Fefe-Nayz/kbhe-monorepo/docs/README.md

# Documentation

- `firmware/` contains firmware protocol and flashing documentation.
- [firmware/overview.md](firmware/overview.md) — build, tools, and **first-time flash of a new board** (DFU, STM32CubeProgrammer, addresses for bootloader vs application, then RAW HID).
- [firmware/raw_hid_usage.md](firmware/raw_hid_usage.md) — everyday flashing over HID after the board is set up.
- `hardware/` contains PCB and mechanical notes.
- [releases.md](releases.md) explains how GitHub release tags map to app and firmware updates.
