Fefe-Nayz/kbhe-monorepo/hardware/pcb/75he/Docs/README.md

# Component Documentation

This folder contains datasheets and reference documents for the current root `75he.kicad_pro` PCB only. Legacy projects keep their own reduced copies under `Legacy/<project>/Docs/`.

## Covered Components

- STM32F723VE MCU: `stm32f723ve.pdf`
- DRV5055 hall-effect sensors: `drv5055-q1.pdf`
- SN74LV4051A analog multiplexers: `sn74lv4051a.pdf`
- SN74AHCT1G125 buffer: `sn74ahct1g125.pdf`
- TS3USB221 USB switch: `ts3usb221a.pdf`
- TPS7A4701 regulator: `tps7a47.pdf`
- LDL1117 regulator: `ldl1117.pdf`
- USBLC6 USB ESD protection: `usblc6-2-3.pdf`
- 1812L300 resettable fuse reference: `Littelfuse-PPTC-Low-Rho-Datasheet.pdf`
- 75HE / Gateron Magnetic Jade switch: `GATERONMagneticJadeProSwitchKS-20TF10B045NW-Y106.pdf`
- WS2812B RGB LED package: `2406131538_XINGLIGHT-XL-5050RGBC-WS2812B-S_C22461793.pdf`
- EC11 encoder: `alps_alps-s-a0008379064-1.pdf`
- USB-C connector: `0EF8F885FCCEA71F60E9E85152155021.pdf`
- SK-12D02VG3 slide switch: `C131374.pdf`
- Red LED C2286: `C2286.pdf`
- Green LED C2297: `C2297.pdf`
- Crystal C280836: `C280836.pdf`
- TS-1088 tactile switch: `C720477.pdf`

## Missing Component Docs

No missing component documentation is currently identified for the root PCB.

## Intentionally Not Documented

Generic passives, solder pads, mounting holes, jumpers, and logos are not tracked as component documentation unless a specific vendor part is required for manufacturing.
