Fefe-Nayz/kbhe-monorepo/hardware/pcb/75he/Legacy/proto-6-key-hall-sensors/Docs/README.md

# Component Documentation

Reduced documentation set for `proto-6-key-hall-sensors`.

## Covered Components

- DRV5055 hall-effect sensors: `drv5055-q1.pdf`
- CD74HC4067SM96 / CD74HC4067 analog multiplexer: `cd74hc4067.pdf`
- WS2812B RGB LEDs: `2406131538_XINGLIGHT-XL-5050RGBC-WS2812B-S_C22461793.pdf`

## Missing Component Docs

No missing component documentation is currently identified for this legacy PCB.

## Intentionally Not Documented

Solder pads and generic prototype interconnects are not tracked as component documentation.
