Fefe-Nayz/kbhe-monorepo/hardware/pcb/75he/Legacy/proto-mcu-v1/Docs/README.md

# Component Documentation

Reduced documentation set for `proto-mcu-v1`.

## Covered Components

- USB-C connector: `0EF8F885FCCEA71F60E9E85152155021.pdf`
- Red LED C2286: `C2286.pdf`
- Crystal C280836: `C280836.pdf`
- STM32F723ZET6 / STM32F723ZE MCU: `stm32f723ze.pdf`
- AMS1117-3.3 regulator, LCSC C6186: `C6186.pdf`
- SMD1812P110TF resettable fuse: `SMD1812-LF-040606.pdf`
- GZ1608D601TF ferrite bead, LCSC C1002: `C1002.pdf`
- SSSF111800 slide switch, LCSC C97450: `C97450.pdf`
- SN74AHCT1G125 buffer: `sn74ahct1g125.pdf`
- USBLC6 USB ESD protection: `usblc6-2-3.pdf`

## Missing Component Docs

No missing component documentation is currently identified for this legacy PCB.

## Intentionally Not Documented

Generic passives, pin headers, solder pads, jumpers, mounting holes, and logos are not tracked as component documentation unless a specific vendor part is required for manufacturing.
