Fefe-Nayz/kbhe-monorepo/(list of files, cad)

Other CAD files:
hardware/3d/current/75HE Assemblage.step
hardware/3d/current/75HE Top Case.step
hardware/3d/current/75HE Knob.step
hardware/3d/current/75HE PCB.step
hardware/3d/current/75HE Switch Plate.step
hardware/3d/current/KEYCAPS.step
hardware/3d/current/75HE Bottom Case.step
hardware/3d/legacy/Switch Plate.step
hardware/3d/legacy/Switch plate (générée automatiquement).step
hardware/3d/legacy/OLD 75HE Bottom Case.step
hardware/3d/legacy/Plate découpage.step
hardware/3d/legacy/75HE Bottom Case.step
hardware/3d/legacy/Bottom Case 75HE.step
hardware/3d/legacy/Bottom Case 75HE test nino.step
hardware/3d/legacy/Case HE keyboard.step
hardware/3d/current/75HE Assemblage.f3z
hardware/3d/current/75HE Assemblage.stl
hardware/3d/current/75HE Bottom Case.f3d
hardware/3d/current/75HE Bottom Case.stl
hardware/3d/current/75HE Knob.f3d
hardware/3d/current/75HE Knob.stl
hardware/3d/current/75HE PCB.f3d
hardware/3d/current/75HE PCB.stl
hardware/3d/current/75HE Switch Plate.f3d
hardware/3d/current/75HE Switch Plate.stl
hardware/3d/current/75HE Top Case.f3d
hardware/3d/current/75HE Top Case.stl
hardware/3d/current/KEYCAPS.f3z
hardware/3d/current/KEYCAPS.stl
hardware/3d/legacy/75HE Bottom Case.f3d
hardware/3d/legacy/75HE Bottom Case.stl
hardware/3d/legacy/Bottom Case 75HE test nino.f3d
hardware/3d/legacy/Bottom Case 75HE test nino.stl
hardware/3d/legacy/Bottom Case 75HE.f3d
hardware/3d/legacy/Bottom Case 75HE.stl
hardware/3d/legacy/Case HE keyboard.f3z
hardware/3d/legacy/Case HE keyboard.stl
hardware/3d/legacy/OLD 75HE Bottom Case.f3d
hardware/3d/legacy/Plate découpage.f3d
hardware/3d/legacy/Plate découpage.stl
hardware/3d/legacy/Switch Plate.f3d
hardware/3d/legacy/Switch Plate.stl
hardware/3d/legacy/Switch plate (générée automatiquement).f3d
hardware/3d/legacy/Switch plate (générée automatiquement).stl
