Fefe-Nayz/kbhe-monorepo/data/firmware/models/v1/20260409_001242_validation_report_errors.csv

index | tension_adc_pts | distance_real_exp_mm | distance_press_exp_mm | distance_press_pred_mm | error_press_mm | abs_error_mm | abs_error_um
0 | 2184.000000 | 16.790000 | 0.005752 | 0.079000 | 0.073248 | 0.073248 | 73.248
1 | 2184.000000 | 16.680000 | 0.115752 | 0.079000 | -0.036752 | 0.036752 | 36.752
2 | 2191.000000 | 16.650000 | 0.145752 | 0.212000 | 0.066248 | 0.066248 | 66.248
3 | 2187.000000 | 16.610000 | 0.185752 | 0.137000 | -0.048752 | 0.048752 | 48.752
4 | 2191.000000 | 16.540000 | 0.255752 | 0.212000 | -0.043752 | 0.043752 | 43.752
5 | 2197.000000 | 16.500000 | 0.295752 | 0.320000 | 0.024248 | 0.024248 | 24.248
6 | 2199.000000 | 16.440000 | 0.355752 | 0.355000 | -0.000752 | 0.000752 | 0.752
7 | 2201.000000 | 16.390000 | 0.405752 | 0.390000 | -0.015752 | 0.015752 | 15.752
8 | 2205.000000 | 16.360000 | 0.435752 | 0.457000 | 0.021248 | 0.021248 | 21.248
9 | 2207.000000 | 16.300000 | 0.495752 | 0.490000 | -0.005752 | 0.005752 | 5.752
10 | 2210.000000 | 16.240000 | 0.555752 | 0.539000 | -0.016752 | 0.016752 | 16.752
11 | 2213.000000 | 16.210000 | 0.585752 | 0.586000 | 0.000248 | 0.000248 | 0.248
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
