Fefe-Nayz/kbhe-monorepo/hardware/pcb/75he/Legacy/proto-mcu-v1/mcu.kicad_pcb

## KiCad design hardware/pcb/75he/Legacy/proto-mcu-v1/mcu.kicad_pcb (2026-04-26, an earlier design)

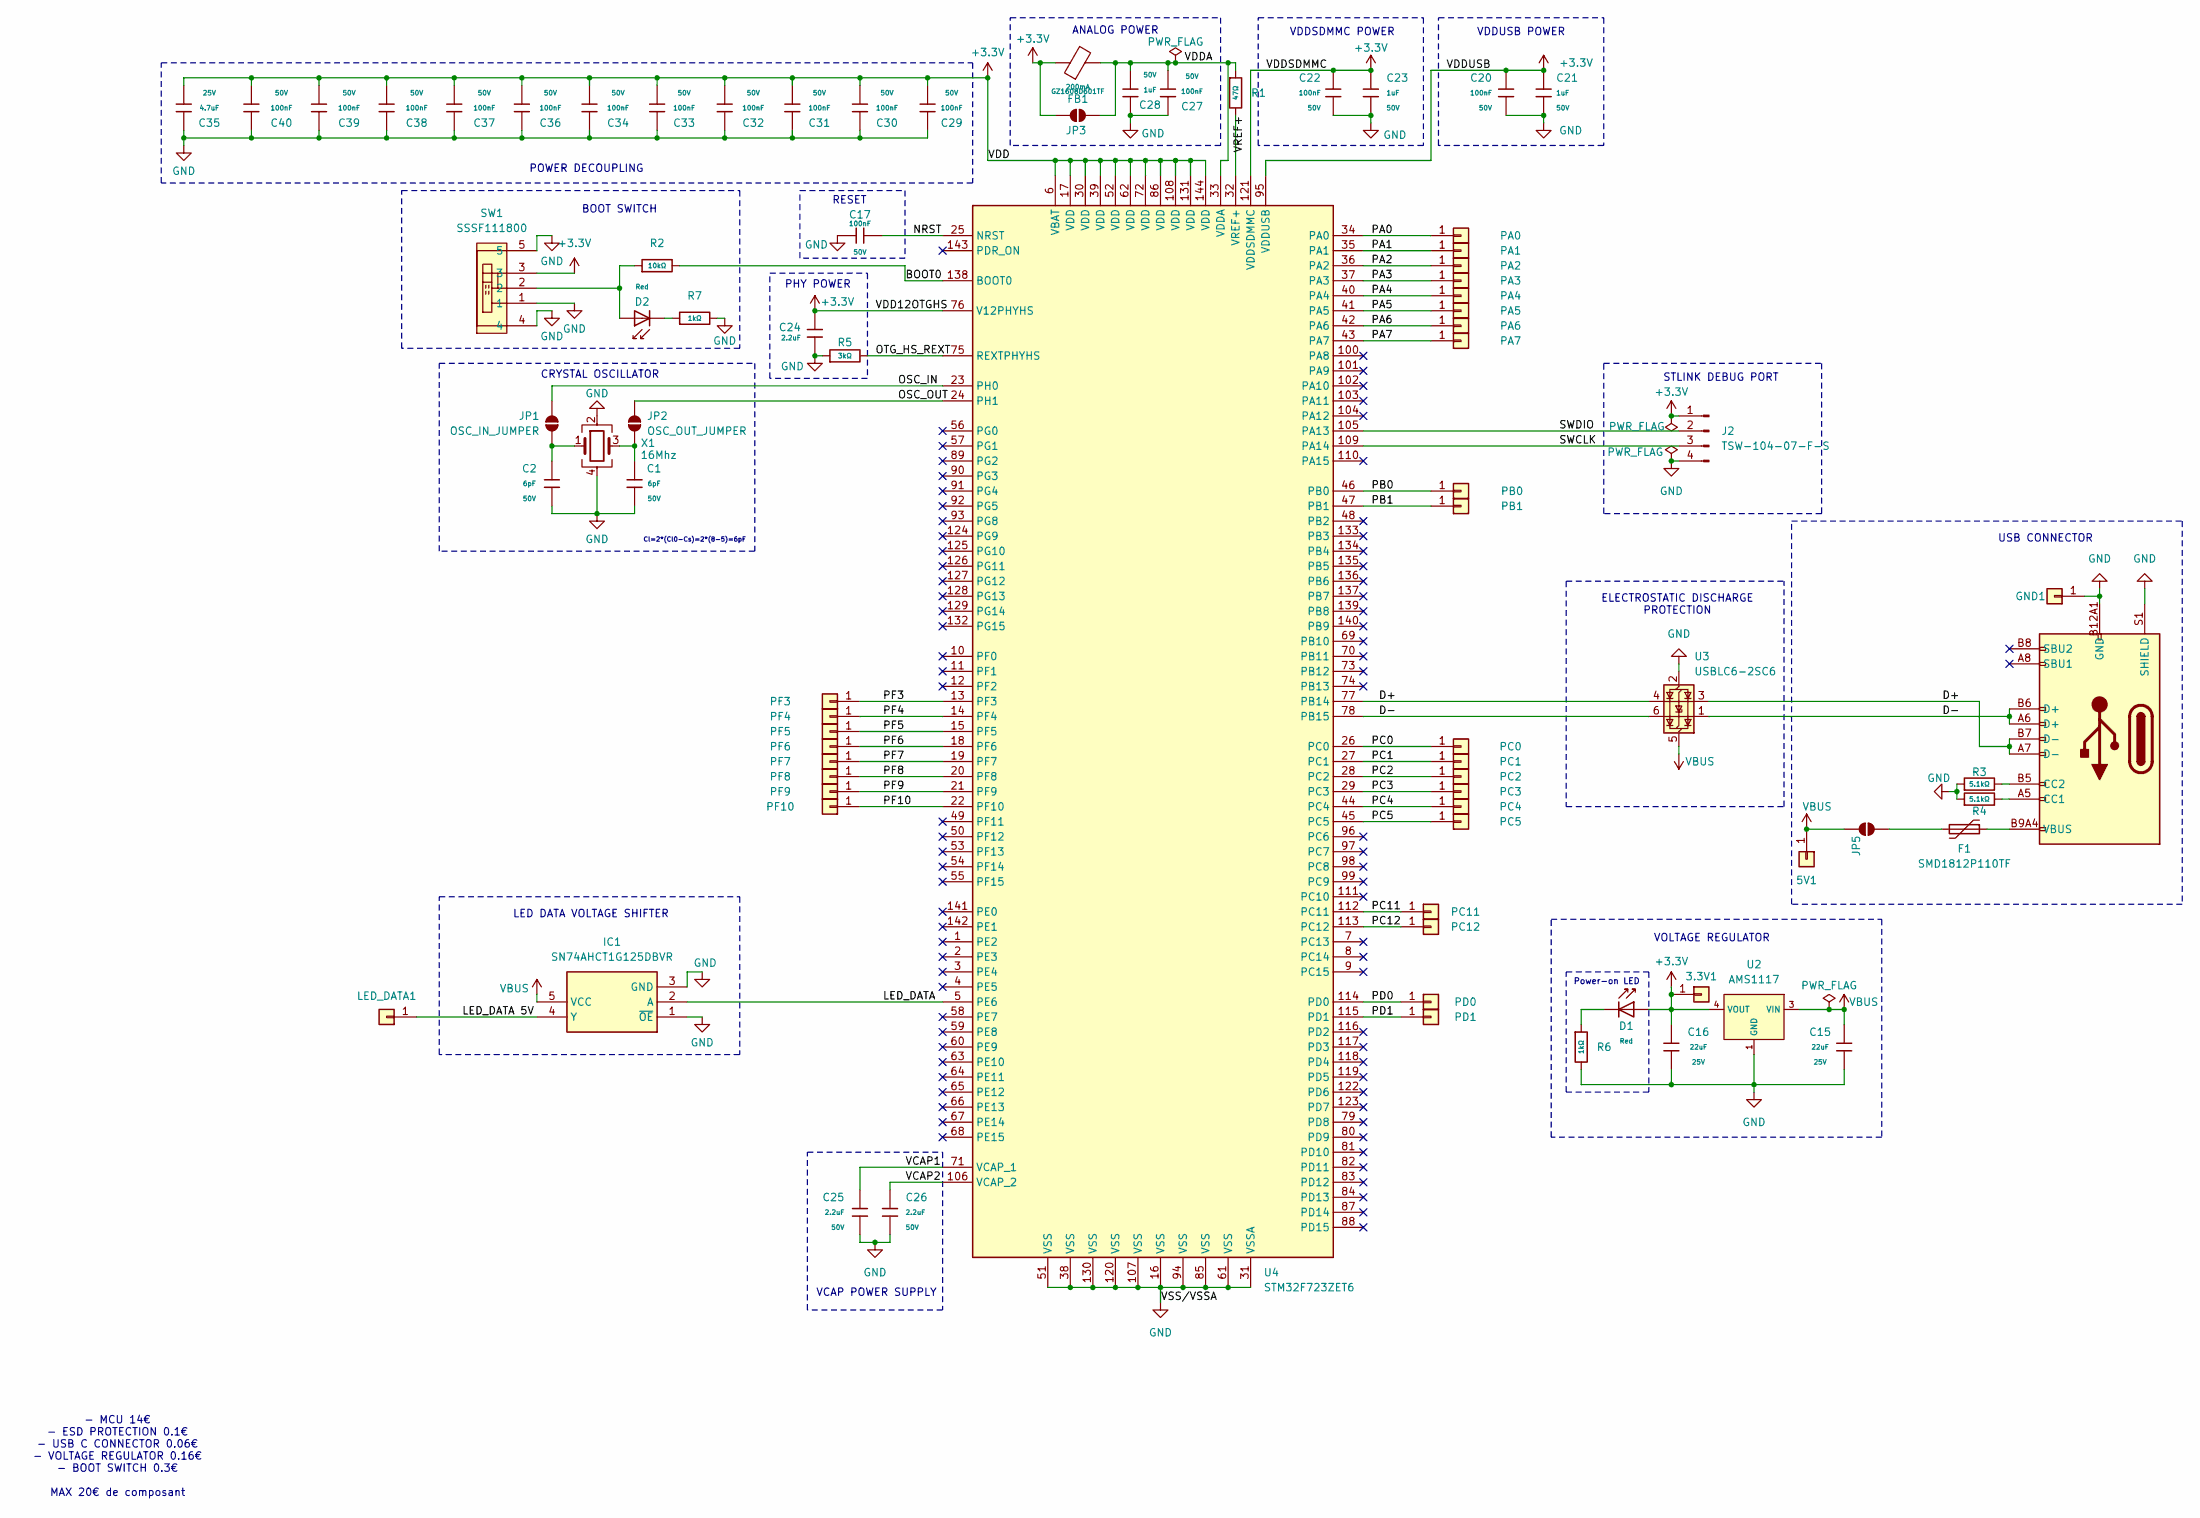
[picture p26: schematic mcu.kicad_sch, Schéma du MCU]

Parts:
3.3V1, 5V1: Conn_01x01; SolderWirePad_1x01_SMD_2x4mm
C1, C2: 6pF; C_0603; Voltage Rated 50V; Tolerance ±5%; Part CL10C100JB8NNNC; LCSC C1634
C15, C16: 22uF; C_0805; Voltage Rated 25V; Tolerance ±20%; Part CL21A226MAQNNNE; LCSC C45783
C17, C20, C22, C27, C29, C30, C31, C32, C33, C34, C36, C37, C38, C39, C40: 100nF; C_0603; Voltage Rated 50V; Tolerance ±10%; Part CC0603KRX7R9BB104; LCSC C14663
C21, C23, C28: 1uF; C_0805; Voltage Rated 50V; Tolerance ±10%; Part CL21B105KBFNNNE; LCSC C28323
C24, C25, C26: 2.2uF; C_0805; Voltage Rated 50V; Tolerance ±10%; Part CL21A225KBQNNNE; LCSC C377773
C35: 4.7uF; C_0805; Voltage Rated 25V; Tolerance ±10%; Part CL21A475KAQNNNE; LCSC C1779
D1, D2: Red; D_0603; Part KT-0603R; LCSC C2286
F1: SMD1812P110TF; Fuse_1812_4532Metric; LCSC C3102
FB1: GZ1608D601TF; FB_0603; Current Rating 200mA; Tolerance ±25%; Part GZ1608D601TF; LCSC C1002
GND1: Conn_01x01; SolderWirePad_1x01_SMD_2x4mm
IC1: SN74AHCT1G125DBVR; SOT95P280X145-5N; Manufacturer_Part_Number SN74AHCT1G125DBVR; Mouser Part Number 595-SNAHCT1G125DBVR
J1: Connector, USB-TYPE-C-16P; TYPE-C-SMD_HX-TYPE-C-16PIN; LCSC C2927039
J2: TSW-104-07-F-S; PinHeader_1x04_P2.54mm_Vertical; LCSC C3329057
JP1: OSC_IN_JUMPER; SolderJumper-2_P1.3mm_Open_RoundedPad1.0x1.5mm
JP2: OSC_OUT_JUMPER; SolderJumper-2_P1.3mm_Open_RoundedPad1.0x1.5mm
JP3: FERRITE_IN_JUMP; SolderJumper-2_P1.3mm_Open_RoundedPad1.0x1.5mm
JP5: VBUS_JP; SolderJumper-2_P1.3mm_Open_RoundedPad1.0x1.5mm
LED_DATA1: Conn_01x01; SolderWirePad_1x01_SMD_2x4mm
PA0, PA1, PA2, PA3, PA4, PA5, PA6, PA7: Conn_01x01; SolderWirePad_1x01_SMD_2x4mm
PB0, PB1: Conn_01x01; SolderWirePad_1x01_SMD_2x4mm
PC0, PC1, PC2, PC3, PC4, PC5, PC11, PC12: Conn_01x01; SolderWirePad_1x01_SMD_2x4mm
PD0, PD1: Conn_01x01; SolderWirePad_1x01_SMD_2x4mm
PF3, PF4, PF5, PF6, PF7, PF8, PF9, PF10: Conn_01x01; SolderWirePad_1x01_SMD_2x4mm
R1: 47Ω; R_0402; Overload Voltage (Max) 50V; Tolerance ±1%; Part 0402WGF470JTCE; LCSC C25118
R2: 10kΩ; R_0402; Overload Voltage (Max) 50V; Tolerance ±1%; Part 0402WGF1002TCE; LCSC C25744
R3, R4: 5.1kΩ; R_0402; Overload Voltage (Max) 50V; Tolerance ±1%; Part 0402WGF5101TCE; LCSC C25905
R5: 3kΩ; R_0805; Overload Voltage (Max) 150V; Tolerance ±1%; Part 0805W8F3001T5E; LCSC C17661
R6, R7: 1kΩ; R_0402; Overload Voltage (Max) 50V; Tolerance ±1%; Part 0402WGF1001TCE; LCSC C11702
SW1: SSSF111800; SW-TH_SSSF111800; LCSC Part C97450
U2: AMS1117; SOT-223-3_L6.5-W3.4-P2.30-LS7.0-BR; Output Voltage 3.3V; Dropout Voltage 1.3V@(800mA); Part AMS1117-3.3; LCSC C6186
U3: USBLC6-2SC6; SOT-23-6; LCSC C7519
U4: STM32F723ZET6; LQFP-144_20x20mm_P0.5mm; LCSC C1340305
X1: 16Mhz; Crystal_SMD_2520-4Pin_2.5x2.0mm; LCSC C280836

Connections:
+3.3V: 3.3V1.1, C16.1, C20.1, C21.2, C22.1, C23.2, C24.1, C29.1, C30.1, C31.1, C32.1, C33.1, C34.1, C35.1, C36.1, C37.1, C38.1, C39.1, C40.1, D1.2, FB1.1, J2.1, JP3.1 (A), SW1.3, U2.2 (VOUT), U2.4 (VOUT), U4.6 (VBAT), U4.17 (VDD), U4.30 (VDD), U4.39 (VDD), U4.52 (VDD), U4.62 (VDD), U4.72 (VDD), U4.76 (V12PHYHS), U4.86 (VDD), U4.95 (VDDUSB), U4.108 (VDD), U4.121 (VDDSDMMC), U4.131 (VDD), U4.144 (VDD)
/BOOT0: R2.2, U4.138 (BOOT0)
/D+: J1.A7 (D-), J1.B7 (D-), U3.3 (I/O2), U3.4 (I/O2), U4.77 (PB14)
/D-: J1.A6 (D+), J1.B6 (D+), U3.1 (I/O1), U3.6 (I/O1), U4.78 (PB15)
/LED_DATA: IC1.2 (A), U4.5 (PE6)
/LED_DATA 5V: IC1.4 (Y), LED_DATA1.1
/NRST: C17.1, U4.25 (NRST)
/OSC_IN: JP1.1 (A), U4.23 (PH0)
/OSC_OUT: JP2.2 (B), U4.24 (PH1)
/OTG_HS_REXT: R5.2, U4.75 (REXTPHYHS)
/PA0: PA0.1, U4.34 (PA0)
/PA1: PA1.1, U4.35 (PA1)
/PA2: PA2.1, U4.36 (PA2)
/PA3: PA3.1, U4.37 (PA3)
/PA4: PA4.1, U4.40 (PA4)
/PA5: PA5.1, U4.41 (PA5)
/PA6: PA6.1, U4.42 (PA6)
/PA7: PA7.1, U4.43 (PA7)
/PB0: PB0.1, U4.46 (PB0)
/PB1: PB1.1, U4.47 (PB1)
/PC0: PC0.1, U4.26 (PC0)
/PC1: PC1.1, U4.27 (PC1)
/PC2: PC2.1, U4.28 (PC2)
/PC3: PC3.1, U4.29 (PC3)
/PC4: PC4.1, U4.44 (PC4)
/PC5: PC5.1, U4.45 (PC5)
/PC11: PC11.1, U4.112 (PC11)
/PC12: PC12.1, U4.113 (PC12)
/PD0: PD0.1, U4.114 (PD0)
/PD1: PD1.1, U4.115 (PD1)
/PF3: PF3.1, U4.13 (PF3)
/PF4: PF4.1, U4.14 (PF4)
/PF5: PF5.1, U4.15 (PF5)
/PF6: PF6.1, U4.18 (PF6)
/PF7: PF7.1, U4.19 (PF7)
/PF8: PF8.1, U4.20 (PF8)
/PF9: PF9.1, U4.21 (PF9)
/PF10: PF10.1, U4.22 (PF10)
/SWCLK: J2.3, U4.109 (PA14)
/SWDIO: J2.2, U4.105 (PA13)
/VCAP1: C25.2, U4.71 (VCAP_1)
/VCAP2: C26.2, U4.106 (VCAP_2)
/VDDA: C27.1, C28.1, FB1.2, JP3.2 (B), R1.1, U4.33 (VDDA)
/VREF+: R1.2, U4.32 (VREF+)
GND: C1.2, C2.2, C15.2, C16.2, C17.2, C20.2, C21.1, C22.2, C23.1, C24.2, C25.1, C26.1, C27.2, C28.2, C29.2, C30.2, C31.2, C32.2, C33.2, C34.2, C35.2, C36.2, C37.2, C38.2, C39.2, C40.2, GND1.1, IC1.1 (~OE), IC1.3 (GND), J1.A12B1 (GND), J1.B12A1 (GND), J1.S1 (SHIELD), J2.4, R3.1, R4.1, R5.1, R6.2, R7.2, SW1.1, SW1.4, SW1.5, U2.1 (GND), U3.2 (GND), U4.16 (VSS), U4.31 (VSSA), U4.38 (VSS), U4.51 (VSS), U4.61 (VSS), U4.85 (VSS), U4.94 (VSS), U4.107 (VSS), U4.120 (VSS), U4.130 (VSS), X1.2, X1.4
unnamed: D1.1, R6.1
unnamed: D2.1, R7.1
unnamed: D2.2, R2.1, SW1.2
unnamed: F1.1, J1.A9B4 (VBUS), J1.B9A4 (VBUS)
unnamed: J1.A5 (CC1), R4.2
unnamed: J1.B5 (CC2), R3.2
unnamed: C2.1, JP1.2 (B), X1.1
unnamed: C1.1, JP2.1 (A), X1.3
unnamed: F1.2, JP5.2 (B)
VBUS: 5V1.1, C15.1, IC1.5 (VCC), JP5.1 (A), U2.3 (VIN), U3.5 (VBUS)

Notes on the sheet:
STLINK DEBUG PORT
VDDSDMMC POWER
PHY POWER
LED DATA VOLTAGE SHIFTER
USB CONNECTOR
VCAP POWER SUPPLY
ELECTROSTATIC DISCHARGE PROTECTION
VOLTAGE REGULATOR
POWER DECOUPLING
Cl=2*(Cl0-Cs)=2*(8-5)=6pF
Power-on LED
- MCU 14€ - ESD PROTECTION 0.1€ - USB C CONNECTOR 0.06€ - VOLTAGE REGULATOR 0.16€ - BOOT SWITCH 0.3€ MAX 20€ de composant
BOOT SWITCH
CRYSTAL OSCILLATOR
ANALOG POWER
RESET
VDDUSB POWER

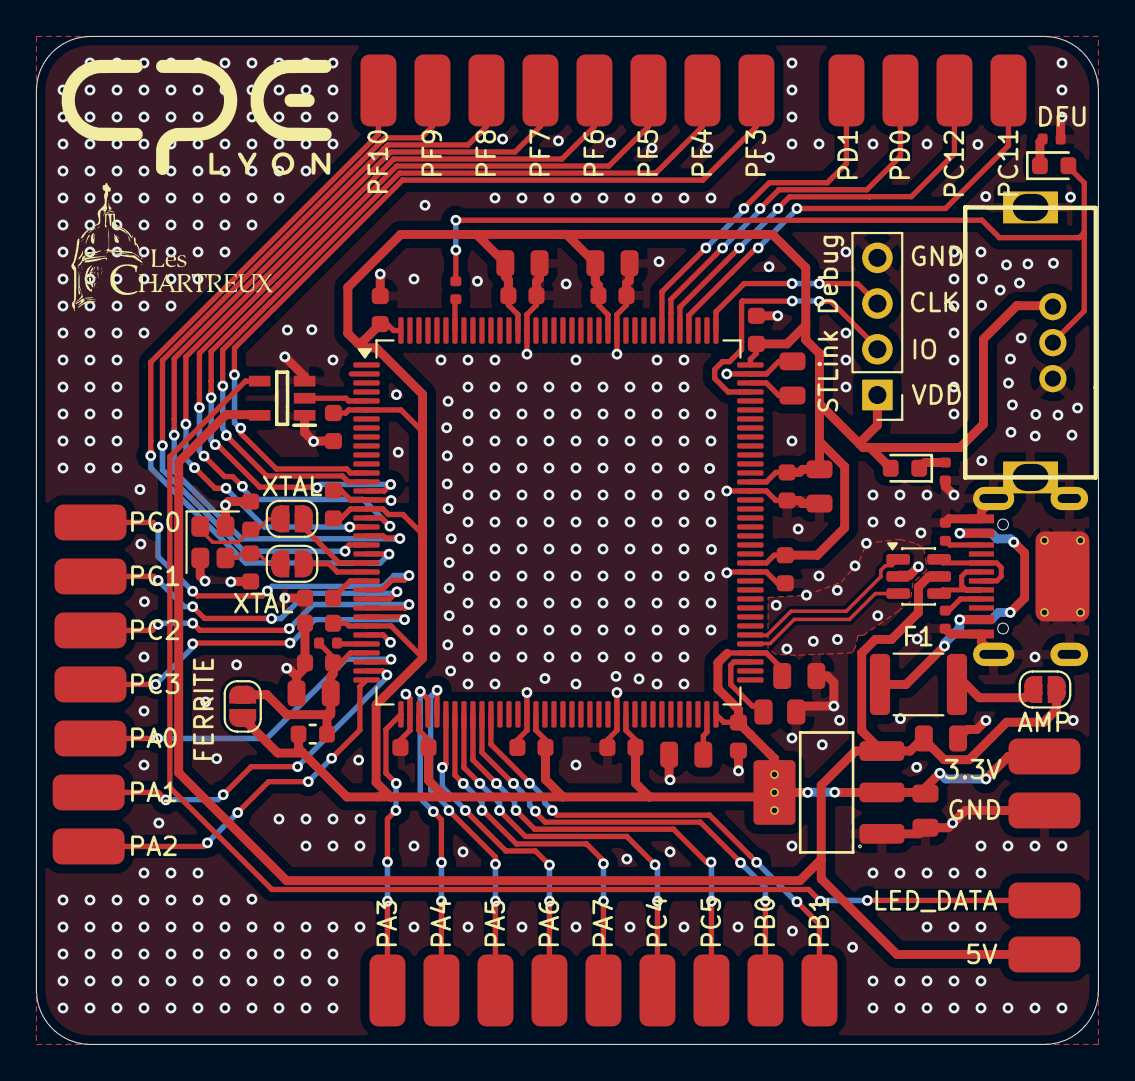
[picture p27: board hardware/pcb/75he/Legacy/proto-mcu-v1/mcu.kicad_pcb from above]

Board: 2 copper layers, 59.0 x 56.0 mm, 81 parts (0 on the bottom side), 55 nets.
