Fefe-Nayz/kbhe-monorepo/hardware/pcb/75he/Legacy/proto-mcu-v2/mcu.kicad_pcb

## KiCad design hardware/pcb/75he/Legacy/proto-mcu-v2/mcu.kicad_pcb (2026-04-26, an earlier design)

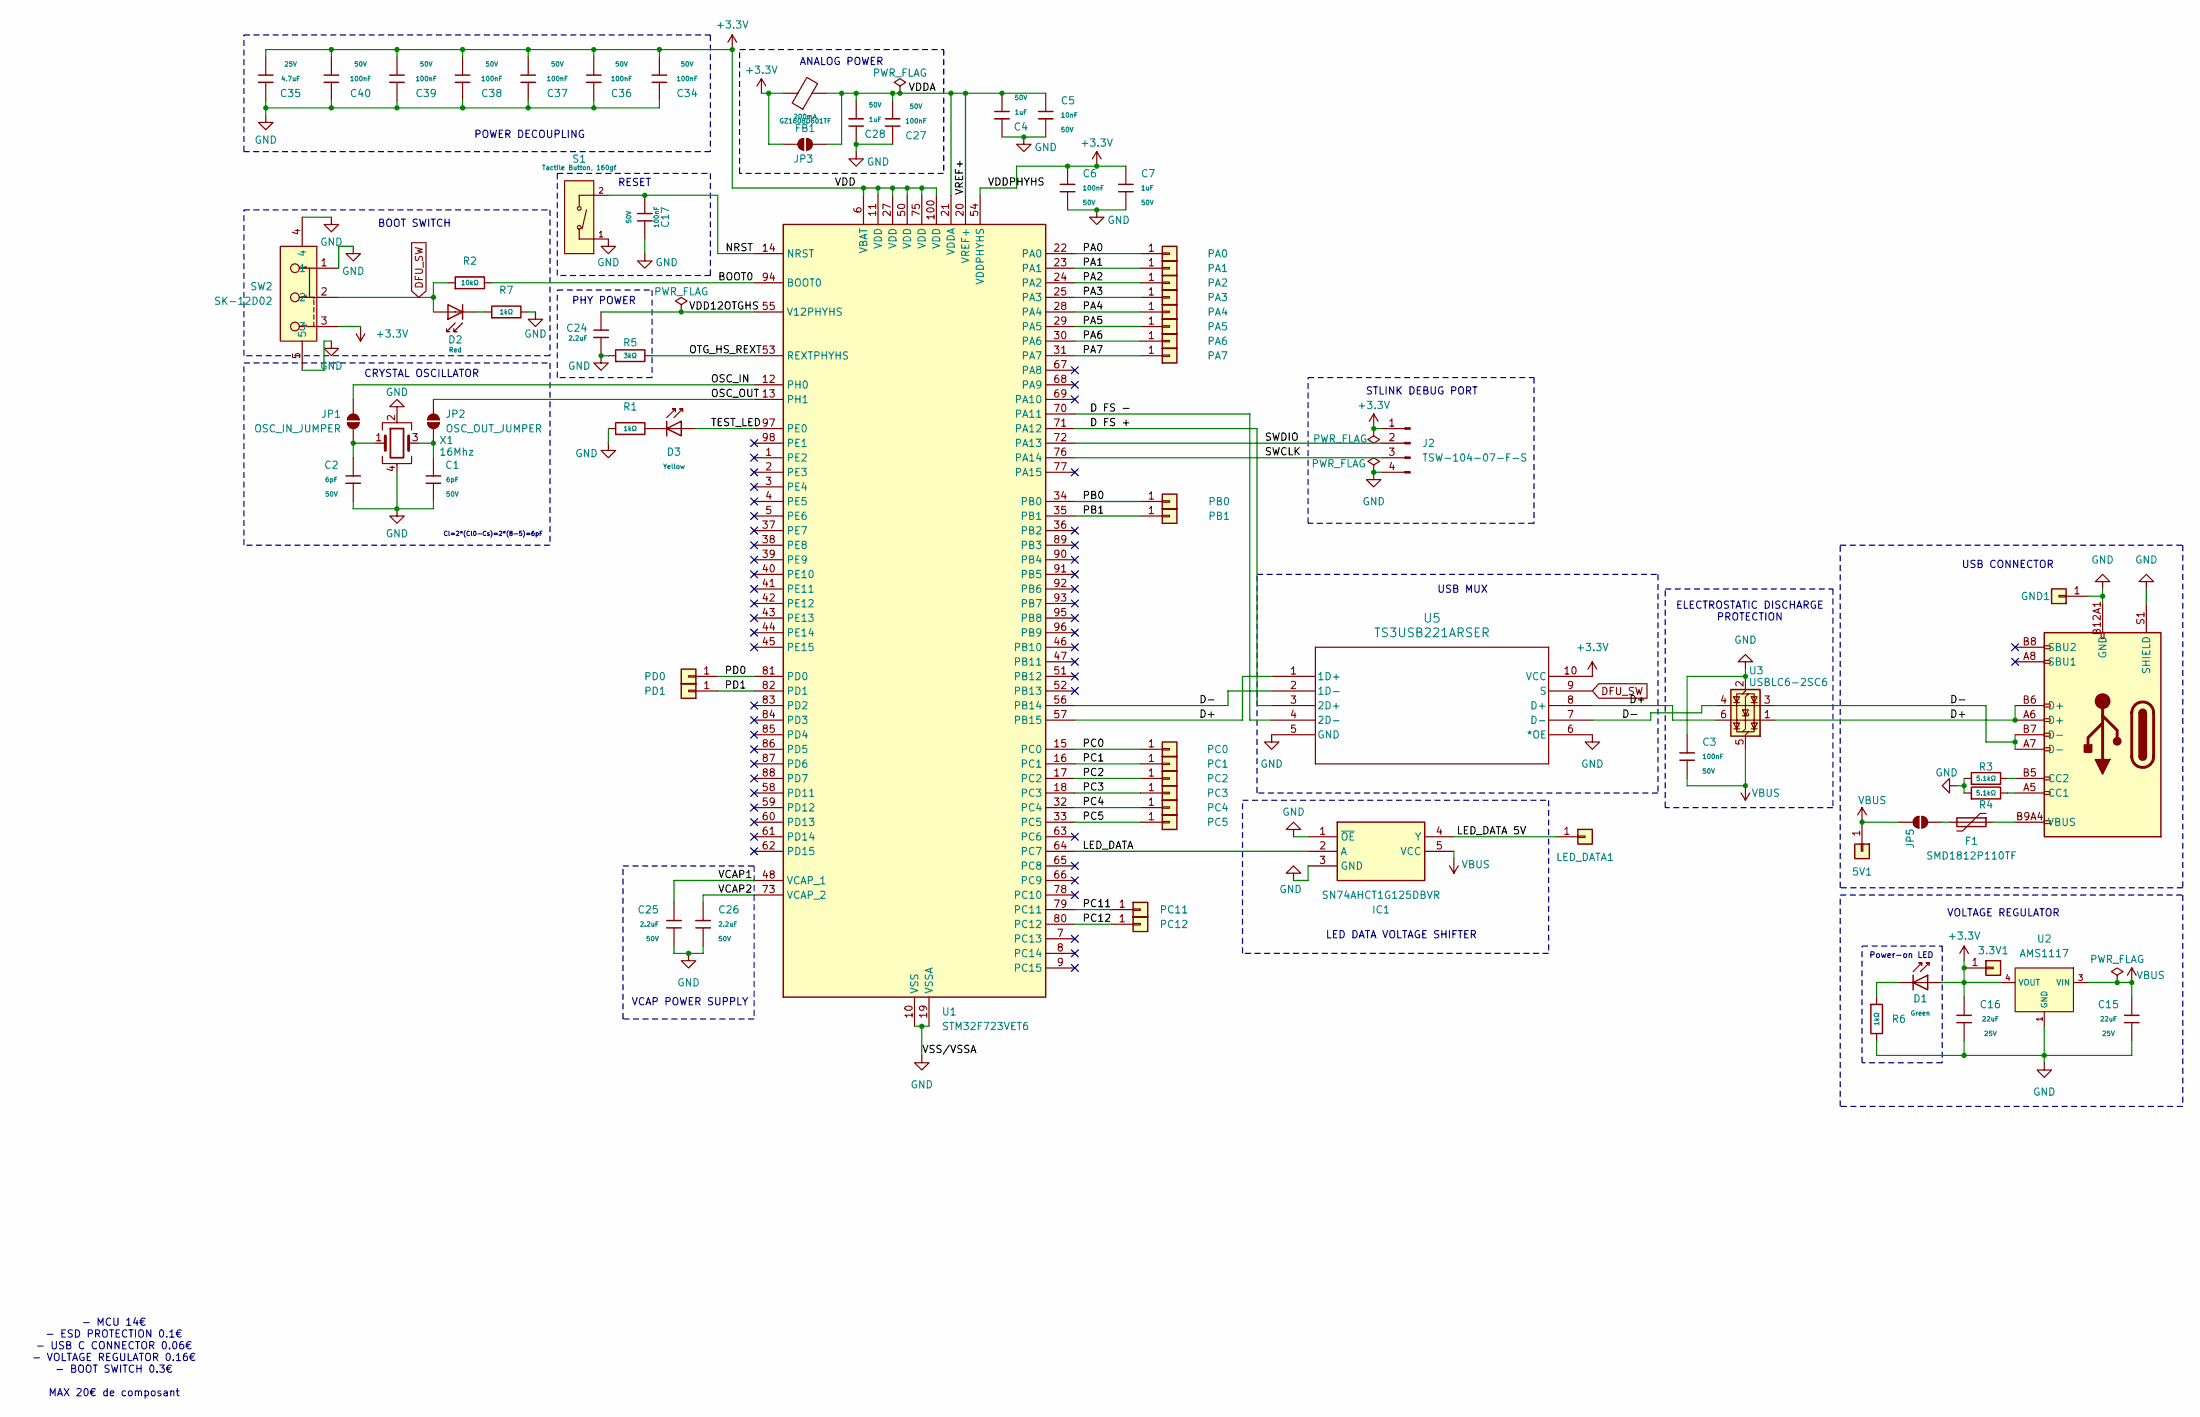
[picture p28: schematic mcu.kicad_sch, Schéma du MCU]

Parts:
3.3V1, 5V1: Conn_01x01; SolderWirePad_1x01_SMD_2x4mm
C1, C2: 6pF; C_0603; Voltage Rated 50V; Tolerance ±5%; Part CL10C100JB8NNNC; LCSC C1634
C3, C6, C17, C27, C34, C36, C37, C38, C39, C40: 100nF; C_0603; Voltage Rated 50V; Tolerance ±10%; Part CC0603KRX7R9BB104; LCSC C14663
C4, C7, C28: 1uF; C_0805; Voltage Rated 50V; Tolerance ±10%; Part CL21B105KBFNNNE; LCSC C28323
C5: 10nF; C_0402; Voltage Rated 50V; Tolerance ±10%; Part CL05B103KB5NNNC; LCSC C15195
C15, C16: 22uF; C_0805; Voltage Rated 25V; Tolerance ±20%; Part CL21A226MAQNNNE; LCSC C45783
C24, C25, C26: 2.2uF; C_0805; Voltage Rated 50V; Tolerance ±10%; Part CL21A225KBQNNNE; LCSC C377773
C35: 4.7uF; C_0805; Voltage Rated 25V; Tolerance ±10%; Part CL21A475KAQNNNE; LCSC C1779
D1: Green; D_0805; Part KT-0805G; LCSC C2297
D2: Red; D_0603; Part KT-0603R; LCSC C2286
D3: Yellow; D_0603; Forward Voltage (VF) 1.6V~2.6V; Part NCD0603Y2; LCSC C89811
F1: SMD1812P110TF; Fuse_1812_4532Metric; LCSC C3102
FB1: GZ1608D601TF; FB_0603; Current Rating 200mA; Tolerance ±25%; Part GZ1608D601TF; LCSC C1002
GND1: Conn_01x01; SolderWirePad_1x01_SMD_2x4mm
IC1: SN74AHCT1G125DBVR; SOT95P280X145-5N; Manufacturer_Part_Number SN74AHCT1G125DBVR; Mouser Part Number 595-SNAHCT1G125DBVR
J1: Connector, USB-TYPE-C-16P; TYPE-C-SMD_HX-TYPE-C-16PIN; LCSC C2927039
J2: TSW-104-07-F-S; PinHeader_1x04_P2.54mm_Vertical; LCSC C3329057
JP1: OSC_IN_JUMPER; SolderJumper-2_P1.3mm_Open_RoundedPad1.0x1.5mm
JP2: OSC_OUT_JUMPER; SolderJumper-2_P1.3mm_Open_RoundedPad1.0x1.5mm
JP3: FERRITE_IN_JUMP; SolderJumper-2_P1.3mm_Open_RoundedPad1.0x1.5mm
JP5: VBUS_JP; SolderJumper-2_P1.3mm_Open_RoundedPad1.0x1.5mm
LED_DATA1: Conn_01x01; SolderWirePad_1x01_SMD_2x4mm
PA0, PA1, PA2, PA3, PA4, PA5, PA6, PA7: Conn_01x01; SolderWirePad_1x01_SMD_2x4mm
PB0, PB1: Conn_01x01; SolderWirePad_1x01_SMD_2x4mm
PC0, PC1, PC2, PC3, PC4, PC5, PC11, PC12: Conn_01x01; SolderWirePad_1x01_SMD_2x4mm
PD0, PD1: Conn_01x01; SolderWirePad_1x01_SMD_2x4mm
R1, R6, R7: 1kΩ; R_0402; Overload Voltage (Max) 50V; Tolerance ±1%; Part 0402WGF1001TCE; LCSC C11702
R2: 10kΩ; R_0402; Overload Voltage (Max) 50V; Tolerance ±1%; Part 0402WGF1002TCE; LCSC C25744
R3, R4: 5.1kΩ; R_0402; Overload Voltage (Max) 50V; Tolerance ±1%; Part 0402WGF5101TCE; LCSC C25905
R5: 3kΩ; R_0805; Overload Voltage (Max) 150V; Tolerance ±1%; Part 0805W8F3001T5E; LCSC C17661
S1: Tactile Button, 160gf; SW_TS-1088-AR02016; Voltage Rating (Dc) 12V; Part TS-1088-AR02016; LCSC C720477
SW2: SK-12D02; SW-TH_SK-12D02VG3; LCSC Part C131374
U1: STM32F723VET6; LQFP-100_14x14mm_P0.5mm; LCSC C5270022
U2: AMS1117; SOT-223-3_L6.5-W3.4-P2.30-LS7.0-BR; Output Voltage 3.3V; Dropout Voltage 1.3V@(800mA); Part AMS1117-3.3; LCSC C6186
U3: USBLC6-2SC6; SOT-23-6; LCSC C7519
U5: TS3USB221ARSER; RSE10
X1: 16Mhz; Crystal_SMD_2520-4Pin_2.5x2.0mm; LCSC C280836

Connections:
+3.3V: 3.3V1.1, C6.1, C7.1, C16.1, C34.1, C35.1, C36.1, C37.1, C38.1, C39.1, C40.1, D1.2, FB1.1, J2.1, JP3.1 (A), SW2.3, U1.6 (VBAT), U1.11 (VDD), U1.27 (VDD), U1.50 (VDD), U1.54 (VDDPHYHS), U1.75 (VDD), U1.100 (VDD), U2.2 (VOUT), U2.4 (VOUT), U5.10 (VCC)
/BOOT0: R2.2, U1.94 (BOOT0)
/D FS +: U1.71 (PA12), U5.3 (2D+)
/D FS -: U1.70 (PA11), U5.4 (2D-)
/D+: J1.A6 (D+), J1.B6 (D+), U1.57 (PB15), U3.1 (I/O1), U3.6 (I/O1), U5.1 (1D+), U5.8 (D+)
/D-: J1.A7 (D-), J1.B7 (D-), U1.56 (PB14), U3.3 (I/O2), U3.4 (I/O2), U5.2 (1D-), U5.7 (D-)
/LED_DATA: IC1.2 (A), U1.64 (PC7)
/LED_DATA 5V: IC1.4 (Y), LED_DATA1.1
/NRST: C17.2, S1.2 (B), U1.14 (NRST)
/OSC_IN: JP1.1 (A), U1.12 (PH0)
/OSC_OUT: JP2.2 (B), U1.13 (PH1)
/OTG_HS_REXT: R5.2, U1.53 (REXTPHYHS)
/PA0: PA0.1, U1.22 (PA0)
/PA1: PA1.1, U1.23 (PA1)
/PA2: PA2.1, U1.24 (PA2)
/PA3: PA3.1, U1.25 (PA3)
/PA4: PA4.1, U1.28 (PA4)
/PA5: PA5.1, U1.29 (PA5)
/PA6: PA6.1, U1.30 (PA6)
/PA7: PA7.1, U1.31 (PA7)
/PB0: PB0.1, U1.34 (PB0)
/PB1: PB1.1, U1.35 (PB1)
/PC0: PC0.1, U1.15 (PC0)
/PC1: PC1.1, U1.16 (PC1)
/PC2: PC2.1, U1.17 (PC2)
/PC3: PC3.1, U1.18 (PC3)
/PC4: PC4.1, U1.32 (PC4)
/PC5: PC5.1, U1.33 (PC5)
/PC11: PC11.1, U1.79 (PC11)
/PC12: PC12.1, U1.80 (PC12)
/PD0: PD0.1, U1.81 (PD0)
/PD1: PD1.1, U1.82 (PD1)
/SWCLK: J2.3, U1.76 (PA14)
/SWDIO: J2.2, U1.72 (PA13)
/TEST_LED: D3.2, U1.97 (PE0)
/VCAP1: C25.2, U1.48 (VCAP_1)
/VCAP2: C26.2, U1.73 (VCAP_2)
/VDD12OTGHS: C24.1, U1.55 (V12PHYHS)
/VDDA: C4.1, C5.1, C27.1, C28.1, FB1.2, JP3.2 (B), U1.20 (VREF+), U1.21 (VDDA)
DFU_SW: D2.2, R2.1, SW2.2, U5.9 (S)
GND: C1.2, C2.2, C3.1, C4.2, C5.2, C6.2, C7.2, C15.2, C16.2, C17.1, C24.2, C25.1, C26.1, C27.2, C28.2, C34.2, C35.2, C36.2, C37.2, C38.2, C39.2, C40.2, GND1.1, IC1.1 (~OE), IC1.3 (GND), J1.A12B1 (GND), J1.B12A1 (GND), J1.S1 (SHIELD), J2.4, R1.1, R3.1, R4.1, R5.1, R6.2, R7.2, S1.1 (A), SW2.1, SW2.4, SW2.5, U1.10 (VSS), U1.19 (VSSA), U1.26 (VSS), U1.49 (VSS), U1.74 (VSS), U1.99 (VSS), U2.1 (GND), U3.2 (GND), U5.5 (GND), U5.6 (*OE), X1.2, X1.4
unnamed: D1.1, R6.1
unnamed: D2.1, R7.1
unnamed: D3.1, R1.2
unnamed: F1.1, J1.A9B4 (VBUS), J1.B9A4 (VBUS)
unnamed: J1.A5 (CC1), R4.2
unnamed: J1.B5 (CC2), R3.2
unnamed: C2.1, JP1.2 (B), X1.1
unnamed: C1.1, JP2.1 (A), X1.3
unnamed: F1.2, JP5.2 (B)
VBUS: 5V1.1, C3.2, C15.1, IC1.5 (VCC), JP5.1 (A), U2.3 (VIN), U3.5 (VBUS)

Notes on the sheet:
STLINK DEBUG PORT
PHY POWER
USB CONNECTOR
LED DATA VOLTAGE SHIFTER
VCAP POWER SUPPLY
ELECTROSTATIC DISCHARGE PROTECTION
VOLTAGE REGULATOR
POWER DECOUPLING
USB MUX
Cl=2*(Cl0-Cs)=2*(8-5)=6pF
Power-on LED
- MCU 14€ - ESD PROTECTION 0.1€ - USB C CONNECTOR 0.06€ - VOLTAGE REGULATOR 0.16€ - BOOT SWITCH 0.3€ MAX 20€ de composant
BOOT SWITCH
CRYSTAL OSCILLATOR
ANALOG POWER
RESET

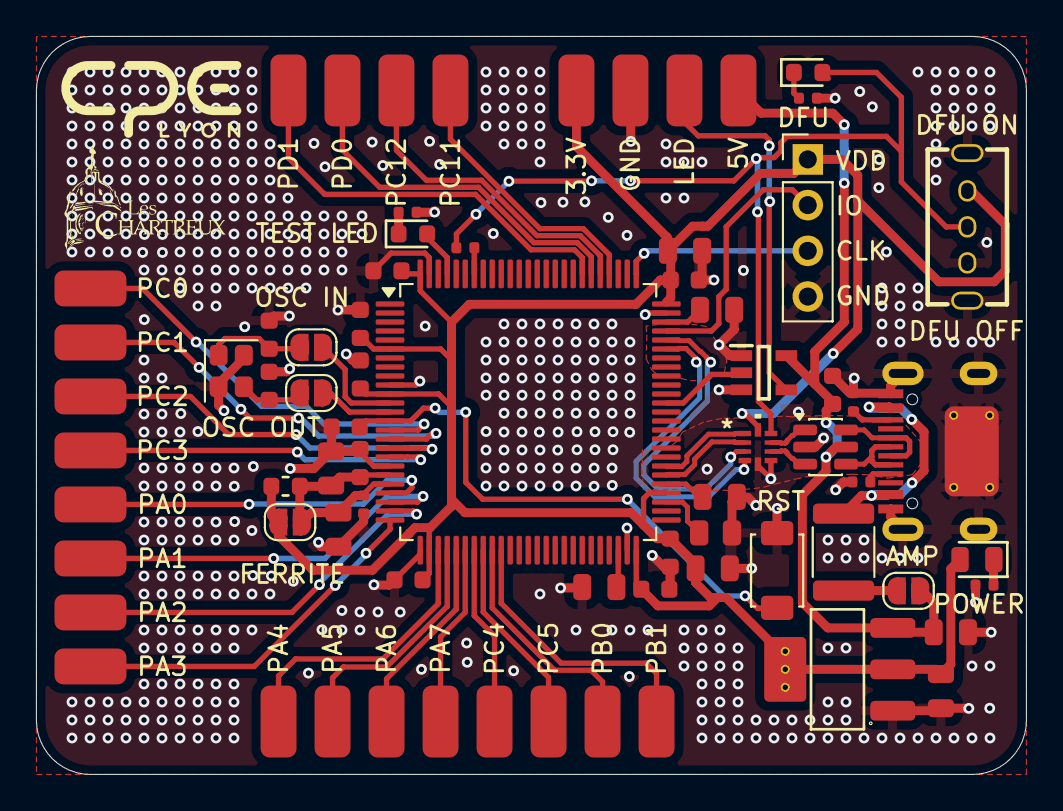
[picture p29: board hardware/pcb/75he/Legacy/proto-mcu-v2/mcu.kicad_pcb from above]

Board: 2 copper layers, 55.0 x 41.0 mm, 72 parts (0 on the bottom side), 51 nets.
