Fefe-Nayz/kbhe-monorepo/hardware/pcb/75he/Legacy/proto-6-key-hall-sensors/proto_pcb.kicad_pcb

## KiCad design hardware/pcb/75he/Legacy/proto-6-key-hall-sensors/proto_pcb.kicad_pcb (2026-04-26, an earlier design)

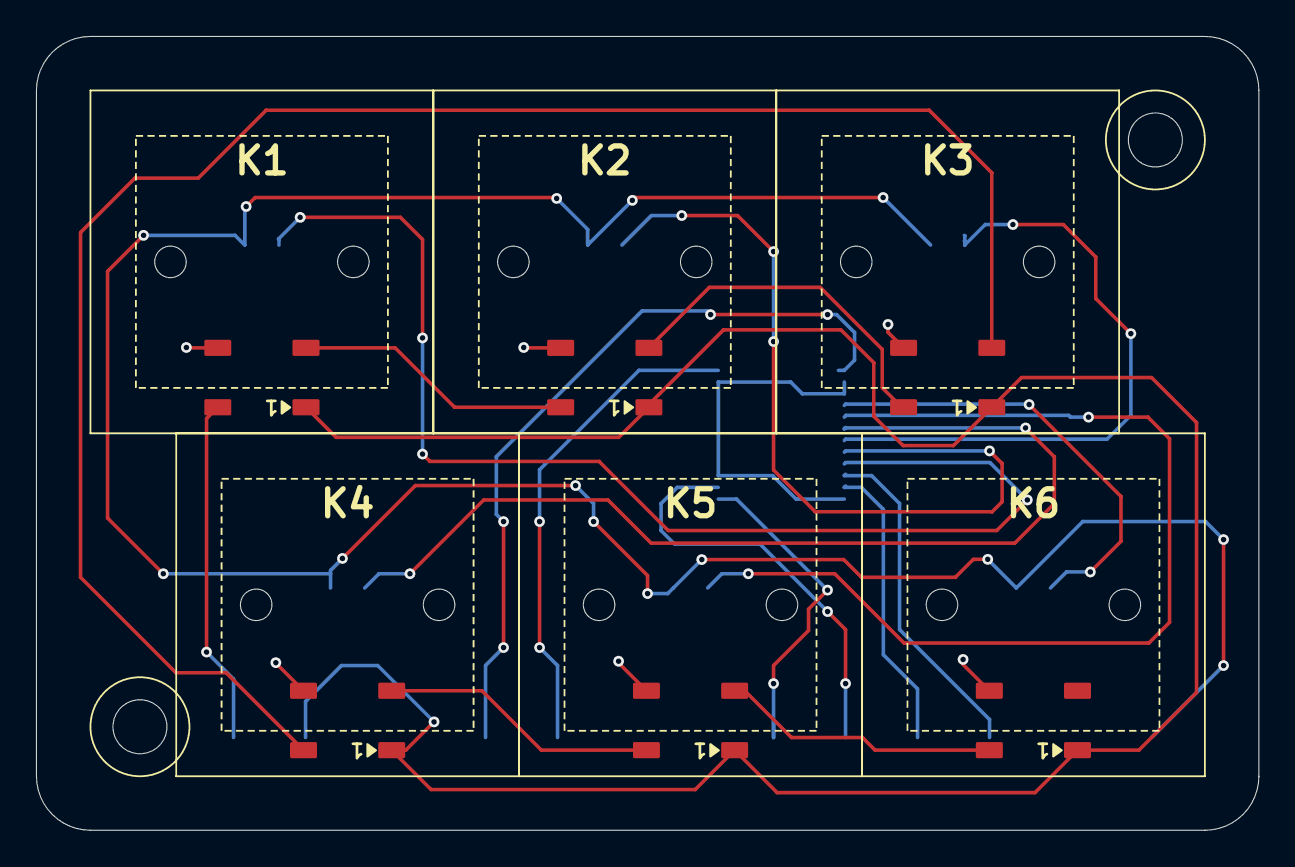
[picture p30: board proto_pcb.kicad_pcb from above]

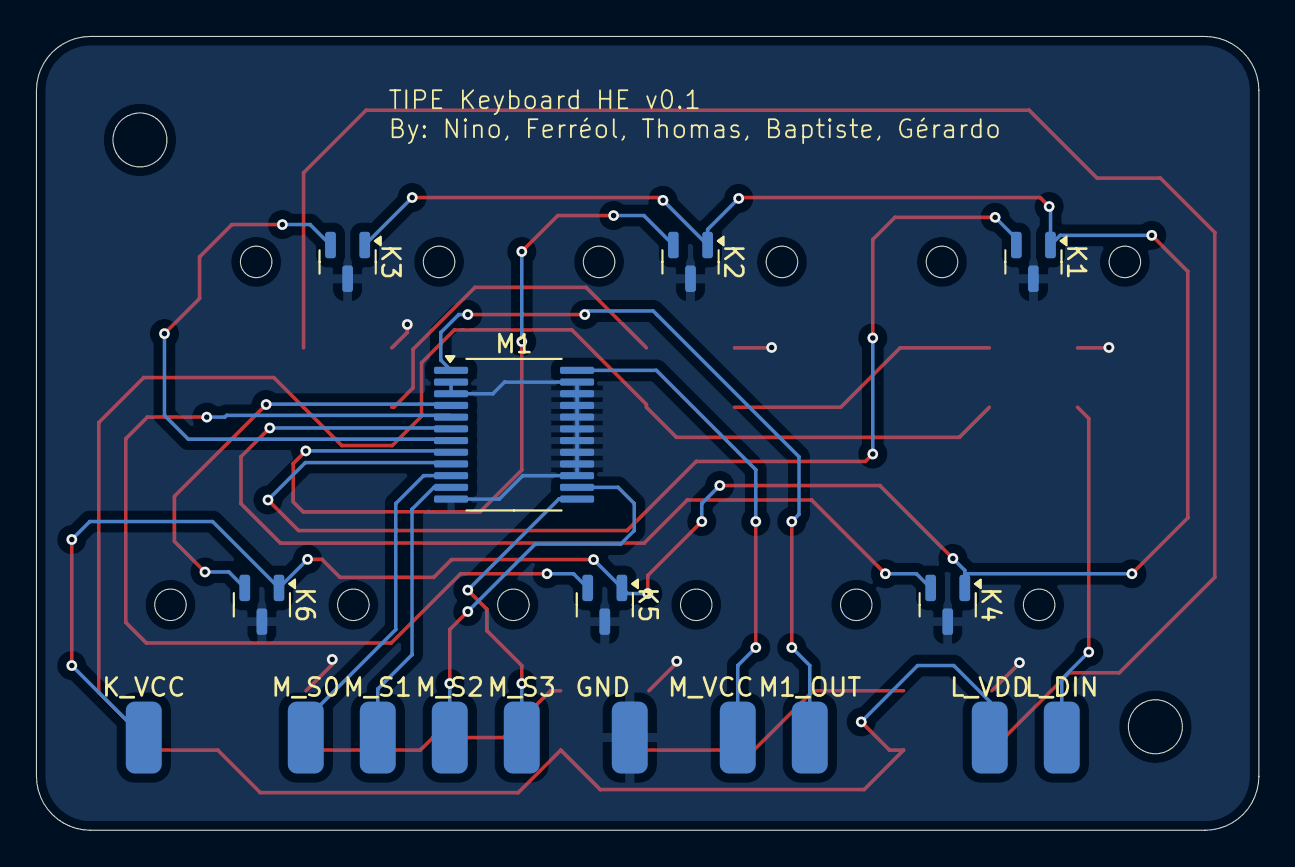
[picture p31: board proto_pcb.kicad_pcb from below]

Board: 2 copper layers, 67.9 x 44.1 mm, 23 parts (17 on the bottom side), 21 nets.

Parts:
GND: SolderWirePad_1x01_SMD_2x4mm
K1, K2, K3, K4, K5, K6: DRV5055A4QDBZR; SOT-23
K_VCC: SolderWirePad_1x01_SMD_2x4mm
L1, L2, L3, L4, L5, L6: XL-5050RGBC-2812B-S; LED_WS2812B_PLCC4_5.0x5.0mm_P3.2mm
L_DIN: SolderWirePad_1x01_SMD_2x4mm
L_VDD: SolderWirePad_1x01_SMD_2x4mm
M1: CD74HC4067SM96; SSOP-24_5.3x8.2mm_P0.65mm
M1_OUT: SolderWirePad_1x01_SMD_2x4mm
M_S0, M_S1, M_S2, M_S3: SolderWirePad_1x01_SMD_2x4mm
M_VCC: SolderWirePad_1x01_SMD_2x4mm

Connections:
GND: GND.10, K1.3 (GND), K2.3 (GND), K3.3 (GND), K4.3 (GND), K5.3 (GND), K6.3 (GND), L1.3 (VSS), L2.3 (VSS), L3.3 (VSS), L4.3 (VSS), L5.3 (VSS), L6.3 (VSS), M1.2 (I7), M1.3 (I6), M1.12 (GND), M1.15 (~E), M1.16 (I15), M1.17 (I14), M1.18 (I13), M1.19 (I12), M1.20 (I11), M1.21 (I10), M1.22 (I9), M1.23 (I8)
K1_OUT: K1.2 (OUT), M1.9 (I0)
K2_OUT: K2.2 (OUT), M1.8 (I1)
K3_OUT: K3.2 (OUT), M1.7 (I2)
K4_OUT: K4.2 (OUT), M1.6 (I3)
K5_OUT: K5.2 (OUT), M1.5 (I4)
K6_OUT: K6.2 (OUT), M1.4 (I5)
K_VCC: K1.1 (VCC), K2.1 (VCC), K3.1 (VCC), K4.1 (VCC), K5.1 (VCC), K6.1 (VCC), K_VCC.8
L_DIN: L1.4 (DIN), L_DIN.5
L_VDD: L1.1 (VDD), L2.1 (VDD), L3.1 (VDD), L4.1 (VDD), L5.1 (VDD), L6.1 (VDD), L_VDD.9
M1_OUT: M1.1 (COM), M1_OUT.6
M_S0: M1.10 (S0), M_S0.1
M_S1: M1.11 (S1), M_S1.2
M_S2: M1.14 (S2), M_S2.3
M_S3: M1.13 (S3), M_S3.4
M_VCC: M1.24 (VCC), M_VCC.7
unnamed: L1.2 (DOUT), L2.4 (DIN)
unnamed: L2.2 (DOUT), L3.4 (DIN)
unnamed: L3.2 (DOUT), L4.4 (DIN)
unnamed: L4.2 (DOUT), L5.4 (DIN)
unnamed: L5.2 (DOUT), L6.4 (DIN)
