Fefe-Nayz/kbhe-monorepo/firmware/Core/Inc/trigger/trigger.h

#ifndef TRIGGER_TRIGGER_H_
#define TRIGGER_TRIGGER_H_

#include <stdbool.h>
#include <stdint.h>

#include "settings.h"

// Actuation point in µm
#define DEFAULT_ACTUATION_POINT 1200 // 1.2mm
#define DEFAULT_RELEASE_POINT 1100   // 1.1mm

// Rapid trigger sensitivity in µm (distance from actuation point to trigger)
#define DEFAULT_RAPID_TRIGGER_SENSITIVITY 200 // 0.2mm

typedef struct {
    uint16_t primary_keycode;
    uint16_t actuation_point;
    uint16_t release_point;
    
    // Rapid trigger settings
    bool is_rapid_trigger_enabled;
    bool continuous_rapid_trigger;
    uint16_t rapid_trigger_press_sensitivity;
    uint16_t rapid_trigger_release_sensitivity;

    // Advanced per-key behaviors
    key_behavior_mode_t behavior_mode;
    uint16_t hold_threshold_ms;
    uint16_t secondary_keycode;
    bool tap_hold_hold_on_other_key_press;
    bool tap_hold_uppercase_hold;
    uint8_t dynamic_bottom_out_point_tenths;
    settings_dynamic_zone_t dynamic_zones[SETTINGS_DYNAMIC_ZONE_COUNT];
} key_trigger_settings_t;

typedef struct {
    int16_t last_distance;
    int16_t max_bottom_distance;
    int16_t min_top_distance;
    bool continuous_armed;
} key_rapid_trigger_data_t;

typedef struct {
    uint32_t press_start_ms;
    uint16_t active_keycode;
    uint16_t pending_release_keycode;
    key_behavior_mode_t pressed_behavior_mode;
    uint16_t dks_generation;
    uint32_t dks_candidate_since_ms;
    bool dks_is_bottomed_out;
    bool dks_candidate_active;
    bool dks_candidate_bottomed_out;
    bool dks_binding_pressed[SETTINGS_DYNAMIC_ZONE_COUNT];
    bool tap_hold_secondary_active;
    bool tap_hold_uppercase_active;
    bool tap_hold_pending;
    bool toggle_latched;
    bool toggle_hold_active;
    bool toggle_pending;
    bool socd_output_suppressed;
} key_behavior_runtime_t;

typedef enum key_state_e {
    RELEASED = 0,
    PRESSED = 1,
} key_state_e;

typedef enum {
    KEY_DIRECTION_NONE = 0,
    KEY_DIRECTION_DOWN = 1,
    KEY_DIRECTION_UP = 2
} key_direction_e;


void trigger_init(void);

void trigger_task(void);

key_state_e trigger_get_key_state(uint8_t key);

/* True only when every physical key is released and no transition has been
 * accepted during the requested quiet interval. Persistence uses this to
 * keep single-bank Flash stalls out of the live input path. */
bool trigger_is_input_idle(uint32_t now_ms, uint32_t quiet_period_ms);

/* Apply or suppress the active output of a normal key without changing its
 * physical trigger state. Used exclusively by SOCD resolution. */
void trigger_socd_set_key_output(uint8_t key, bool pressed);

uint16_t trigger_get_distance_01mm(uint8_t key);

void trigger_reload_settings(void);

/* Refresh one key from the currently active layer. This keeps interactive HID
 * edits bounded instead of rebuilding all NUM_KEYS trigger records. */
void trigger_reload_key_settings(uint8_t key);

void trigger_apply_key_settings(uint8_t key, const settings_key_t *settings);

bool trigger_set_chatter_guard(bool enabled, uint8_t duration_ms);

void trigger_get_chatter_guard(bool *enabled, uint8_t *duration_ms);

#endif /* TRIGGER_TRIGGER_H_ */
