Fefe-Nayz/kbhe-monorepo/firmware/Core/Src/main.c

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
/* Includes ------------------------------------------------------------------*/
#include "main.h"

/* USER CODE BEGIN Includes */
#include "analog/multiplexer.h"
#include "analog/lut.h"
#include "analog/analog.h"
#include "analog/filter.h"
#include "analog/calibration.h"
#include "analog/internal_sensor_sampler.h"
#include "analog/scan_watchdog.h"
#include "diagnostics.h"
#include "realtime_scan_policy.h"

#include "settings.h"
#include "profile_document_store.h"
#include "flash_storage.h"

#include "stm32f7xx_hal_gpio.h"
#include "trigger/trigger.h"
#include "trigger/socd.h"

#include "adc_capture.h"
#include "action_engine.h"
// #include "adc_ema.h"
#include "led_indicator.h"
#include "led_matrix.h"
#include "hid/raw_hid.h"
#include "stm32f7xx_hal_adc.h"
// #include "trigger.h"
#include "tusb.h"
#include "updater_app.h"
#include "hid/gamepad_hid.h"
#include "hid/xinput_usb.h"
#include "usb_descriptors.h"
#include "hid/consumer_hid.h"
#include "hid/keyboard_hid.h"
#include "hid/keyboard_nkro_hid.h"
#include "hid/mouse_hid.h"
#include "rotary_encoder.h"
#include "stm32f7xx_ll_adc.h"
#include "ws2812.h" // Include WS2812 header
#include <stdbool.h>
#include <stdint.h>
#include <stdio.h>
#include <sys/cdefs.h>

/* USER CODE END Includes */

/* USER CODE BEGIN PD */
#define KBHE_TIMING_PROFILE_DECIMATION 32u
#define MCU_LED_THERMAL_LIMIT_C 70
#define MCU_LED_THERMAL_HYSTERESIS_C 3
#define MCU_LED_THERMAL_BRIGHTNESS_MAX 96u
/* A write becomes eligible only after input and macro traffic have drained.
 * The STM32F723 has one Flash bank, so even one word can stall instruction
 * fetch. Keeping the write out of this guard window is more important than
 * completing persistence while a key remains held. */
#define KBHE_PERSISTENCE_INPUT_QUIET_MS 4u

/* USER CODE END PD */

ADC_HandleTypeDef hadc1;
DMA_HandleTypeDef hdma_adc1;

TIM_HandleTypeDef htim2;
TIM_HandleTypeDef htim4;
DMA_HandleTypeDef hdma_tim2_ch1;

PCD_HandleTypeDef hpcd_USB_OTG_HS;

/* USER CODE BEGIN PV */
// /**
//  * ADC DMA NUMBER OF CONVERSIONS COMPLETED
//  */
// uint32_t num_conv = 0;

/**
 * LED DMA BUFFER
 */
uint32_t ws2812_dma_buffer[BUFFER_SIZE * 2] __attribute__((aligned(256)));

/**
 * EMA FILTERING - Default values (can be overridden via settings)
 */
// #define ADC_EMA_NOISE_BAND_DEFAULT 30u
// #define ADC_EMA_ALPHA_MIN_DENOM_DEFAULT 32u
// #define ADC_EMA_ALPHA_MAX_DENOM_DEFAULT 4u

// // Runtime filter parameters
// static uint8_t filter_enabled = 1;
// static uint8_t filter_noise_band = ADC_EMA_NOISE_BAND_DEFAULT;
// static uint8_t filter_alpha_min_denom = ADC_EMA_ALPHA_MIN_DENOM_DEFAULT;
// static uint8_t filter_alpha_max_denom = ADC_EMA_ALPHA_MAX_DENOM_DEFAULT;

// /**
//  * MUX CONFIGURATION
//  */
// /**
//  * NUMBER OF CHANNELS PER MUX AND NUMBER OF MULTIPLEXERS
//  */
// #define NUM_MUX_CHANNELS 13
// #define NUM_MUX 8

// /**
//  * CURRENT MUX CHANNEL
//  */
// uint16_t mux_channel = 0;

/**
 * ADC DMA BUFFER
 */
// Déclarer un buffer de 128 valeurs de type uint16_t (2 octets chacune) soit
// 256 octets
// #define ADC_BUFFER_LENGTH 128
// uint16_t adc_buffer[ADC_BUFFER_LENGTH]
//     __attribute__((aligned(ADC_BUFFER_LENGTH * 2)));

// /**
//  * ADC VALUES FOR ALL MUX CHANNELS
//  * Format: [MUX0_CH0, MUX0_CH1, ..., MUX0_CH5, MUX1_CH0, ..., MUX1_CH5]
//  */
// uint16_t adc_values[NUM_MUX * NUM_MUX_CHANNELS];

/**
 * EMA state per logical channel (mux input i, mux_channel).
 */
// static adc_ema_t adc_ema_states[NUM_MUX * NUM_MUX_CHANNELS];

// /**
//  * OVERSAMPLING
//  */

// #define SAMPLE_COUNT 1

// uint16_t adc_samples_index = 0;
// uint16_t adc_samples[NUM_MUX * SAMPLE_COUNT];

/**
 * Timings measurement variables
 */
// Temps entre deux scans complets (incluant loop principale)
uint32_t adc_full_cycle_us = 0;
uint32_t adc_full_cycle_start_cycles = 0;

// Time spent in each processing task after a full ADC scan.
uint32_t task_analog_us = 0;
uint32_t task_trigger_us = 0;
uint32_t task_socd_us = 0;
uint32_t task_keyboard_us = 0;
uint32_t task_keyboard_nkro_us = 0;
uint32_t task_gamepad_us = 0;
uint32_t task_led_us = 0;
uint32_t task_total_us = 0;
uint32_t mcu_scan_cycle_us_live = 0;
uint32_t mcu_scan_cycle_us_max = 0;
uint32_t mcu_scan_deadline_miss_count = 0;
uint32_t mcu_adc_recovery_count = 0;
#define MCU_SCAN_HISTOGRAM_BIN_US 4u
#define MCU_SCAN_HISTOGRAM_BIN_COUNT 256u
static uint64_t mcu_scan_cycle_histogram[MCU_SCAN_HISTOGRAM_BIN_COUNT];
static uint64_t mcu_scan_cycle_sample_count = 0u;
uint32_t mcu_work_us_live = 0;
uint16_t mcu_load_permille_live = 0;
int16_t mcu_temperature_c_live = 0;
uint16_t mcu_vref_mv_live = 0;
uint8_t mcu_temperature_valid_live = 0;
static uint8_t timing_profile_counter = 0u;
static uint32_t mcu_metrics_next_sample_ms = 0u;
static adc_internal_sensor_sampler_t mcu_internal_sensor_sampler;
static bool mcu_led_thermal_limit_active = false;
static uint8_t mcu_led_last_applied_brightness = 0xFFu;

//--------------------------------------------------------------------+
// Filter Management Functions
//--------------------------------------------------------------------+

// /**
//  * @brief Reinitialize all EMA filters with current parameters
//  */
// static void reinit_ema_filters(void) {
//   uint16_t alpha_min = ADC_EMA_Q15_FROM_RATIO(1u, filter_alpha_min_denom);
//   uint16_t alpha_max = ADC_EMA_Q15_FROM_RATIO(1u, filter_alpha_max_denom);

//   for (uint16_t i = 0; i < (uint16_t)(NUM_MUX * NUM_MUX_CHANNELS); i++) {
//     adc_ema_init(&adc_ema_states[i], filter_noise_band, alpha_min, alpha_max);
//   }
// }

// uint8_t get_filter_enabled(void) { return filter_enabled; }

// void set_filter_enabled(uint8_t enabled) { filter_enabled = enabled ? 1 : 0; }

// void get_filter_params(uint8_t *noise_band, uint8_t *alpha_min_denom,
//                        uint8_t *alpha_max_denom) {
//   if (noise_band)
//     *noise_band = filter_noise_band;
//   if (alpha_min_denom)
//     *alpha_min_denom = filter_alpha_min_denom;
//   if (alpha_max_denom)
//     *alpha_max_denom = filter_alpha_max_denom;
// }

// void set_filter_params(uint8_t noise_band, uint8_t alpha_min_denom,
//                        uint8_t alpha_max_denom) {
//   // Validate and clamp parameters
//   filter_noise_band = noise_band > 0 ? noise_band : 1;
//   filter_alpha_min_denom = alpha_min_denom > 0 ? alpha_min_denom : 1;
//   filter_alpha_max_denom = alpha_max_denom > 0 ? alpha_max_denom : 1;

//   // Reinitialize filters with new parameters
//   reinit_ema_filters();
// }

// uint16_t get_filtered_adc_value(uint8_t key) {
//   if (key >= NUM_KEYS) {
//     return 0u;
//   }
//   return adc_values[key];
// }

/* USER CODE END PV */

void SystemClock_Config(void);
static void MPU_Config(void);
static void MX_GPIO_Init(void);
static void MX_DMA_Init(void);
static void MX_ADC1_Init(void);
static void MX_USB_OTG_HS_PCD_Init(void);
static void MX_TIM4_Init(void);
static void MX_TIM2_Init(void);
/* USER CODE BEGIN 0 */

//============================================================================+
// TINYUSB PLATFORM FUNCTIONS
//============================================================================+

/*
 * Fonction requise par TinyUSB pour obtenir le temps en millisecondes
 *
 * TinyUSB utilise cette fonction pour:
 *   - Gérer les timeouts des transactions USB
 *   - Implémenter les délais nécessaires au protocole USB
 *   - Mesurer les intervalles entre les événements
 *
 * On utilise HAL_GetTick() qui est incrémenté dans SysTick_Handler
 */
uint32_t tusb_time_millis_api(void) { return HAL_GetTick(); }

/*
 * Fonction optionnelle pour délai en millisecondes
 * Utilisée pendant l'initialisation USB et pour certains délais de reset
 */
void tusb_time_delay_ms_api(uint32_t ms) { HAL_Delay(ms); }

#if defined(__GNUC__) || defined(__clang__)
#define KBHE_ALWAYS_INLINE __attribute__((always_inline)) static inline
#else
#define KBHE_ALWAYS_INLINE static inline
#endif

// KBHE_ALWAYS_INLINE void GPIO_WriteMasked_BSRR(GPIO_TypeDef *port,
//                                               uint16_t pins_mask,
//                                               uint16_t pins_set) {
//   const uint32_t set = (uint32_t)(pins_set & pins_mask);
//   const uint32_t reset = (uint32_t)((pins_mask & (uint16_t)~pins_set) << 16);
//   port->BSRR = set | reset;
// }

static void DWT_CycleCounter_Init(void) {
  /* Active le compteur de cycles (Cortex-M7) */
  CoreDebug->DEMCR |= CoreDebug_DEMCR_TRCENA_Msk;
  DWT->CYCCNT = 0;
  DWT->CTRL |= DWT_CTRL_CYCCNTENA_Msk;
}

static uint32_t cycles_to_us(uint32_t cycles) {
  uint32_t cycles_per_us = SystemCoreClock / 1000000U;

  if (cycles_per_us == 0U) {
    return 0U;
  }

  return (cycles + (cycles_per_us / 2U)) / cycles_per_us;
}

static uint32_t smooth_u32(uint32_t previous, uint32_t sample) {
  if (previous == 0u) {
    return sample;
  }
  return (uint32_t)(((uint64_t)previous * 7u + sample + 4u) / 8u);
}

static void mcu_refresh_runtime_metrics(uint32_t scan_cycle_us,
                                        uint32_t work_us) {
  mcu_scan_cycle_us_live = smooth_u32(mcu_scan_cycle_us_live, scan_cycle_us);
  mcu_work_us_live = smooth_u32(mcu_work_us_live, work_us);

  if (mcu_scan_cycle_us_live == 0u) {
    mcu_load_permille_live = 0u;
    return;
  }

  uint32_t permille =
      ((uint32_t)mcu_work_us_live * 1000u + (mcu_scan_cycle_us_live / 2u)) /
      mcu_scan_cycle_us_live;
  if (permille > 1000u) {
    permille = 1000u;
  }
  mcu_load_permille_live = (uint16_t)permille;
}

static void mcu_init_injected_sensors(void) {
  ADC_InjectionConfTypeDef sInjectedConfig = {0};

  sInjectedConfig.InjectedOffset = 0u;
  sInjectedConfig.InjectedNbrOfConversion = 2u;
  sInjectedConfig.InjectedDiscontinuousConvMode = DISABLE;
  sInjectedConfig.AutoInjectedConv = DISABLE;
  sInjectedConfig.ExternalTrigInjecConv = ADC_INJECTED_SOFTWARE_START;
  sInjectedConfig.ExternalTrigInjecConvEdge =
      ADC_EXTERNALTRIGINJECCONVEDGE_NONE;
  sInjectedConfig.InjectedSamplingTime = ADC_SAMPLETIME_480CYCLES;

  sInjectedConfig.InjectedChannel = ADC_CHANNEL_VREFINT;
  sInjectedConfig.InjectedRank = ADC_INJECTED_RANK_1;
  if (HAL_ADCEx_InjectedConfigChannel(&hadc1, &sInjectedConfig) != HAL_OK) {
    mcu_temperature_valid_live = 0u;
    return;
  }

  sInjectedConfig.InjectedChannel = ADC_CHANNEL_TEMPSENSOR;
  sInjectedConfig.InjectedRank = ADC_INJECTED_RANK_2;
  if (HAL_ADCEx_InjectedConfigChannel(&hadc1, &sInjectedConfig) != HAL_OK) {
    mcu_temperature_valid_live = 0u;
  }
}

/* Return true when the shared ADC must be recovered.  The regular key scanner
 * owns ADC1 continuously, so the injected VREF/temperature sequence must not
 * use HAL_ADCEx_InjectedPollForConversion(..., 0): on a normal not-yet-ready
 * result that HAL routine assigns HAL_ADC_STATE_TIMEOUT to the whole handle,
 * erasing HAL_ADC_STATE_REG_BUSY.  A following HAL_ADCEx_InjectedStop() then
 * believes no regular conversion is active and disables ADC1 underneath the
 * DMA scanner. Under a light main-loop load this can happen once per thermal
 * sample and leave all keys on a stale snapshot until the watchdog fires.
 *
 * Inspect JEOC without side effects and start the already-configured injected
 * sequence directly.  ADC1 remains enabled and the regular DMA ownership/state
 * is never changed. */
static bool mcu_sample_internal_sensors(uint32_t now_ms) {
  adc_internal_sensor_values_t values = {0};
  adc_internal_sensor_result_t result =
      adc_internal_sensor_sampler_poll(&mcu_internal_sensor_sampler, &hadc1,
                                       now_ms, &values);

  if (result == ADC_INTERNAL_SENSOR_READY) {
    uint32_t vref_raw = values.vref_raw;
    uint32_t temp_raw = values.temperature_raw;

    if (vref_raw == 0u || temp_raw == 0u) {
      mcu_temperature_valid_live = 0u;
      return false;
    }

    uint32_t vref_mv =
        __LL_ADC_CALC_VREFANALOG_VOLTAGE(vref_raw, LL_ADC_RESOLUTION_12B);
    int32_t temperature_c =
        __LL_ADC_CALC_TEMPERATURE(vref_mv, temp_raw, LL_ADC_RESOLUTION_12B);

    mcu_vref_mv_live = (uint16_t)vref_mv;
    mcu_temperature_c_live = (int16_t)temperature_c;
    mcu_temperature_valid_live = 1u;
    return false;
  }
  if (result == ADC_INTERNAL_SENSOR_RECOVERY_REQUIRED) {
    /* A two-channel, 480-cycle injected sequence completes in under 40 us at
     * the configured ADC clock. A 4 ms timeout therefore indicates a shared
     * peripheral fault; recover the complete regular scanner instead of
     * trying to stop one ADC group independently. */
    mcu_temperature_valid_live = 0u;
    return true;
  }
  if (result == ADC_INTERNAL_SENSOR_PENDING) {
    return false;
  }

  if (!diagnostics_is_perf_active() &&
      !settings_is_led_thermal_protection_enabled()) {
    return false;
  }
  if (now_ms < mcu_metrics_next_sample_ms) {
    return false;
  }
  mcu_metrics_next_sample_ms = now_ms + 1000u;

  if (!adc_internal_sensor_sampler_start(&mcu_internal_sensor_sampler, &hadc1,
                                         now_ms)) {
    mcu_temperature_valid_live = 0u;
    return true;
  }
  return false;
}

uint16_t mcu_scan_cycle_p99_us(void) {
  uint64_t target = 0u;
  uint64_t cumulative = 0u;

  if (mcu_scan_cycle_sample_count == 0u) {
    return 0u;
  }
  target = (mcu_scan_cycle_sample_count * 99u + 99u) / 100u;
  for (uint16_t bin = 0u; bin < MCU_SCAN_HISTOGRAM_BIN_COUNT; bin++) {
    cumulative += mcu_scan_cycle_histogram[bin];
    if (cumulative >= target) {
      /* Report the conservative upper edge of the 4 us bucket. */
      return (uint16_t)(bin * MCU_SCAN_HISTOGRAM_BIN_US +
                        (MCU_SCAN_HISTOGRAM_BIN_US - 1u));
    }
  }
  return (uint16_t)(MCU_SCAN_HISTOGRAM_BIN_COUNT *
                        MCU_SCAN_HISTOGRAM_BIN_US -
                    1u);
}

static void mcu_apply_led_thermal_protection(void) {
  uint8_t target_brightness = settings_get_led_brightness();
  bool protection_enabled = settings_is_led_thermal_protection_enabled();
  int16_t clear_threshold =
      (int16_t)(MCU_LED_THERMAL_LIMIT_C - MCU_LED_THERMAL_HYSTERESIS_C);

  if (!protection_enabled) {
    mcu_led_thermal_limit_active = false;
  } else if (mcu_temperature_valid_live != 0u) {
    if (mcu_led_thermal_limit_active) {
      if (mcu_temperature_c_live <= clear_threshold) {
        mcu_led_thermal_limit_active = false;
      }
    } else if (mcu_temperature_c_live > MCU_LED_THERMAL_LIMIT_C) {
      mcu_led_thermal_limit_active = true;
    }
  }

  if (mcu_led_thermal_limit_active &&
      target_brightness > MCU_LED_THERMAL_BRIGHTNESS_MAX) {
    target_brightness = MCU_LED_THERMAL_BRIGHTNESS_MAX;
  }

  if (target_brightness == mcu_led_last_applied_brightness) {
    return;
  }

  led_matrix_set_brightness(target_brightness);
  mcu_led_last_applied_brightness = target_brightness;
}

static void TIM4_StartOneShot_TRGO(void) {
  TIM4->SR = ~TIM_SR_UIF;
  TIM4->CNT = 0;
  TIM4->CR1 |= TIM_CR1_CEN;
}

static bool should_profile_timing_scan(void) {
  if (!diagnostics_is_perf_active()) {
    adc_full_cycle_us = 0u;
    task_analog_us = 0u;
    task_trigger_us = 0u;
    task_socd_us = 0u;
    task_keyboard_us = 0u;
    task_keyboard_nkro_us = 0u;
    task_gamepad_us = 0u;
    task_led_us = 0u;
    task_total_us = 0u;
    timing_profile_counter = 0u;
    return false;
  }

  bool collect_profile = (timing_profile_counter == 0u);

  timing_profile_counter++;
  if (timing_profile_counter >= KBHE_TIMING_PROFILE_DECIMATION) {
    timing_profile_counter = 0u;
  }

  return collect_profile;
}

// /**
//  * Selects the current channel on the multiplexer.
//  */
// static void MUX_SelectChannel(uint8_t channel) {
//   // uint32_t start_cycles = DWT->CYCCNT;
//   /* M0..M3 = bus d'adresse (0..15). On utilise ici 0..NUM_MUX_CHANNELS-1. */
//   if (channel >= (uint8_t)NUM_MUX_CHANNELS) {
//     channel = 0U;
//   }

//   /* Chemin critique: évite HAL_GPIO_WritePin (très coûteux) */
//   if (M0_GPIO_Port == M1_GPIO_Port) {
//     uint16_t pins_set = 0U;
//     if ((channel & 0x01U) != 0U) {
//       pins_set |= M0_Pin;
//     }
//     if ((channel & 0x02U) != 0U) {
//       pins_set |= M1_Pin;
//     }
//     GPIO_WriteMasked_BSRR(M0_GPIO_Port, (uint16_t)(M0_Pin | M1_Pin), pins_set);
//   } else {
//     GPIO_WriteMasked_BSRR(M0_GPIO_Port, M0_Pin,
//                           ((channel & 0x01U) != 0U) ? M0_Pin : 0U);
//     GPIO_WriteMasked_BSRR(M1_GPIO_Port, M1_Pin,
//                           ((channel & 0x02U) != 0U) ? M1_Pin : 0U);
//   }

//   if (M2_GPIO_Port == M3_GPIO_Port) {
//     uint16_t pins_set = 0U;
//     if ((channel & 0x04U) != 0U) {
//       pins_set |= M2_Pin;
//     }
//     if ((channel & 0x08U) != 0U) {
//       pins_set |= M3_Pin;
//     }
//     GPIO_WriteMasked_BSRR(M2_GPIO_Port, (uint16_t)(M2_Pin | M3_Pin), pins_set);
//   } else {
//     GPIO_WriteMasked_BSRR(M2_GPIO_Port, M2_Pin,
//                           ((channel & 0x04U) != 0U) ? M2_Pin : 0U);
//     GPIO_WriteMasked_BSRR(M3_GPIO_Port, M3_Pin,
//                           ((channel & 0x08U) != 0U) ? M3_Pin : 0U);
//   }

//   mux_channel = channel;

//   // uint32_t end_cycles = DWT->CYCCNT;
//   // gpio_switching_us = cycles_to_us(end_cycles - start_cycles);
// }

//============================================================================+
// WS2812 LED DMA CALLBACKS
//============================================================================+

// External reference to the WS2812 handle from led_matrix.c
extern ws2812_handleTypeDef led_ws2812_handle;

// DMA Half Transfer callback - update first half of buffer
void HAL_TIM_PWM_PulseFinishedHalfCpltCallback(TIM_HandleTypeDef *htim) {
  if (htim->Instance == TIM2) {
    ws2812_update_buffer(&led_ws2812_handle, led_ws2812_handle.dma_buffer);
  }
}

// DMA Transfer Complete callback - update second half of buffer
void HAL_TIM_PWM_PulseFinishedCallback(TIM_HandleTypeDef *htim) {
  if (htim->Instance == TIM2) {
    ws2812_update_buffer(&led_ws2812_handle,
                         &led_ws2812_handle.dma_buffer[BUFFER_SIZE]);
  }
}

/* USER CODE END 0 */

/**
 * @brief  The application entry point.
 * @retval int
 */
int main(void) {

  /* USER CODE BEGIN 1 */
  /**
   * INITIALIZE ADC VALUES ARRAY
   */
  // for (uint16_t i = 0; i < NUM_MUX * NUM_MUX_CHANNELS; i++) {
  //   adc_values[i] = 0;
  // }

  /*
   * INITIALIZE ANALOG MODULE
   */
  AnalogConfig_t analog_config = {
    .hadc = &hadc1
  };
  
  analog_init(&analog_config);

  uint16_t *adc_buffer = analog_get_adc_buffer_ptr();

  /**
   * INITIALIZE FILTER MODULE
   */
  filter_init();

  /*
   * INITIALIZE CALIBRATION MODULE
   */
  calibration_init();

  // // Initialize EMA state for each logical ADC channel using runtime parameters
  // reinit_ema_filters();
  /* USER CODE END 1 */

  /* MPU Configuration--------------------------------------------------------*/
  MPU_Config();

  /* Enable the CPU Cache */

  /* Enable I-Cache---------------------------------------------------------*/
  SCB_EnableICache();

  /* Enable D-Cache---------------------------------------------------------*/
  SCB_EnableDCache();

  /* MCU Configuration--------------------------------------------------------*/

  /* Reset of all peripherals, Initializes the Flash interface and the Systick.
   */
  HAL_Init();

  /* Configure the system clock */
  SystemClock_Config();

  /* Initialize all configured peripherals */
  MX_GPIO_Init();
  MX_DMA_Init();
  MX_ADC1_Init();
  MX_USB_OTG_HS_PCD_Init();
  MX_TIM4_Init();
  MX_TIM2_Init();
  /* USER CODE BEGIN 2 */

  /*
   * INITIALIZE MULTIPLEXER MODULE
   */
  multiplexer_init();

  /*
   * INITIALIZE TRIGGER MODULE
   */
  trigger_init();

  /*
   * INITIALIZE SOCD MODULE
   */
  socd_init();

  // Affectation du buffer DMA non-cacheable au handle WS2812
  led_ws2812_handle.dma_buffer = ws2812_dma_buffer;

  // Initialize WS2812 LED Matrix (8x8 = 64 LEDs)
  if (!led_matrix_init(&htim2, TIM_CHANNEL_1)) {
    // LED init failed, but continue anyway
  }

  // Initialize keyboard lock-state tracking (used to override the Caps Lock
  // key LED inside the RGB matrix).
  led_indicator_init();

  /*
   * Load/apply persisted settings after HAL, Flash and the LED driver are
   * fully initialized, but before USB enumeration. This lets the USB
   * descriptors reflect the saved gamepad API mode on the next enumeration.
   */
  settings_init();
  /* Action profiles share the flash journal and drive LED overlays, so both
   * settings/flash and the LED matrix must be ready before loading them. */
  action_engine_init();
  (void)action_engine_activate_profile(settings_get_active_profile_index());

  // Initialisation TinyUSB - RHPORT 1 = USB HS avec PHY intégré
  const tusb_rhport_init_t rhport_init = {.role = TUSB_ROLE_DEVICE,
                                          .speed = TUSB_SPEED_HIGH};
  tusb_init(USB_RHPORT_HS, &rhport_init);

  raw_hid_init();
  consumer_hid_init();
  mouse_hid_init();
  gamepad_hid_init();
  gamepad_hid_set_enabled(settings_is_gamepad_enabled());
  gamepad_hid_reload_settings();
  xinput_usb_init();
  diagnostics_init();
  mcu_init_injected_sensors();
  adc_internal_sensor_sampler_init(&mcu_internal_sensor_sampler);

  // triggerInit();

  rotary_encoder_init();

  DWT_CycleCounter_Init();

  multiplexer_select_mux_channel(0U);

  adc_full_cycle_start_cycles = DWT->CYCCNT;
  if (HAL_ADC_Start_DMA(&hadc1, (uint32_t *)adc_buffer, NUM_MUX) != HAL_OK) {
    Error_Handler();
  }
  /* HAL enables the DMA half-transfer IRQ even though this scanner consumes
   * only complete mux rows.  Disable it before arming TIM4: otherwise every
   * row produces an empty ISR in addition to the completion ISR (64 kHz at an
   * 8 kHz full-board scan rate). */
  __HAL_DMA_DISABLE_IT(hadc1.DMA_Handle, DMA_IT_HT);
  TIM4_StartOneShot_TRGO();
  uint32_t adc_last_progress_ms = HAL_GetTick();
  bool adc_recovery_pending = false;
  bool persistence_step_pending = false;

  /* USER CODE END 2 */

  /* Infinite loop */
  /* USER CODE BEGIN WHILE */
  while (1) {
    bool processed_scan = false;
    bool profile_timing = false;
    bool usb_serviced = false;
    uint32_t task_start_cycles = 0;
    uint32_t live_task_start_cycles = 0;
    uint32_t live_scan_cycle_us = 0;

    uint32_t adc_now_ms = HAL_GetTick();
    bool adc_scan_complete = analog_is_scan_complete();
    if (adc_scan_watchdog_should_recover(analog_take_scan_fault(),
                                         adc_scan_complete, adc_now_ms,
                                         adc_last_progress_ms)) {
      adc_recovery_pending = true;
    }
    if (adc_recovery_pending) {
      TIM4->CR1 &= ~TIM_CR1_CEN;
      (void)HAL_ADC_Stop_DMA(&hadc1);
      adc_internal_sensor_sampler_abort(&mcu_internal_sensor_sampler, &hadc1);
      analog_reset_scan_state();
      if (HAL_ADC_Start_DMA(&hadc1, (uint32_t *)adc_buffer, NUM_MUX) == HAL_OK) {
        /* HAL_ADC_Start_DMA() re-enables both transfer callbacks. */
        __HAL_DMA_DISABLE_IT(hadc1.DMA_Handle, DMA_IT_HT);
        if (mcu_adc_recovery_count < UINT32_MAX) {
          mcu_adc_recovery_count++;
        }
        adc_full_cycle_start_cycles = DWT->CYCCNT;
        adc_last_progress_ms = adc_now_ms;
        adc_recovery_pending = false;
        TIM4_StartOneShot_TRGO();
      }
    }

    // If a full ADC scan is complete, process keys and restart
    if (kbhe_realtime_first_service(analog_is_scan_complete()) ==
        KBHE_REALTIME_SERVICE_ADC) {
      uint32_t now = DWT->CYCCNT;
      live_scan_cycle_us = cycles_to_us(now - adc_full_cycle_start_cycles);
      {
        uint32_t histogram_bin =
            live_scan_cycle_us / MCU_SCAN_HISTOGRAM_BIN_US;
        if (histogram_bin >= MCU_SCAN_HISTOGRAM_BIN_COUNT) {
          histogram_bin = MCU_SCAN_HISTOGRAM_BIN_COUNT - 1u;
        }
        mcu_scan_cycle_histogram[histogram_bin]++;
        mcu_scan_cycle_sample_count++;
      }
      if (live_scan_cycle_us > mcu_scan_cycle_us_max) {
        mcu_scan_cycle_us_max = live_scan_cycle_us;
      }
      if (live_scan_cycle_us >= KBHE_SCAN_DEADLINE_US) {
        mcu_scan_deadline_miss_count++;
      }
      profile_timing = should_profile_timing_scan();
      live_task_start_cycles = now;
      if (profile_timing) {
        adc_full_cycle_us = live_scan_cycle_us;
        task_start_cycles = now;
      }
      adc_full_cycle_start_cycles = now;
      processed_scan = true;

      if (profile_timing) {
        uint32_t step_start_cycles = DWT->CYCCNT;
        analog_task();
        task_analog_us = cycles_to_us(DWT->CYCCNT - step_start_cycles);
      } else {
        analog_task();
      }

      /* `analog_task()` consumes the just-published DMA buffer. Once guided
       * calibration has observed the same immutable scan, release the scan
       * flag and start the next acquisition before the CPU-only trigger/HID
       * work. The new ~53 us acquisition can then overlap that work. Nothing
       * below this point may clear scan_complete: the DMA ISR may publish the
       * next scan while those tasks are still running. */
      calibration_guided_on_scan(HAL_GetTick());
      analog_set_scan_complete(false);
      TIM4_StartOneShot_TRGO();
      adc_last_progress_ms = HAL_GetTick();

      if (profile_timing) {
        uint32_t step_start_cycles = DWT->CYCCNT;
        trigger_task();
        task_trigger_us = cycles_to_us(DWT->CYCCNT - step_start_cycles);

        step_start_cycles = DWT->CYCCNT;
        socd_task();
        task_socd_us = cycles_to_us(DWT->CYCCNT - step_start_cycles);

        action_engine_tick(HAL_GetTick());
      } else {
        trigger_task();
        socd_task();
        action_engine_tick(HAL_GetTick());
      }

      /* The immutable ADC snapshot has been consumed, the next DMA scan is
       * already armed, and its actions are resolved. Drain endpoint completion
       * events now so the HID tasks below can submit their next report in this
       * same 125 us window instead of falling to an effective 4 kHz cadence. */
      tud_task();
      usb_serviced = true;

      if (profile_timing) {
        uint32_t step_start_cycles = DWT->CYCCNT;
        keyboard_hid_task();
        task_keyboard_us = cycles_to_us(DWT->CYCCNT - step_start_cycles);

        step_start_cycles = DWT->CYCCNT;
        keyboard_nkro_hid_task();
        task_keyboard_nkro_us = cycles_to_us(DWT->CYCCNT - step_start_cycles);

        step_start_cycles = DWT->CYCCNT;
        gamepad_hid_refresh_state();
        gamepad_hid_task();
        xinput_usb_task();
        task_gamepad_us = cycles_to_us(DWT->CYCCNT - step_start_cycles);
      } else {
        keyboard_hid_task();
        keyboard_nkro_hid_task();
        gamepad_hid_refresh_state();
        gamepad_hid_task();
        xinput_usb_task();
      }

      /* Grant one CRC/program budget unit per completed scan, but spend it
       * in the best-effort section below.  A single Flash word program can
       * stall the core for FLASH_STORAGE_WORD_PROGRAM_DATASHEET_MAX_US
       * (100 us), i.e. most of a 125 us scan period, and on this single-bank
       * STM32F723 that stall also blocks instruction fetch for the ISRs.
       * Running it here pushed every later service past the next completed
       * scan for the whole duration of a save. */
      if (!persistence_step_pending) {
        persistence_step_pending = true;
      }
    }

    /* When no ADC snapshot was ready, USB is still serviced once this loop.
     * tud_task() drains until empty and exposes no event-count budget; it cannot
     * be preempted without patching TinyUSB. The explicit 16-event queue limits
     * queued backlog, and the post-call ADC check suppresses every lower-
     * priority service if a scan arrived meanwhile. Existing 125 us deadline
     * telemetry characterizes the residual latency. */
    if (!usb_serviced) {
      tud_task();
    }
    bool best_effort_allowed =
        kbhe_realtime_after_usb(analog_is_scan_complete()) ==
        KBHE_REALTIME_SERVICE_BEST_EFFORT;

    /* Input has strict priority over the remaining best-effort control
     * work. Check the DMA completion flag between bounded services so a
     * host command burst can never build an unbounded queue in front of a
     * completed scan.  tud_task() is deliberately absent here: it is
     * serviced unconditionally above. */
    if (best_effort_allowed && !analog_is_scan_complete()) {
      raw_hid_task();
    }
    /* Consumer pulses are queued transactionally; mouse relative pulses are
     * queued while its button bitmap is resynchronised as state. Both tasks
     * are bounded and no-op when nothing changed. */
    if (best_effort_allowed && !analog_is_scan_complete()) {
      consumer_hid_task();
      mouse_hid_task();
    }
    if (best_effort_allowed && !analog_is_scan_complete()) {
      updater_app_task();
    }

    /* Apply settings immediately in RAM, but advance their durable journal
     * only after physical input, macros, and keyboard transports are quiet.
     * There is deliberately no timeout that can force a Flash stall back into
     * an active key path; a continuously held key simply defers persistence. */
    if (best_effort_allowed && persistence_step_pending &&
        !analog_is_scan_complete() &&
        trigger_is_input_idle(HAL_GetTick(),
                              KBHE_PERSISTENCE_INPUT_QUIET_MS) &&
        action_engine_is_idle() && keyboard_hid_is_transport_idle() &&
        keyboard_nkro_hid_is_transport_idle()) {
      flash_storage_metrics_t persistence_before = {0};
      flash_storage_metrics_t persistence_after_profile = {0};

      persistence_step_pending = false;
      flash_storage_get_metrics(&persistence_before);
      profile_document_store_async_task(32u, 1u);
      action_store_async_task();
      flash_storage_get_metrics(&persistence_after_profile);
      settings_task_budgeted(HAL_GetTick(),
                             persistence_after_profile.async_steps ==
                                     persistence_before.async_steps
                                 ? 1u
                                 : 0u);
    }

    // LED/UI timing should not depend on ADC scan state. The scan completes so
    // quickly on the 82-key board that gating animation updates behind the
    // "no scan complete" branch effectively starves LED effects.
    uint32_t now_ms = HAL_GetTick();
    if (best_effort_allowed && !analog_is_scan_complete()) {
      if (mcu_sample_internal_sensors(now_ms)) {
        adc_recovery_pending = true;
      }
    }
    uint32_t led_start_cycles = 0u;
    if (profile_timing) {
      led_start_cycles = DWT->CYCCNT;
    }
    if (best_effort_allowed && !analog_is_scan_complete()) {
      calibration_guided_tick(now_ms);
    }
    /* Polled quadrature decoder: a skipped poll can turn a valid Gray-code
     * edge into a two-bit jump, which discards the accumulated detent. It
     * early-exits when neither the A/B lines nor the button changed. */
    if (best_effort_allowed && !analog_is_scan_complete()) {
      rotary_encoder_task(now_ms);
    }
    if (best_effort_allowed && !analog_is_scan_complete()) {
      led_matrix_effect_tick(now_ms);
    }
    if (best_effort_allowed && !analog_is_scan_complete()) {
      led_indicator_tick(now_ms);
    }
    if (best_effort_allowed && !analog_is_scan_complete()) {
      mcu_apply_led_thermal_protection();
    }
    if (profile_timing) {
      task_led_us = cycles_to_us(DWT->CYCCNT - led_start_cycles);
    }

    if (processed_scan && profile_timing) {
      task_total_us = cycles_to_us(DWT->CYCCNT - task_start_cycles);
    }
    if (processed_scan && diagnostics_is_perf_active()) {
      uint32_t live_work_us = cycles_to_us(DWT->CYCCNT - live_task_start_cycles);
      mcu_refresh_runtime_metrics(live_scan_cycle_us, live_work_us);
    }
    /* USER CODE END WHILE */

    /* USER CODE BEGIN 3 */
  }
  /* USER CODE END 3 */
}

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
/* USER CODE BEGIN 4 */
// void HAL_ADC_ConvCpltCallback(ADC_HandleTypeDef *hadc) {
//   /**
//    * When an ADC burst is complete, store the values and switch to the next MUX
//    * channel
//    */
//   if (hadc->Instance == ADC1) {
//     adc_callback_start_cycles = DWT->CYCCNT;

//     // Increment number of conversions completed
//     num_conv++;

//     // Store ADC values for all MUX
//     for (uint8_t i = 0; i < NUM_MUX; i++) {
//       /**
//        * MUX0_CH0, MUX0_CH1, ..., MUX0_CH13, MUX1_CH0, ..., MUX7_CH13
//        */
//       uint16_t new_adc_value = adc_buffer[i];

//       uint16_t logical_index = (uint16_t)(mux_channel + (i * NUM_MUX_CHANNELS));

//       // Store raw value
//       adc_values_raw[logical_index] = new_adc_value;
//     }

//     // Increment MUX channel
//     mux_channel++;

//     // If all channels have been read, reset to channel 0
//     if (mux_channel >= NUM_MUX_CHANNELS) {
//       mux_channel = 0U;

//       // Signal that a full scan is complete - let main loop restart
//       adc_scan_complete = 1;
//       return; // Don't restart timer here, let main loop do it
//     }

//     // Select next MUX channel
//     MUX_SelectChannel(mux_channel);

//     // Start 0.5us timer to wait for MUX settling time then trigger ADC
//     // Only restart immediately - the main loop will have time between full
//     // scans because the DMA priority is lower than USB
//     TIM4_StartOneShot_TRGO();

//     adc_callback_end_cycles = DWT->CYCCNT;
//     adc_callback_us =
//         cycles_to_us(adc_callback_end_cycles - adc_callback_start_cycles);
//   }
// }

/* USER CODE END 4 */

/* MPU Configuration */

void MPU_Config(void) {
  MPU_Region_InitTypeDef MPU_InitStruct = {0};

  /* Disables the MPU */
  HAL_MPU_Disable();

  /** Initializes and configures the Region and the memory to be protected
   */
  MPU_InitStruct.Enable = MPU_REGION_ENABLE;
  MPU_InitStruct.Number = MPU_REGION_NUMBER0;
  MPU_InitStruct.BaseAddress = (uint32_t)(uintptr_t)analog_get_adc_buffer_ptr();
  MPU_InitStruct.Size = MPU_REGION_SIZE_256B;
  MPU_InitStruct.SubRegionDisable = 0x00;
  MPU_InitStruct.TypeExtField = MPU_TEX_LEVEL0;
  MPU_InitStruct.AccessPermission = MPU_REGION_FULL_ACCESS;
  MPU_InitStruct.DisableExec = MPU_INSTRUCTION_ACCESS_ENABLE;
  MPU_InitStruct.IsShareable = MPU_ACCESS_SHAREABLE;
  MPU_InitStruct.IsCacheable = MPU_ACCESS_NOT_CACHEABLE;
  MPU_InitStruct.IsBufferable = MPU_ACCESS_NOT_BUFFERABLE;

  HAL_MPU_ConfigRegion(&MPU_InitStruct);

  /** Initializes and configures the Region and the memory to be protected
   */
  MPU_InitStruct.Number = MPU_REGION_NUMBER1;
  MPU_InitStruct.BaseAddress = (uint32_t)&ws2812_dma_buffer;
  MPU_InitStruct.Size = MPU_REGION_SIZE_256B;
  MPU_InitStruct.SubRegionDisable = 0x0;
  MPU_InitStruct.TypeExtField = MPU_TEX_LEVEL0;
  MPU_InitStruct.AccessPermission = MPU_REGION_FULL_ACCESS;
  MPU_InitStruct.DisableExec = MPU_INSTRUCTION_ACCESS_ENABLE;
  MPU_InitStruct.IsShareable = MPU_ACCESS_SHAREABLE;
  MPU_InitStruct.IsCacheable = MPU_ACCESS_NOT_CACHEABLE;
  MPU_InitStruct.IsBufferable = MPU_ACCESS_NOT_BUFFERABLE;

  HAL_MPU_ConfigRegion(&MPU_InitStruct);
  /* Enables the MPU */
  HAL_MPU_Enable(MPU_PRIVILEGED_DEFAULT);
}

/**
 * @brief  This function is executed in case of error occurrence.
 * @retval None
 */
void Error_Handler(void) {
  /* USER CODE BEGIN Error_Handler_Debug */
  /* User can add his own implementation to report the HAL error return state */
  __disable_irq();
  while (1) {
  }
  /* USER CODE END Error_Handler_Debug */
}
#ifdef USE_FULL_ASSERT
/**
 * @brief  Reports the name of the source file and the source line number
 *         where the assert_param error has occurred.
 * @param  file: pointer to the source file name
 * @param  line: assert_param error line source number
 * @retval None
 */
void assert_failed(uint8_t *file, uint32_t line) {
  /* USER CODE BEGIN 6 */
  /* User can add his own implementation to report the file name and line
     number, ex: printf("Wrong parameters value: file %s on line %d\r\n", file,
     line) */
  /* USER CODE END 6 */
}
#endif /* USE_FULL_ASSERT */
