Fefe-Nayz/kbhe-monorepo/firmware/Core/Inc/main.h

#define KBHE_NVIC_PRIORITY_INPUT 0U
#define KBHE_NVIC_PRIORITY_LED_DMA 1U
#define KBHE_NVIC_PRIORITY_USB 2U
#define LED_DATA_Pin GPIO_PIN_15
#define LED_DATA_GPIO_Port GPIOA
#define ENCODER_SW_Pin GPIO_PIN_3
#define ENCODER_SW_GPIO_Port GPIOB
#define ENCODER_WAVE_1_Pin GPIO_PIN_5
#define ENCODER_WAVE_1_GPIO_Port GPIOB
#define ENCODER_WAVE_2_Pin GPIO_PIN_4
#define ENCODER_WAVE_2_GPIO_Port GPIOB
#define M2_Pin GPIO_PIN_6
#define M2_GPIO_Port GPIOD
#define M1_Pin GPIO_PIN_5
#define M1_GPIO_Port GPIOD
#define M0_Pin GPIO_PIN_4
#define M0_GPIO_Port GPIOD
