Fefe-Nayz/kbhe-monorepo/firmware/Core/Src/analog/analog.c

#include "analog/analog.h"
#include "analog/multiplexer.h"
#include "analog/filter.h"
#include "analog/lut.h"
#include "analog/calibration.h"
#include "analog/diagnostic_profile_policy.h"
#include "analog/rest_estimator.h"
#include "adc_capture.h"
#include "diagnostics.h"
#include "settings.h"
#include <stdbool.h>
#include <stdint.h>
#include <string.h>

static AnalogConfig_t analog_config;

static uint16_t adc_buffer[ADC_BUFFER_LENGTH] __attribute__((aligned(ADC_BUFFER_LENGTH * 2)));

static uint16_t raw_values[NUM_ANALOG_INPUTS];

/* Immutable logical-key view of the last complete scan.  Diagnostic and
 * calibration readers must not observe rows from two different DMA scans. */
static uint16_t logical_raw_values[NUM_KEYS];

static uint16_t filtered_values[NUM_KEYS];

static uint16_t calibrated_values[NUM_KEYS];

static uint16_t distance_values[NUM_KEYS];

static uint8_t normalized_values[NUM_KEYS];

static volatile uint8_t current_mux_channel = 0;

static volatile bool is_scan_complete = false;
static volatile bool scan_fault_pending = false;

/* Upper bound for the extrapolated logical travel. Four times the
 * configurable travel leaves headroom no physical switch can reach while
 * keeping the value inside int16_t. */
#define ANALOG_TRAVEL_EXTRAPOLATION_MAX_UM (4u * SETTINGS_LOGICAL_TRAVEL_UM)

static analog_task_monitor_t analog_task_monitor;
static analog_rest_estimator_t analog_rest_estimator;
static analog_diagnostic_profile_sweep_t analog_profile_sweep;

static inline bool analog_is_valid_physical_index(uint8_t index) {
    return index < NUM_ANALOG_INPUTS;
}

static inline uint32_t analog_cycles_to_us(uint32_t cycles) {
    uint32_t cycles_per_us = SystemCoreClock / 1000000U;

    if (cycles_per_us == 0U) {
        return 0U;
    }

    return (cycles + (cycles_per_us / 2U)) / cycles_per_us;
}

/*
 * Mapping from logical key index (0-81) to physical key index (0-87)
 * For example logical key index 0 corresponds to physical key index 43
 */
static const uint8_t LOGICAL_KEY_INDEX_TO_PHYSICAL_INDEX[NUM_KEYS] = {
    41, 8, 19, 30, 33, 0, 11, 22,
    34, 1, 12, 23, 35, 24, 63, 85,
    74, 52, 55, 77, 66, 44, 56, 78,
    67, 57, 79, 68, 46, 40, 7, 18,
    29, 42, 9, 20, 31, 37, 4, 15,
    26, 36, 47, 25, 62, 84, 73, 51,
    64, 86, 75, 53, 59, 81, 70, 48,
    58, 69, 43, 10, 21, 32, 54, 39,
    6, 17, 28, 50, 71, 82, 60, 38,
    65, 87, 76, 61, 83, 72, 49, 27,
    16, 5
};

// static const uint8_t LOGICAL_KEY_INDEX_TO_PHYSICAL_INDEX[NUM_KEYS] = {
// 0, 8, 16, 24, 32, 40, 0, 0, 0, 0, 0, 0,
// 0, 0, 0, 0, 0, 0, 0, 0, 0, 0,
// 0, 0, 0, 0, 0, 0, 0, 0, 0, 0,
// 0, 0, 0, 0, 0, 0, 0, 0,0, 0, 0, 0, 0, 0, 0,
// 0, 0, 0, 0, 0, 0, 0, 0, 0, 0, 0, 0, 0, 0, 0,
// 0, 0, 0, 0, 0, 0, 0, 0, 0, 0, 0, 0, 0, 0, 0, 0,
// 0, 0, 0, 0
// };

// static const uint8_t LOGICAL_KEY_INDEX_TO_PHYSICAL_INDEX[NUM_KEYS] = {
//     0, 8, 16, 24, 32, 40
// };

void analog_init(AnalogConfig_t* config) {
    // Copy the configuration to the static variable
    analog_config = *config;
    current_mux_channel = 0u;
    is_scan_complete = false;
    scan_fault_pending = false;
    // Initialize adc buffer to 0
    for (uint8_t i = 0; i < NUM_MUX; i++) {
        adc_buffer[i] = 0;
    }

    // Initialize raw values to 0
    for (uint8_t i = 0; i < NUM_ANALOG_INPUTS; i++) {
        raw_values[i] = 0;
    }

    // Initialize filtered values to 0
    for (uint8_t i = 0; i < NUM_KEYS; i++) {
        logical_raw_values[i] = 0;
        filtered_values[i] = 0;
        calibrated_values[i] = 0;
        distance_values[i] = 0;
        normalized_values[i] = 0;
    }

    analog_rest_estimator_init(&analog_rest_estimator);
    analog_diagnostic_profile_reset(&analog_profile_sweep);

    analog_task_monitor.raw_us = 0;
    analog_task_monitor.filter_us = 0;
    analog_task_monitor.calibration_us = 0;
    analog_task_monitor.lut_us = 0;
    analog_task_monitor.store_us = 0;
    analog_task_monitor.key_min_us = 0;
    analog_task_monitor.key_max_us = 0;
    analog_task_monitor.key_avg_us = 0;
    analog_task_monitor.nonzero_keys = 0;
    analog_task_monitor.key_max_index = 0;
}

void analog_task() {
    const uint8_t* key_to_phys = LOGICAL_KEY_INDEX_TO_PHYSICAL_INDEX;
    bool diagnostics_active = diagnostics_is_perf_active();
    uint8_t profile_key = 0u;
    uint32_t raw_cycles = 0;
    uint32_t filter_cycles = 0;
    uint32_t calibration_cycles = 0;
    uint32_t lut_cycles = 0;
    uint32_t store_cycles = 0;
    uint32_t profiled_key_cycles = 0u;
    uint16_t nonzero_keys = 0;

    if (diagnostics_active) {
        profile_key = analog_diagnostic_profile_take_key(&analog_profile_sweep,
                                                         NUM_KEYS);
    } else {
        analog_diagnostic_profile_reset(&analog_profile_sweep);
        memset(&analog_task_monitor, 0, sizeof(analog_task_monitor));
    }

    for (uint8_t key = 0; key < NUM_KEYS; key++) {
        uint32_t key_start_cycles = 0u;
        bool measure_key = diagnostics_active && key == profile_key;
        uint8_t physical_key_index = key_to_phys[key];
        uint16_t raw_value = 0u;
        uint16_t filtered_value = 0u;
        uint16_t calibrated_value = 0u;
        uint16_t distance_value = 0u;

        if (measure_key) {
            uint32_t step_start_cycles = DWT->CYCCNT;
            key_start_cycles = step_start_cycles;
            raw_value = analog_is_valid_physical_index(physical_key_index)
                            ? raw_values[physical_key_index]
                            : 0u;
            raw_cycles += (DWT->CYCCNT - step_start_cycles);
        } else {
            raw_value = analog_is_valid_physical_index(physical_key_index)
                            ? raw_values[physical_key_index]
                            : 0u;
        }

        if (raw_value != 0) {
            nonzero_keys++;
        }

        logical_raw_values[key] = raw_value;

        if (measure_key) {
            uint32_t step_start_cycles = DWT->CYCCNT;
            filtered_value = filter_compute_next_filtered_value(key, raw_value);
            filter_cycles += (DWT->CYCCNT - step_start_cycles);

            step_start_cycles = DWT->CYCCNT;
            calibrated_value = calibration_get_calibrated_value(key, filtered_value);
            calibration_cycles += (DWT->CYCCNT - step_start_cycles);

            step_start_cycles = DWT->CYCCNT;
            distance_value = getDistanceFromVoltage(calibrated_value);
            lut_cycles += (DWT->CYCCNT - step_start_cycles);

            step_start_cycles = DWT->CYCCNT;
            filtered_values[key] = filtered_value;
            calibrated_values[key] = calibrated_value;
            distance_values[key] = distance_value;
            normalized_values[key] =
                calibration_get_normalized_distance(key, (int16_t)distance_value);
            store_cycles += (DWT->CYCCNT - step_start_cycles);
        } else {
            filtered_value = filter_compute_next_filtered_value(key, raw_value);
            calibrated_value = calibration_get_calibrated_value(key, filtered_value);
            distance_value = getDistanceFromVoltage(calibrated_value);
            filtered_values[key] = filtered_value;
            calibrated_values[key] = calibrated_value;
            distance_values[key] = distance_value;
            normalized_values[key] =
                calibration_get_normalized_distance(key, (int16_t)distance_value);
        }

        if (!measure_key) {
            continue;
        }

        profiled_key_cycles = DWT->CYCCNT - key_start_cycles;
    }

    analog_task_monitor.nonzero_keys = nonzero_keys;

    if (diagnostics_active) {
        analog_diagnostic_profile_sample_t sample = {
            .raw_cycles = raw_cycles,
            .filter_cycles = filter_cycles,
            .calibration_cycles = calibration_cycles,
            .lut_cycles = lut_cycles,
            .store_cycles = store_cycles,
            .key_cycles = profiled_key_cycles,
            .key_index = profile_key,
        };
        analog_diagnostic_profile_snapshot_t profile = {0};

        /* The cursor wraps after all logical keys have contributed exactly one
         * sample. Publish the complete sweep atomically from the main loop;
         * diagnostics retain the previous complete sweep while it refreshes. */
        if (analog_diagnostic_profile_record(&analog_profile_sweep, NUM_KEYS,
                                             &sample, &profile)) {
            analog_task_monitor.raw_us =
                (uint16_t)analog_cycles_to_us(profile.raw_cycles);
            analog_task_monitor.filter_us =
                (uint16_t)analog_cycles_to_us(profile.filter_cycles);
            analog_task_monitor.calibration_us =
                (uint16_t)analog_cycles_to_us(profile.calibration_cycles);
            analog_task_monitor.lut_us =
                (uint16_t)analog_cycles_to_us(profile.lut_cycles);
            analog_task_monitor.store_us =
                (uint16_t)analog_cycles_to_us(profile.store_cycles);
            analog_task_monitor.key_min_us =
                (uint16_t)analog_cycles_to_us(
                    profile.key_min_cycles == UINT32_MAX
                        ? 0u
                        : profile.key_min_cycles);
            analog_task_monitor.key_max_us =
                (uint16_t)analog_cycles_to_us(profile.key_max_cycles);
            analog_task_monitor.key_avg_us =
                (uint16_t)analog_cycles_to_us(
                    profile.key_sum_cycles / NUM_KEYS);
            analog_task_monitor.key_max_index = profile.key_max_index;
        }
    }

    if (!filter_is_initialized()) {
        filter_set_initialized(true);
    }

    uint32_t now_ms = HAL_GetTick();
    analog_rest_estimator_observe(&analog_rest_estimator,
                                  logical_raw_values, NUM_KEYS, now_ms);
    adc_capture_process_scan(filtered_values, NUM_KEYS, now_ms);
}

/*
 * Read the raw value for a key
 */
uint16_t analog_read_raw_value(uint8_t key) {
    // Check if key is within valid range (0 to NUM_KEYS - 1)
    if (key >= NUM_KEYS) {
        return 0;
    }

    return logical_raw_values[key];
}

bool analog_get_stable_rest_values(uint32_t now_ms, uint16_t reference_zero,
                                   uint16_t max_reference_delta,
                                   int16_t *values_out, uint8_t key_count) {
    return analog_rest_estimator_snapshot(&analog_rest_estimator, now_ms,
                                          reference_zero,
                                          max_reference_delta, values_out,
                                          key_count);
}

/*
 * Read the EMA-filtered ADC value for a key, before calibration/LUT.
 */
uint16_t analog_read_filtered_value(uint8_t key) {
    // Check if key is within valid range (0 to NUM_KEYS - 1)
    if (key >= NUM_KEYS) {
        return 0;
    }

    // Return the filtered value
    return filtered_values[key];
}

/*
 * Read the calibrated ADC value for a key, after EMA and calibration but
 * before LUT distance conversion.
 */
uint16_t analog_read_calibrated_value(uint8_t key) {
    if (key >= NUM_KEYS) {
        return 0;
    }

    return calibrated_values[key];
}

int16_t analog_read_distance_value(uint8_t key) {
    // Check if key is within valid range (0 to NUM_KEYS - 1)
    if (key >= NUM_KEYS) {
        return 0;
    }

    // Return the distance value
    return distance_values[key];
}

int16_t analog_read_travel_distance_value(uint8_t key) {
    uint32_t distance = 0u;
    uint32_t calibrated_max = 0u;
    uint32_t scaled = 0u;

    if (key >= NUM_KEYS) {
        return 0;
    }

    distance = distance_values[key];
    calibrated_max = calibration_get_max_distance_um(key);
    if (distance == 0u || calibrated_max == 0u) {
        return 0;
    }

    /* Extrapolate past the calibrated reference instead of saturating on it.
     * calibration_get_max_distance_um() is the peak captured during guided
     * calibration, not the mechanical end of travel, so saturating there made
     * every position deeper than that peak report the exact same value.
     * Rapid trigger is purely differential (current - min_top,
     * max_bottom - current), so inside that flat zone no press and no release
     * could ever be detected: bottoming out hard swallowed the keystroke.
     * The relation stays linear and identical below the calibrated peak; only
     * the previously flat region changes. */
    scaled = ((distance * (uint32_t)SETTINGS_LOGICAL_TRAVEL_UM) +
              (calibrated_max / 2u)) /
             calibrated_max;

    /* Overflow guard only. A calibrated peak degenerate enough to reach this
     * bound is already broken calibration; real values stay far below it
     * because the sensor LUT itself tops out around 3.5 mm. */
    if (scaled > (uint32_t)ANALOG_TRAVEL_EXTRAPOLATION_MAX_UM) {
        scaled = (uint32_t)ANALOG_TRAVEL_EXTRAPOLATION_MAX_UM;
    }

    return (int16_t)scaled;
}

uint8_t analog_read_normalized_value(uint8_t key) {
    if (key >= NUM_KEYS) {
        return 0u;
    }

    return normalized_values[key];
}

/*
 * ADC conversion complete callback
 * This function is called when the ADC conversion is completed
 */
void HAL_ADC_ConvCpltCallback(ADC_HandleTypeDef *hadc) {
    // Check if the callback is for the correct ADC instance
    if (hadc->Instance != analog_config.hadc->Instance) {
        return;
    }

    memcpy(&raw_values[(uint16_t)current_mux_channel * NUM_MUX],
           adc_buffer,
           (size_t)NUM_MUX * sizeof(adc_buffer[0]));

    // Increment MUX channel
    current_mux_channel++;

    // Reset to channel 0 if we've reached the end of the channels
    if (current_mux_channel >= NUM_MUX_CHANNELS) {
        current_mux_channel = 0;
        __DMB();
        is_scan_complete = true;
    }

    // Select the next MUX channel
    multiplexer_select_mux_channel(current_mux_channel);

    // Trigger timer to restart ADC conversion after MUX settling time
    if (!is_scan_complete) {
        TIM4->SR = ~TIM_SR_UIF;
        TIM4->CNT = 0;
        TIM4->CR1 |= TIM_CR1_CEN;
    }
}

bool analog_is_scan_complete() {
    bool complete = is_scan_complete;
    if (complete) {
        __DMB();
    }
    return complete;
}

void analog_set_scan_complete(bool complete) {
    __DMB();
    is_scan_complete = complete;
    __DMB();
}

void HAL_ADC_ErrorCallback(ADC_HandleTypeDef *hadc) {
    if (hadc == NULL || analog_config.hadc == NULL ||
        hadc->Instance != analog_config.hadc->Instance) {
        return;
    }
    scan_fault_pending = true;
}

bool analog_take_scan_fault(void) {
    uint32_t primask = __get_PRIMASK();
    bool pending = false;
    __disable_irq();
    pending = scan_fault_pending;
    scan_fault_pending = false;
    if (primask == 0u) {
        __enable_irq();
    }
    return pending;
}

void analog_reset_scan_state(void) {
    uint32_t primask = __get_PRIMASK();
    __disable_irq();
    current_mux_channel = 0u;
    is_scan_complete = false;
    scan_fault_pending = false;
    __DMB();
    multiplexer_select_mux_channel(0u);
    if (primask == 0u) {
        __enable_irq();
    }
}

uint16_t* analog_get_adc_buffer_ptr(void) {
    return adc_buffer;
}

void analog_get_task_monitor(analog_task_monitor_t* monitor) {
    if (monitor == NULL) {
        return;
    }

    *monitor = analog_task_monitor;
}
