Fefe-Nayz/kbhe-monorepo/firmware/Core/Src/led_matrix.c

/*
 * led_matrix.c
 * RGB LED strip/matrix driver using WS2812
 */

#include "led_matrix.h"
#include "analog/analog.h"
#include "led_indicator.h"
#include "led_overlay_math.h"
#include "main.h"
#include "settings.h"
#include "trigger/trigger.h"
// #include "trigger.h"
#include "ws2812.h"
#include <string.h>
#include <math.h>
#include <stdlib.h>


//--------------------------------------------------------------------+
// Private Variables
//--------------------------------------------------------------------+

// WS2812 handle - made globally accessible for DMA callbacks
ws2812_handleTypeDef led_ws2812_handle;

// Static matrix pattern (user/software editable, persisted in settings)
static uint8_t pixels_static[LED_MATRIX_DATA_SIZE];

// Runtime frame currently displayed on LEDs (effects/third-party/live state)
static uint8_t pixels_runtime[LED_MATRIX_DATA_SIZE];

// Temporary high-priority output frame that masks runtime pixels while active.
static uint8_t pixels_output_override[LED_MATRIX_DATA_SIZE];
static bool output_override_active = false;

// Current brightness
static uint8_t current_brightness = LED_BRIGHTNESS_DEFAULT;

// Enabled state
static bool display_enabled = true;
static bool idle_sleep_active = false;
static bool usb_suspend_active = false;
static uint8_t idle_timeout_seconds = SETTINGS_DEFAULT_LED_IDLE_TIMEOUT_SECONDS;
static bool allow_system_indicators_when_disabled =
  SETTINGS_DEFAULT_LED_ALLOW_SYSTEM_WHEN_DISABLED != 0u;
static bool idle_third_party_stream_counts_as_activity =
  SETTINGS_DEFAULT_LED_IDLE_THIRD_PARTY_STREAM_ACTIVITY != 0u;
static uint32_t last_activity_ms = 0u;

// Initialized flag
static bool initialized = false;

// Effect state variables
static led_effect_mode_t current_effect = LED_EFFECT_NONE;
static uint32_t effect_generation = 1u;
static uint8_t fps_limit = 60; // Default 60 FPS
static uint8_t effect_params[LED_EFFECT_PARAM_COUNT] = {
  [LED_EFFECT_PARAM_SPEED] = 128u,
};
static uint32_t last_effect_tick = 0;
static uint32_t last_render_tick = 0; // Separate tick for FPS limiting
static uint32_t last_sim_tick = 0;    // Simulation updates are FPS-independent
static uint16_t effect_offset = 0;

// Effect renderer context flag: when true, pixel writes target runtime frame only.
static bool effect_render_context = false;
static uint16_t pixel_batch_depth = 0u;
static bool pixel_batch_show_pending = false;

typedef struct {
  bool active;
  uint8_t source_key;
  uint8_t hue;
  uint8_t energy;
  uint16_t age_ms;
} reactive_wave_t;

#define REACTIVE_WAVE_POOL_SIZE 24u
static reactive_wave_t reactive_waves[REACTIVE_WAVE_POOL_SIZE];
static uint16_t reactive_heat_energy[NUM_KEYS] = {0};
static uint16_t reactive_ghost_energy[NUM_KEYS] = {0};
static uint8_t mxfx_typing_heat_energy[NUM_KEYS] = {0};
static uint32_t mxfx_typing_heat_decay_timer_ms = 0u;
static uint16_t impact_boost = 0u;

#define mxfx_LED_HITS_TO_REMEMBER 8u
#define mxfx_COORD_MAX_X 224u
#define mxfx_COORD_MAX_Y 64u
#define mxfx_CENTER_X (mxfx_COORD_MAX_X / 2u)
#define mxfx_CENTER_Y (mxfx_COORD_MAX_Y / 2u)

typedef struct {
  uint8_t count;
  uint8_t x[mxfx_LED_HITS_TO_REMEMBER];
  uint8_t y[mxfx_LED_HITS_TO_REMEMBER];
  uint8_t index[mxfx_LED_HITS_TO_REMEMBER];
  uint16_t tick[mxfx_LED_HITS_TO_REMEMBER];
} mxfx_last_hit_t;

typedef struct {
  uint8_t h;
  uint8_t s;
  uint8_t v;
} led_hsv_t;

typedef struct {
  uint8_t scale;
  uint8_t bias;
  bool initialized;
} mxfx_runner_time_map_t;

typedef void (*mxfx_reactive_math_f)(const led_hsv_t *base, led_hsv_t *hsv,
                                    uint16_t offset);
typedef void (*mxfx_reactive_splash_math_f)(const led_hsv_t *base,
                                           led_hsv_t *hsv, int16_t dx,
                                           int16_t dy, uint8_t dist,
                                           uint16_t tick);

static mxfx_last_hit_t mxfx_last_hit_tracker = {0};

static mxfx_runner_time_map_t mxfx_runner_time_i_map[LED_EFFECT_MAX] = {0};
static mxfx_runner_time_map_t mxfx_runner_time_dxdy_map[LED_EFFECT_MAX] = {0};
static mxfx_runner_time_map_t mxfx_runner_time_sincos_map[LED_EFFECT_MAX] = {0};

static uint8_t audio_spectrum_levels[LED_AUDIO_SPECTRUM_BAND_COUNT] = {0};
static uint8_t audio_impact_level = 0u;
static bool audio_spectrum_valid = false;
static uint32_t audio_spectrum_refresh_ms = 0u;

/* Alpha-key mask for LED_EFFECT_ALPHA_MODS.
 * Bit i (LSB-first per byte) = 1 → key i is an "alpha" key.
 * All-zero means "not configured"; effect falls back to keycode-range check. */
#define ALPHA_MASK_BYTES ((NUM_KEYS + 7u) / 8u)
static uint8_t alpha_key_mask[ALPHA_MASK_BYTES] = {0};
static bool    alpha_key_mask_configured = false;

#define AUDIO_SPECTRUM_STALE_MS 500u

// Temporary volume overlay shown on the function row.
static bool volume_overlay_active = false;
static uint8_t volume_overlay_level = 0u;
static uint32_t volume_overlay_start_ms = 0u;
static uint8_t volume_overlay_fade_in_from_alpha = 0u;
static uint32_t volume_overlay_expire_ms = 0u;
static bool volume_overlay_fade_out_active = false;
static uint8_t volume_overlay_fade_out_from_alpha = 0u;
static uint32_t volume_overlay_fade_out_start_ms = 0u;
static uint8_t volume_overlay_rendered_alpha = 0u;
static bool volume_overlay_render_dirty = false;
static settings_rotary_encoder_t volume_overlay_render_config = {0};
static bool volume_overlay_render_config_valid = false;
static bool host_volume_level_valid = false;
static uint8_t host_volume_level = 0u;
static uint32_t host_volume_level_refresh_ms = 0u;

static const uint8_t volume_overlay_keys[] = {
    0u, 1u, 2u, 3u, 4u, 5u, 6u, 7u, 8u, 9u, 10u, 11u, 12u, 13u
};
#define VOLUME_OVERLAY_KEY_COUNT                                                \
  (sizeof(volume_overlay_keys) / sizeof(volume_overlay_keys[0]))
#define HOST_VOLUME_LEVEL_STALE_MS 1250u
#define HOST_VOLUME_STEP_ESTIMATE 5u
#define VOLUME_OVERLAY_VISIBLE_MS 1200u
#define VOLUME_OVERLAY_FADE_IN_MS 80u
#define VOLUME_OVERLAY_FADE_OUT_MS 100u

typedef struct {
  bool visible;
  bool target_active;
  bool expire_active;
  bool render_dirty;
  uint8_t from_alpha;
  uint8_t rendered_alpha;
  uint32_t transition_start_ms;
  uint32_t expire_ms;
} led_state_overlay_runtime_t;

static led_state_overlay_config_t
    state_overlay_configs[LED_STATE_OVERLAY_COUNT] = {0};
static led_state_overlay_runtime_t
    state_overlay_runtime[LED_STATE_OVERLAY_COUNT] = {0};
static uint8_t state_overlay_order[LED_STATE_OVERLAY_COUNT] = {0, 1, 2, 3,
                                                               4, 5, 6, 7};

// Logical key order follows the physical keyboard layout (K1..K82).
// WS2812 chain order on the PCB is serpentine, so translate before pushing to
// the driver.
static const uint8_t LOGICAL_LED_INDEX_TO_PHYSICAL_LED_INDEX[NUM_KEYS] = {
    0, 1, 2, 3, 4, 5, 6, 7,
    8, 9, 10, 11, 12, 13, 28, 27,
    26, 25, 24, 23, 22, 21, 20, 19,
    18, 17, 16, 15, 14, 29, 30, 31,
    32, 33, 34, 35, 36, 37, 38, 39,
    40, 41, 42, 43, 57, 56, 55, 54,
    53, 52, 51, 50, 49, 48, 47, 46,
    45, 44, 58, 59, 60, 61, 62, 63,
    64, 65, 66, 67, 68, 69, 70, 71,
    81, 80, 79, 78, 77, 76, 75, 74,
    73, 72
};

#define CAPS_LOCK_LED_INDEX 44u

// Physical LED coordinates derived from the KiCad PCB placement (`75he`).
// Stored in logical key order, normalized to the top-left of the board and
// scaled in 0.1 mm to keep the math integer-only.
static const uint16_t led_pos_x[NUM_KEYS] = {
    0, 238, 429, 619, 810, 1048, 1238, 1429,
    1619, 1857, 2048, 2238, 2429, 2667, 0, 190,
    381, 572, 762, 952, 1143, 1334, 1524, 1715,
    1905, 2096, 2286, 2572, 2905, 48, 286, 476,
    667, 857, 1048, 1238, 1429, 1619, 1810, 2000,
    2191, 2381, 2643, 2905, 71, 333, 524, 714,
    905, 1095, 1286, 1476, 1667, 1857, 2048, 2238,
    2429, 2905, 24, 238, 428, 619, 810, 1000,
    1191, 1381, 1572, 1762, 1953, 2143, 2405, 2715,
    24, 262, 500, 1214, 1905, 2096, 2286, 2524,
    2715, 2905,
};

static const uint16_t led_pos_y[NUM_KEYS] = {
    0, 0, 0, 0, 0, 0, 0, 0,
    0, 0, 0, 0, 0, 0, 238, 238,
    238, 238, 238, 238, 238, 238, 238, 238,
    238, 238, 238, 238, 238, 429, 429, 429,
    429, 429, 429, 429, 429, 429, 429, 429,
    429, 429, 524, 429, 619, 619, 619, 619,
    619, 619, 619, 619, 619, 619, 619, 619,
    619, 619, 810, 810, 810, 810, 810, 810,
    810, 810, 810, 810, 810, 810, 810, 857,
    1000, 1000, 1000, 1000, 1000, 1000, 1000, 1048,
    1048, 1048,
};

#define LED_LAYOUT_MAX_X 2905u
#define LED_LAYOUT_MAX_Y 1048u
#define LED_LAYOUT_CENTER_X (LED_LAYOUT_MAX_X / 2u)
#define LED_LAYOUT_CENTER_Y (LED_LAYOUT_MAX_Y / 2u)

static void effect_plasma(void);
static void effect_fire(void);
static void effect_ocean(void);
static void effect_sparkle(void);
static void effect_breathing_rainbow(void);
static void effect_color_cycle(void);
static void effect_distance_sensor(void);
static void effect_impact_rainbow(void);
static void effect_reactive_ghost(void);
static void effect_audio_spectrum(void);
static void effect_key_state_demo(void);
static void effect_bass_ripple(void);
static void effect_cycle_pinwheel(void);
static void effect_cycle_spiral(void);
static void effect_cycle_out_in_dual(void);
static void effect_rainbow_beacon(void);
static void effect_rainbow_pinwheels(void);
static void effect_rainbow_moving_chevron(void);
static void effect_hue_breathing(void);
static void effect_hue_pendulum(void);
static void effect_hue_wave(void);
static void effect_riverflow(void);
static void effect_solid_color(void);
static void effect_alpha_mods(void);
static void effect_gradient_up_down(void);
static void effect_gradient_left_right(void);
static void effect_breathing(void);
static void effect_colorband_sat(void);
static void effect_colorband_val(void);
static void effect_colorband_pinwheel_sat(void);
static void effect_colorband_pinwheel_val(void);
static void effect_colorband_spiral_sat(void);
static void effect_colorband_spiral_val(void);
static void effect_cycle_all(void);
static void effect_cycle_left_right(void);
static void effect_cycle_up_down(void);
static void effect_cycle_out_in(void);
static void effect_dual_beacon(void);
static void effect_flower_blooming(void);
static void effect_raindrops(void);
static void effect_jellybean_raindrops(void);
static void effect_pixel_rain(void);
static void effect_pixel_flow(void);
static void effect_pixel_fractal(void);
static void effect_typing_heatmap(void);
static void effect_digital_rain(void);
static void effect_solid_reactive_simple(void);
static void effect_solid_reactive(void);
static void effect_solid_reactive_wide(void);
static void effect_solid_reactive_cross(void);
static void effect_solid_reactive_nexus(void);
static void effect_splash(void);
static void effect_solid_splash(void);
static void effect_starlight_smooth(void);
static void effect_starlight(void);
static void effect_starlight_dual_sat(void);
static void effect_starlight_dual_hue(void);
static void effect_solid_reactive_multi_wide(void);
static void effect_solid_reactive_multi_cross(void);
static void effect_solid_reactive_multi_nexus(void);
static void effect_multi_splash(void);
static void effect_solid_multi_splash(void);

static void reactive_tick_simulation(uint16_t delta_ms);
static void led_matrix_mark_activity(uint32_t now_ms);
static void led_matrix_mark_third_party_stream_activity(void);
static void led_matrix_apply_idle_state(uint32_t now_ms);
static void led_matrix_rgb_to_hsv(uint8_t r, uint8_t g, uint8_t b,
                                  uint8_t *h, uint8_t *s, uint8_t *v);

//--------------------------------------------------------------------+
// Private Functions
//--------------------------------------------------------------------+

/**
 * @brief Convert x,y to linear index
 */
static inline uint8_t xy_to_index(uint8_t x, uint8_t y) {
  // Standard row-major layout
  // Adjust here if your LED strip has a different wiring pattern
  return y * LED_MATRIX_WIDTH + x;
}

/**
 * @brief Apply brightness to a color value
 */
static inline uint8_t apply_brightness(uint8_t color, uint8_t brightness) {
  return (uint8_t)((uint16_t)color * brightness / 255);
}

static inline uint8_t abs_u8_diff(uint8_t a, uint8_t b) {
  return (a > b) ? (a - b) : (b - a);
}

static inline uint16_t abs_u16_diff(uint16_t a, uint16_t b) {
  return (a > b) ? (a - b) : (b - a);
}

static inline uint8_t clamp_u16_to_u8(uint16_t value) {
  return (uint8_t)((value > 255u) ? 255u : value);
}

static inline uint8_t scale_u8(uint8_t value, uint8_t scale) {
  return (uint8_t)(((uint16_t)value * scale) / 255u);
}

static inline uint8_t scale_coord_to_u8(uint16_t value, uint16_t max_value) {
  if (max_value == 0u) {
    return 0u;
  }

  return (uint8_t)(((uint32_t)value * 255u) / max_value);
}

static inline uint8_t effect_param(uint8_t index, uint8_t fallback) {
  if (index >= LED_EFFECT_PARAM_COUNT) {
    return fallback;
  }
  return effect_params[index];
}

static inline uint8_t effect_animation_speed(void) {
  uint8_t speed = effect_param(LED_EFFECT_PARAM_SPEED, 128u);
  return speed > 0u ? speed : 1u;
}

static inline uint32_t effect_interval_from_speed(uint8_t speed) {
  uint32_t interval = 200u - ((uint32_t)speed * 195u / 255u);
  return interval < 5u ? 5u : interval;
}

static inline uint8_t mxfx_runner_effect_id(void) {
  uint8_t id = (uint8_t)current_effect;
  return (id < (uint8_t)LED_EFFECT_MAX) ? id : 0u;
}

static inline uint8_t mxfx_runner_time_from_scale(mxfx_runner_time_map_t *map,
                                                  uint8_t scale) {
  uint16_t tick = (uint16_t)HAL_GetTick();
  uint8_t raw = (uint8_t)(((uint32_t)tick * scale) >> 8);

  if (!map->initialized) {
    map->scale = scale;
    map->bias = 0u;
    map->initialized = true;
    return raw;
  }

  if (map->scale != scale) {
    uint8_t old_raw = (uint8_t)(((uint32_t)tick * map->scale) >> 8);
    uint8_t old_time = (uint8_t)(old_raw + map->bias);
    map->scale = scale;
    raw = (uint8_t)(((uint32_t)tick * map->scale) >> 8);
    map->bias = (uint8_t)(old_time - raw);
  }

  return (uint8_t)(raw + map->bias);
}

static inline bool effect_param_flag(uint8_t index, bool fallback) {
  return effect_param(index, fallback ? 1u : 0u) != 0u;
}

static inline void effect_primary_color(uint8_t fallback_r, uint8_t fallback_g,
                                        uint8_t fallback_b, uint8_t *r,
                                        uint8_t *g, uint8_t *b) {
  if (r != NULL) {
    *r = effect_param(LED_EFFECT_PARAM_COLOR_R, fallback_r);
  }
  if (g != NULL) {
    *g = effect_param(LED_EFFECT_PARAM_COLOR_G, fallback_g);
  }
  if (b != NULL) {
    *b = effect_param(LED_EFFECT_PARAM_COLOR_B, fallback_b);
  }
}

static inline void effect_secondary_color(uint8_t fallback_r,
                                          uint8_t fallback_g,
                                          uint8_t fallback_b, uint8_t *r,
                                          uint8_t *g, uint8_t *b) {
  if (r != NULL) {
    *r = effect_param(LED_EFFECT_PARAM_COLOR2_R, fallback_r);
  }
  if (g != NULL) {
    *g = effect_param(LED_EFFECT_PARAM_COLOR2_G, fallback_g);
  }
  if (b != NULL) {
    *b = effect_param(LED_EFFECT_PARAM_COLOR2_B, fallback_b);
  }
}

static inline uint16_t effect_param_coord(uint8_t index, uint16_t max_value,
                                          uint8_t fallback) {
  return (uint16_t)(((uint32_t)effect_param(index, fallback) * max_value) /
                    255u);
}

static inline uint8_t mxfx_qadd8(uint8_t a, uint8_t b) {
  uint16_t sum = (uint16_t)a + b;
  return (uint8_t)((sum > 255u) ? 255u : sum);
}

static inline uint8_t mxfx_scale8(uint8_t value, uint8_t scale) {
  return (uint8_t)(((uint16_t)value * scale) >> 8);
}

static inline uint16_t mxfx_scale16by8(uint16_t value, uint8_t scale) {
  return (uint16_t)(((uint32_t)value * scale) >> 8);
}

static inline uint16_t mxfx_timer16(void) {
  return (uint16_t)HAL_GetTick();
}

static inline uint8_t mxfx_runner_time_i(void) {
  uint8_t id = mxfx_runner_effect_id();
  uint8_t scale =
      mxfx_qadd8((uint8_t)(effect_animation_speed() / 4u), 1u);
  return mxfx_runner_time_from_scale(&mxfx_runner_time_i_map[id], scale);
}

static inline uint8_t mxfx_runner_time_dx_dy(void) {
  uint8_t id = mxfx_runner_effect_id();
  uint8_t scale = (uint8_t)(effect_animation_speed() / 2u);
  return mxfx_runner_time_from_scale(&mxfx_runner_time_dxdy_map[id], scale);
}

static inline uint8_t mxfx_runner_time_sin_cos(void) {
  uint8_t id = mxfx_runner_effect_id();
  uint8_t scale = (uint8_t)(effect_animation_speed() / 4u);
  return mxfx_runner_time_from_scale(&mxfx_runner_time_sincos_map[id], scale);
}

static uint8_t mxfx_sin8(uint8_t angle) {
  float radians = ((float)angle / 256.0f) * (2.0f * 3.14159265358979323846f);
  float value = sinf(radians);
  int16_t scaled = (int16_t)(127.5f + (value * 127.5f));
  if (scaled < 0) {
    scaled = 0;
  } else if (scaled > 255) {
    scaled = 255;
  }
  return (uint8_t)scaled;
}

static uint8_t mxfx_cos8(uint8_t angle) {
  float radians = ((float)angle / 256.0f) * (2.0f * 3.14159265358979323846f);
  float value = cosf(radians);
  int16_t scaled = (int16_t)(127.5f + (value * 127.5f));
  if (scaled < 0) {
    scaled = 0;
  } else if (scaled > 255) {
    scaled = 255;
  }
  return (uint8_t)scaled;
}

static inline uint8_t mxfx_random8(void) {
  return (uint8_t)(rand() & 0xFFu);
}

static inline uint8_t mxfx_random8_max(uint8_t max) {
  if (max == 0u) {
    return 0u;
  }
  return (uint8_t)(mxfx_random8() % max);
}

static inline uint8_t mxfx_random8_min_max(uint8_t min, uint8_t max) {
  if (max <= min) {
    return min;
  }
  return (uint8_t)(min + (mxfx_random8() % (uint8_t)(max - min)));
}

static uint16_t mxfx_sqrt32(uint32_t value) {
  uint32_t result = 0u;
  uint32_t bit = 1uL << 30;

  while (bit > value) {
    bit >>= 2;
  }

  while (bit != 0u) {
    if (value >= result + bit) {
      value -= result + bit;
      result = (result >> 1) + bit;
    } else {
      result >>= 1;
    }
    bit >>= 2;
  }

  return (uint16_t)result;
}

static inline uint8_t mxfx_led_coord_x(uint8_t index) {
  return (uint8_t)(((uint32_t)led_pos_x[index] * mxfx_COORD_MAX_X) /
                   LED_LAYOUT_MAX_X);
}

static inline uint8_t mxfx_led_coord_y(uint8_t index) {
  return (uint8_t)(((uint32_t)led_pos_y[index] * mxfx_COORD_MAX_Y) /
                   LED_LAYOUT_MAX_Y);
}

static inline uint8_t mxfx_distance_u8(int16_t dx, int16_t dy) {
  uint16_t adx = (dx < 0) ? (uint16_t)(-dx) : (uint16_t)dx;
  uint16_t ady = (dy < 0) ? (uint16_t)(-dy) : (uint16_t)dy;
  uint16_t dist = mxfx_sqrt32((uint32_t)adx * adx + (uint32_t)ady * ady);
  return (uint8_t)((dist > 255u) ? 255u : dist);
}

static inline uint8_t mxfx_project_axis_u8(int16_t x, int16_t y,
                                           int16_t dir_x, int16_t dir_y) {
  /* Normalize by sqrt(128^2 + 128^2) ~= 181 so diagonal angles stay in range
   * without hard clipping, then remap from signed to 0..255 axis. */
  int32_t dot = ((int32_t)x * dir_x) + ((int32_t)y * dir_y);
  int16_t projection = (int16_t)(dot / 181) + 128;

  if (projection < 0) {
    projection = 0;
  } else if (projection > 255) {
    projection = 255;
  }

  return (uint8_t)projection;
}

static led_hsv_t effect_primary_hsv(uint8_t fallback_r, uint8_t fallback_g,
                                    uint8_t fallback_b) {
  led_hsv_t hsv = {0u, 0u, 0u};
  uint8_t r = effect_params[LED_EFFECT_PARAM_COLOR_R];
  uint8_t g = effect_params[LED_EFFECT_PARAM_COLOR_G];
  uint8_t b = effect_params[LED_EFFECT_PARAM_COLOR_B];

  /* Treat stored (0,0,0) as "not configured" and fall back to the per-call
   * default.  This preserves QMK pixel-perfect behavior for effects that do
   * not have an explicit PCOLOR entry in their schema. */
  if (r == 0u && g == 0u && b == 0u) {
    r = fallback_r;
    g = fallback_g;
    b = fallback_b;
  }

  led_matrix_rgb_to_hsv(r, g, b, &hsv.h, &hsv.s, &hsv.v);
  return hsv;
}

static void mxfx_reactive_record_hit(uint8_t key_index) {
  uint8_t slot = mxfx_last_hit_tracker.count;

  if (slot >= mxfx_LED_HITS_TO_REMEMBER) {
    memmove(&mxfx_last_hit_tracker.x[0], &mxfx_last_hit_tracker.x[1],
            mxfx_LED_HITS_TO_REMEMBER - 1u);
    memmove(&mxfx_last_hit_tracker.y[0], &mxfx_last_hit_tracker.y[1],
            mxfx_LED_HITS_TO_REMEMBER - 1u);
    memmove(&mxfx_last_hit_tracker.index[0], &mxfx_last_hit_tracker.index[1],
            mxfx_LED_HITS_TO_REMEMBER - 1u);
    memmove(&mxfx_last_hit_tracker.tick[0], &mxfx_last_hit_tracker.tick[1],
            (mxfx_LED_HITS_TO_REMEMBER - 1u) * sizeof(uint16_t));
    slot = mxfx_LED_HITS_TO_REMEMBER - 1u;
  }

  mxfx_last_hit_tracker.x[slot] = mxfx_led_coord_x(key_index);
  mxfx_last_hit_tracker.y[slot] = mxfx_led_coord_y(key_index);
  mxfx_last_hit_tracker.index[slot] = key_index;
  mxfx_last_hit_tracker.tick[slot] = 0u;
  mxfx_last_hit_tracker.count = slot + 1u;
}

static void mxfx_reactive_tick_hits(uint16_t delta_ms) {
  for (uint8_t i = 0u; i < mxfx_last_hit_tracker.count; i++) {
    if (UINT16_MAX - delta_ms < mxfx_last_hit_tracker.tick[i]) {
      mxfx_last_hit_tracker.tick[i] = UINT16_MAX;
    } else {
      mxfx_last_hit_tracker.tick[i] =
          (uint16_t)(mxfx_last_hit_tracker.tick[i] + delta_ms);
    }
  }
}

static void mxfx_reactive_render(mxfx_reactive_math_f math_fn) {
  led_hsv_t base_hsv = effect_primary_hsv(255u, 0u, 0u);
  uint8_t speed_scale = mxfx_qadd8(effect_animation_speed(), 1u);
  uint16_t max_tick = (uint16_t)(65535u / speed_scale);

  for (uint8_t i = 0u; i < LED_MATRIX_NUM_LEDS; i++) {
    uint16_t tick = max_tick;
    led_hsv_t hsv = base_hsv;

    for (int8_t j = (int8_t)mxfx_last_hit_tracker.count - 1; j >= 0; j--) {
      if (mxfx_last_hit_tracker.index[(uint8_t)j] == i &&
          mxfx_last_hit_tracker.tick[(uint8_t)j] < tick) {
        tick = mxfx_last_hit_tracker.tick[(uint8_t)j];
        break;
      }
    }

    if (math_fn != NULL) {
      uint16_t offset = mxfx_scale16by8(tick, speed_scale);
      math_fn(&base_hsv, &hsv, offset);
    }

    {
      uint8_t r = 0u;
      uint8_t g = 0u;
      uint8_t b = 0u;
      led_matrix_hsv_to_rgb(hsv.h, hsv.s, hsv.v, &r, &g, &b);
      led_matrix_set_pixel_idx(i, r, g, b);
    }
  }
}

static void mxfx_reactive_splash_render(uint8_t start,
                                       mxfx_reactive_splash_math_f math_fn) {
  led_hsv_t base_hsv = effect_primary_hsv(255u, 0u, 0u);
  uint8_t speed_scale = mxfx_qadd8(effect_animation_speed(), 1u);
  uint8_t count = mxfx_last_hit_tracker.count;
  uint8_t begin = (start < count) ? start : count;

  for (uint8_t i = 0u; i < LED_MATRIX_NUM_LEDS; i++) {
    led_hsv_t hsv = base_hsv;
    int16_t x = mxfx_led_coord_x(i);
    int16_t y = mxfx_led_coord_y(i);
    hsv.v = 0u;

    for (uint8_t j = begin; j < count; j++) {
      int16_t dx = (int16_t)(x - mxfx_last_hit_tracker.x[j]);
      int16_t dy = (int16_t)(y - mxfx_last_hit_tracker.y[j]);
      uint8_t dist = mxfx_distance_u8(dx, dy);
      uint16_t tick = mxfx_scale16by8(mxfx_last_hit_tracker.tick[j], speed_scale);
      math_fn(&base_hsv, &hsv, dx, dy, dist, tick);
    }

    hsv.v = mxfx_scale8(hsv.v, base_hsv.v);

    {
      uint8_t r = 0u;
      uint8_t g = 0u;
      uint8_t b = 0u;
      led_matrix_hsv_to_rgb(hsv.h, hsv.s, hsv.v, &r, &g, &b);
      led_matrix_set_pixel_idx(i, r, g, b);
    }
  }
}

static uint8_t pseudo_angle_u8(int16_t x, int16_t y) {
  uint16_t ax = (x < 0) ? (uint16_t)(-x) : (uint16_t)x;
  uint16_t ay = (y < 0) ? (uint16_t)(-y) : (uint16_t)y;
  uint16_t sum = (uint16_t)(ax + ay);
  uint8_t octant = (sum == 0u) ? 0u : (uint8_t)(((uint32_t)ay * 64u) / sum);

  if (x >= 0 && y >= 0) {
    return octant;
  }
  if (x < 0 && y >= 0) {
    return (uint8_t)(128u - octant);
  }
  if (x < 0 && y < 0) {
    return (uint8_t)(128u + octant);
  }

  return (uint8_t)(255u - octant);
}

static inline uint16_t led_layout_distance(uint8_t a, uint8_t b) {
  uint16_t dx = abs_u16_diff(led_pos_x[a], led_pos_x[b]);
  uint16_t dy = abs_u16_diff(led_pos_y[a], led_pos_y[b]);
  uint16_t major = (dx > dy) ? dx : dy;
  uint16_t minor = (dx > dy) ? dy : dx;
  return major + (minor / 2u);
}

static inline void add_scaled_rgb(uint16_t *r_acc, uint16_t *g_acc,
                                  uint16_t *b_acc, uint8_t r, uint8_t g,
                                  uint8_t b, uint8_t intensity) {
  *r_acc += ((uint16_t)r * intensity) / 255u;
  *g_acc += ((uint16_t)g * intensity) / 255u;
  *b_acc += ((uint16_t)b * intensity) / 255u;
}

static inline void mix_rgb_towards_white(uint8_t *r, uint8_t *g, uint8_t *b,
                                         uint8_t amount) {
  *r = (uint8_t)(*r + (((uint16_t)(255u - *r) * amount) / 255u));
  *g = (uint8_t)(*g + (((uint16_t)(255u - *g) * amount) / 255u));
  *b = (uint8_t)(*b + (((uint16_t)(255u - *b) * amount) / 255u));
}

static inline bool volume_overlay_is_expired(uint32_t now_ms) {
  return volume_overlay_active &&
         ((int32_t)(now_ms - volume_overlay_expire_ms) >= 0);
}

static uint8_t volume_overlay_alpha(uint32_t now_ms) {
  uint32_t age_ms = 0u;
  uint32_t remaining_ms = 0u;
  uint8_t alpha = 255u;

  if (!volume_overlay_active) {
    return 0u;
  }
  if (volume_overlay_fade_out_active) {
    age_ms = (uint32_t)(now_ms - volume_overlay_fade_out_start_ms);
    alpha = led_overlay_transition_u8(
        volume_overlay_fade_out_from_alpha, 0u, age_ms,
        VOLUME_OVERLAY_FADE_OUT_MS);
    if (age_ms >= VOLUME_OVERLAY_FADE_OUT_MS) {
      volume_overlay_active = false;
      volume_overlay_fade_out_active = false;
    }
    return alpha;
  }
  if (volume_overlay_is_expired(now_ms)) {
    volume_overlay_active = false;
    return 0u;
  }

  age_ms = (uint32_t)(now_ms - volume_overlay_start_ms);
  alpha = led_overlay_transition_u8(volume_overlay_fade_in_from_alpha, 255u,
                                    age_ms, VOLUME_OVERLAY_FADE_IN_MS);

  remaining_ms = (uint32_t)(volume_overlay_expire_ms - now_ms);
  if (remaining_ms < VOLUME_OVERLAY_FADE_OUT_MS) {
    uint8_t fade_out_alpha =
        (uint8_t)((remaining_ms * 255u) / VOLUME_OVERLAY_FADE_OUT_MS);
    if (fade_out_alpha < alpha) {
      alpha = fade_out_alpha;
    }
  }

  return alpha;
}

static bool volume_overlay_needs_refresh(uint32_t now_ms) {
  settings_rotary_encoder_t rotary = {0};
  uint8_t current_alpha = volume_overlay_alpha(now_ms);

  if (volume_overlay_render_dirty ||
      current_alpha != volume_overlay_rendered_alpha) {
    return true;
  }
  if (!volume_overlay_active || current_alpha == 0u) {
    return false;
  }

  settings_get_rotary_encoder(&rotary);
  return rotary.progress_style != (uint8_t)ROTARY_PROGRESS_STYLE_SOLID;
}

static void state_overlay_rebuild_order(void) {
  for (uint8_t i = 0u; i < LED_STATE_OVERLAY_COUNT; i++) {
    state_overlay_order[i] = i;
  }

  for (uint8_t i = 1u; i < LED_STATE_OVERLAY_COUNT; i++) {
    uint8_t candidate = state_overlay_order[i];
    uint8_t cursor = i;
    while (cursor > 0u &&
           state_overlay_configs[state_overlay_order[cursor - 1u]].priority >
               state_overlay_configs[candidate].priority) {
      state_overlay_order[cursor] = state_overlay_order[cursor - 1u];
      cursor--;
    }
    state_overlay_order[cursor] = candidate;
  }
}

static uint8_t state_overlay_transition_alpha(uint8_t overlay_id,
                                              uint32_t now_ms) {
  led_state_overlay_runtime_t *runtime = &state_overlay_runtime[overlay_id];
  const led_state_overlay_config_t *config =
      &state_overlay_configs[overlay_id];
  uint8_t target = runtime->target_active ? 255u : 0u;
  uint16_t duration = runtime->target_active ? config->fade_in_ms
                                             : config->fade_out_ms;
  uint32_t elapsed = (uint32_t)(now_ms - runtime->transition_start_ms);

  if (!runtime->visible || !config->enabled) {
    return 0u;
  }
  if (duration == 0u || elapsed >= duration) {
    if (!runtime->target_active) {
      runtime->visible = false;
    }
    return target;
  }

  return led_overlay_transition_u8(runtime->from_alpha, target, elapsed,
                                   duration);
}

static uint8_t state_overlay_alpha(uint8_t overlay_id, uint32_t now_ms) {
  led_state_overlay_runtime_t *runtime = &state_overlay_runtime[overlay_id];
  uint8_t current = state_overlay_transition_alpha(overlay_id, now_ms);

  if (runtime->target_active && runtime->expire_active &&
      (int32_t)(now_ms - runtime->expire_ms) >= 0) {
    runtime->from_alpha = current;
    runtime->target_active = false;
    runtime->transition_start_ms = now_ms;
    runtime->expire_active = false;
    runtime->expire_ms = 0u;
    current = state_overlay_transition_alpha(overlay_id, now_ms);
  }

  return current;
}

static bool state_overlay_applies_to_key(
    const led_state_overlay_config_t *config, uint8_t key_index) {
  if ((config->flags & LED_OVERLAY_FLAG_ALL_KEYS) != 0u) {
    return true;
  }
  return (config->key_mask[key_index / 8u] &
          (uint8_t)(1u << (key_index % 8u))) != 0u;
}

static void apply_state_overlays(uint8_t index, uint32_t now_ms, uint8_t *r,
                                 uint8_t *g, uint8_t *b) {
  for (uint8_t order = 0u; order < LED_STATE_OVERLAY_COUNT; order++) {
    uint8_t overlay_id = state_overlay_order[order];
    const led_state_overlay_config_t *config =
        &state_overlay_configs[overlay_id];
    uint8_t transition_alpha = 0u;
    uint8_t alpha = 0u;

    if (!config->enabled || !state_overlay_applies_to_key(config, index)) {
      continue;
    }

    transition_alpha = state_overlay_alpha(overlay_id, now_ms);
    if (transition_alpha == 0u) {
      continue;
    }
    alpha = scale_u8(config->opacity, transition_alpha);

    if (config->blend_mode == (uint8_t)LED_OVERLAY_BLEND_REPLACE) {
      *r = led_overlay_replace_channel(*r, config->color_r, config->opacity,
                                       transition_alpha);
      *g = led_overlay_replace_channel(*g, config->color_g, config->opacity,
                                       transition_alpha);
      *b = led_overlay_replace_channel(*b, config->color_b, config->opacity,
                                       transition_alpha);
    } else if (alpha == 0u) {
      continue;
    } else if (config->blend_mode == (uint8_t)LED_OVERLAY_BLEND_ADD) {
      *r = led_overlay_add_channel(*r, config->color_r, alpha);
      *g = led_overlay_add_channel(*g, config->color_g, alpha);
      *b = led_overlay_add_channel(*b, config->color_b, alpha);
    } else {
      *r = led_overlay_blend_channel(*r, config->color_r, alpha);
      *g = led_overlay_blend_channel(*g, config->color_g, alpha);
      *b = led_overlay_blend_channel(*b, config->color_b, alpha);
    }
  }
}

static inline uint8_t triangle_wave_u8(uint8_t phase) {
  if (phase < 128u) {
    return (uint8_t)(phase << 1);
  }

  return (uint8_t)((255u - phase) << 1);
}

static bool volume_overlay_slot_for_index(uint8_t index, uint8_t *slot_out) {
  for (uint8_t slot = 0u; slot < (uint8_t)VOLUME_OVERLAY_KEY_COUNT; slot++) {
    if (volume_overlay_keys[slot] == index) {
      if (slot_out != NULL) {
        *slot_out = slot;
      }
      return true;
    }
  }

  return false;
}

static uint8_t volume_overlay_fill_scale(uint8_t slot) {
  uint32_t scaled =
      (uint32_t)volume_overlay_level * (uint32_t)VOLUME_OVERLAY_KEY_COUNT;
  uint32_t filled = scaled / 255u;

  if (slot < filled) {
    return 255u;
  }
  if (slot == filled) {
    return (uint8_t)(scaled % 255u);
  }

  return 0u;
}

static void volume_overlay_effect_palette_color(led_effect_mode_t effect_mode,
                                                uint8_t slot, uint8_t *r,
                                                uint8_t *g, uint8_t *b) {
  uint8_t phase = (uint8_t)(((uint16_t)slot * 255u) /
                            ((VOLUME_OVERLAY_KEY_COUNT > 1u)
                                 ? (uint16_t)(VOLUME_OVERLAY_KEY_COUNT - 1u)
                                 : 1u));
  uint8_t anim_phase = (uint8_t)(phase + (uint8_t)(effect_offset * 3u));
  uint8_t wave = triangle_wave_u8((uint8_t)(effect_offset + phase));
  uint8_t color_r = 255u;
  uint8_t color_g = 0u;
  uint8_t color_b = 0u;

  effect_primary_color(255u, 0u, 0u, &color_r, &color_g, &color_b);

  switch (effect_mode) {
  case LED_EFFECT_STATIC_MATRIX: {
    uint8_t key = volume_overlay_keys[slot];
    *r = pixels_static[key * 3u + 0u];
    *g = pixels_static[key * 3u + 1u];
    *b = pixels_static[key * 3u + 2u];
    if (*r == 0u && *g == 0u && *b == 0u) {
      *r = color_r;
      *g = color_g;
      *b = color_b;
    }
    break;
  }
  case LED_EFFECT_SOLID_COLOR:
    *r = color_r;
    *g = color_g;
    *b = color_b;
    break;
  case LED_EFFECT_BREATHING: {
    uint8_t scale = (uint8_t)(32u + (((uint16_t)wave * 223u) / 255u));
    *r = scale_u8(color_r, scale);
    *g = scale_u8(color_g, scale);
    *b = scale_u8(color_b, scale);
    break;
  }
  case LED_EFFECT_FIRE:
    led_matrix_hsv_to_rgb((uint8_t)(6u + (phase / 10u)), 255u,
                          (uint8_t)(160u + (wave / 3u)), r, g, b);
    break;
  case LED_EFFECT_OCEAN:
    led_matrix_hsv_to_rgb((uint8_t)(132u + (phase / 6u)), 220u,
                          (uint8_t)(150u + (wave / 2u)), r, g, b);
    break;
  case LED_EFFECT_DIGITAL_RAIN:
    if (((slot + (effect_offset / 8u)) % 5u) == 0u) {
      *r = 220u;
      *g = 255u;
      *b = 220u;
    } else {
      led_matrix_hsv_to_rgb(96u, 255u, (uint8_t)(72u + (wave / 2u)), r, g, b);
    }
    break;
  case LED_EFFECT_SPARKLE:
    if (((slot + (effect_offset / 4u)) % 4u) == 0u) {
      *r = 255u;
      *g = 255u;
      *b = 255u;
    } else {
      led_matrix_hsv_to_rgb((uint8_t)(anim_phase + 24u), 170u, 180u, r, g, b);
    }
    break;
  case LED_EFFECT_CYCLE_LEFT_RIGHT:
  case LED_EFFECT_GRADIENT_LEFT_RIGHT:
  case LED_EFFECT_BREATHING_RAINBOW:
  case LED_EFFECT_COLOR_CYCLE:
    led_matrix_hsv_to_rgb(anim_phase, 255u, 255u, r, g, b);
    break;
  case LED_EFFECT_PLASMA:
  case LED_EFFECT_DISTANCE_SENSOR:
  default:
    led_matrix_hsv_to_rgb((uint8_t)(anim_phase + (slot * 9u)), 220u,
                          (uint8_t)(180u + (wave / 3u)), r, g, b);
    break;
  }
}

static void volume_overlay_base_color(
    const settings_rotary_encoder_t *rotary, uint8_t slot, uint8_t *r,
    uint8_t *g, uint8_t *b) {
  uint8_t hue = (uint8_t)(((uint16_t)slot * 255u) /
                          ((VOLUME_OVERLAY_KEY_COUNT > 1u)
                               ? (uint16_t)(VOLUME_OVERLAY_KEY_COUNT - 1u)
                               : 1u));

  switch ((rotary_progress_style_t)rotary->progress_style) {
  case ROTARY_PROGRESS_STYLE_RAINBOW:
    led_matrix_hsv_to_rgb((uint8_t)(hue + (uint8_t)(effect_offset * 4u)), 255u,
                          255u, r, g, b);
    break;
  case ROTARY_PROGRESS_STYLE_EFFECT_PALETTE:
    volume_overlay_effect_palette_color(
        (led_effect_mode_t)rotary->progress_effect_mode, slot, r, g, b);
    break;
  case ROTARY_PROGRESS_STYLE_SOLID:
  default:
    *r = rotary->progress_color_r;
    *g = rotary->progress_color_g;
    *b = rotary->progress_color_b;
    break;
  }
}

static bool volume_overlay_color_for_index(uint8_t index, uint32_t now_ms,
                                           uint8_t *r, uint8_t *g, uint8_t *b,
                                           uint8_t *alpha) {
  uint8_t slot = 0u;
  uint8_t fill_scale = 0u;

  if (!volume_overlay_active) {
    return false;
  }
  if (volume_overlay_is_expired(now_ms)) {
    volume_overlay_active = false;
    return false;
  }
  if (!volume_overlay_slot_for_index(index, &slot)) {
    return false;
  }

  *alpha = volume_overlay_alpha(now_ms);
  if (*alpha == 0u) {
    return false;
  }
  if (!volume_overlay_render_config_valid) {
    settings_get_rotary_encoder(&volume_overlay_render_config);
    volume_overlay_render_config_valid = true;
  }
  volume_overlay_base_color(&volume_overlay_render_config, slot, r, g, b);
  fill_scale = volume_overlay_fill_scale(slot);
  return led_overlay_prepare_progress_pixel(
      settings_rotary_is_progress_filled_only(&volume_overlay_render_config),
      fill_scale, r, g, b, alpha);
}

static inline bool led_matrix_full_output_enabled(void) {
  return display_enabled && !idle_sleep_active && !usb_suspend_active;
}

static bool state_overlays_visible(uint32_t now_ms) {
  for (uint8_t overlay_id = 0u; overlay_id < LED_STATE_OVERLAY_COUNT;
       overlay_id++) {
    if (state_overlay_alpha(overlay_id, now_ms) > 0u) {
      return true;
    }
  }
  return false;
}

static bool state_overlays_need_refresh(uint32_t now_ms) {
  for (uint8_t overlay_id = 0u; overlay_id < LED_STATE_OVERLAY_COUNT;
       overlay_id++) {
    led_state_overlay_runtime_t *runtime =
        &state_overlay_runtime[overlay_id];
    uint8_t current_alpha = state_overlay_alpha(overlay_id, now_ms);

    if (runtime->render_dirty || current_alpha != runtime->rendered_alpha) {
      return true;
    }
  }
  return false;
}

static bool led_matrix_system_overlay_enabled(uint32_t now_ms) {
  if (usb_suspend_active) {
    return false;
  }

  if (!allow_system_indicators_when_disabled) {
    return false;
  }

  if (volume_overlay_is_expired(now_ms)) {
    volume_overlay_active = false;
  }

  return volume_overlay_active || state_overlays_visible(now_ms) ||
         led_indicator_is_caps_lock();
}

static inline bool led_matrix_should_drive_output(uint32_t now_ms) {
  return led_matrix_full_output_enabled() ||
         led_matrix_system_overlay_enabled(now_ms);
}

/**
 * @brief Push one runtime pixel to WS2812 buffer
 */
static inline void push_runtime_pixel_to_ws2812_at(uint8_t index,
                                                   uint32_t now_ms) {
  bool full_output = led_matrix_full_output_enabled();
  uint8_t physical_index = LOGICAL_LED_INDEX_TO_PHYSICAL_LED_INDEX[index];
  const uint8_t *source_frame =
      output_override_active ? pixels_output_override : pixels_runtime;
  uint8_t source_r = source_frame[index * 3 + 0];
  uint8_t source_g = source_frame[index * 3 + 1];
  uint8_t source_b = source_frame[index * 3 + 2];
  uint8_t overlay_r = 0u;
  uint8_t overlay_g = 0u;
  uint8_t overlay_b = 0u;
  uint8_t overlay_alpha = 0u;

  if (!full_output) {
    source_r = 0u;
    source_g = 0u;
    source_b = 0u;
  }

  if (volume_overlay_color_for_index(index, now_ms, &overlay_r, &overlay_g,
                                     &overlay_b, &overlay_alpha)) {
    source_r = led_overlay_blend_channel(source_r, overlay_r, overlay_alpha);
    source_g = led_overlay_blend_channel(source_g, overlay_g, overlay_alpha);
    source_b = led_overlay_blend_channel(source_b, overlay_b, overlay_alpha);
  }

  apply_state_overlays(index, now_ms, &source_r, &source_g, &source_b);

  if (index == CAPS_LOCK_LED_INDEX && led_indicator_is_caps_lock()) {
    source_r = 255u;
    source_g = 255u;
    source_b = 255u;
  }

  uint8_t r = apply_brightness(source_r, current_brightness);
  uint8_t g = apply_brightness(source_g, current_brightness);
  uint8_t b = apply_brightness(source_b, current_brightness);
  setLedValues(&led_ws2812_handle, physical_index, r, g, b);
}

static inline void push_runtime_pixel_to_ws2812(uint8_t index) {
  push_runtime_pixel_to_ws2812_at(index, HAL_GetTick());
}

/**
 * @brief Update ws2812 driver with current pixel data
 */
static void update_ws2812(void) {
  uint32_t now_ms = 0u;

  if (!initialized) {
    return;
  }

  now_ms = HAL_GetTick();
  volume_overlay_render_config_valid = false;
  if (volume_overlay_active) {
    settings_get_rotary_encoder(&volume_overlay_render_config);
    volume_overlay_render_config_valid = true;
  }
  if (!led_matrix_should_drive_output(now_ms)) {
    // WS2812 keeps the previous frame latched until a new one is sent.
    // When output becomes fully disabled (e.g. Caps Lock overlay turns off),
    // push an explicit black frame so stale indicator pixels are cleared.
    zeroLedValues(&led_ws2812_handle);
    ws2812_show(&led_ws2812_handle);
    for (uint8_t overlay_id = 0u; overlay_id < LED_STATE_OVERLAY_COUNT;
         overlay_id++) {
      state_overlay_runtime[overlay_id].rendered_alpha = 0u;
      state_overlay_runtime[overlay_id].render_dirty = false;
    }
    volume_overlay_rendered_alpha = 0u;
    volume_overlay_render_dirty = false;
    return;
  }

  // Apply brightness and copy to WS2812 buffer
  for (uint8_t i = 0; i < LED_MATRIX_NUM_LEDS; i++) {
    push_runtime_pixel_to_ws2812_at(i, now_ms);
  }

  for (uint8_t overlay_id = 0u; overlay_id < LED_STATE_OVERLAY_COUNT;
       overlay_id++) {
    state_overlay_runtime[overlay_id].rendered_alpha =
        state_overlay_alpha(overlay_id, now_ms);
    state_overlay_runtime[overlay_id].render_dirty = false;
  }
  volume_overlay_rendered_alpha = volume_overlay_alpha(now_ms);
  volume_overlay_render_dirty = false;

  ws2812_show(&led_ws2812_handle);
}

static void sync_runtime_from_static(void) {
  memcpy(pixels_runtime, pixels_static, LED_MATRIX_DATA_SIZE);
  if (initialized && display_enabled) {
    update_ws2812();
  }
}

static void render_current_effect_frame(void) {
  effect_render_context = true;
  switch (current_effect) {
  case LED_EFFECT_PLASMA:
    effect_plasma();
    break;
  case LED_EFFECT_FIRE:
    effect_fire();
    break;
  case LED_EFFECT_OCEAN:
    effect_ocean();
    break;
  case LED_EFFECT_SPARKLE:
    effect_sparkle();
    break;
  case LED_EFFECT_BREATHING_RAINBOW:
    effect_breathing_rainbow();
    break;
  case LED_EFFECT_COLOR_CYCLE:
    effect_color_cycle();
    break;
  case LED_EFFECT_DISTANCE_SENSOR:
    effect_distance_sensor();
    break;
  case LED_EFFECT_IMPACT_RAINBOW:
    effect_impact_rainbow();
    break;
  case LED_EFFECT_REACTIVE_GHOST:
    effect_reactive_ghost();
    break;
  case LED_EFFECT_AUDIO_SPECTRUM:
    effect_audio_spectrum();
    break;
  case LED_EFFECT_KEY_STATE_DEMO:
    effect_key_state_demo();
    break;
  case LED_EFFECT_CYCLE_PINWHEEL:
    effect_cycle_pinwheel();
    break;
  case LED_EFFECT_CYCLE_SPIRAL:
    effect_cycle_spiral();
    break;
  case LED_EFFECT_CYCLE_OUT_IN_DUAL:
    effect_cycle_out_in_dual();
    break;
  case LED_EFFECT_RAINBOW_BEACON:
    effect_rainbow_beacon();
    break;
  case LED_EFFECT_RAINBOW_PINWHEELS:
    effect_rainbow_pinwheels();
    break;
  case LED_EFFECT_RAINBOW_MOVING_CHEVRON:
    effect_rainbow_moving_chevron();
    break;
  case LED_EFFECT_HUE_BREATHING:
    effect_hue_breathing();
    break;
  case LED_EFFECT_HUE_PENDULUM:
    effect_hue_pendulum();
    break;
  case LED_EFFECT_HUE_WAVE:
    effect_hue_wave();
    break;
  case LED_EFFECT_RIVERFLOW:
    effect_riverflow();
    break;
  case LED_EFFECT_SOLID_COLOR:
    effect_solid_color();
    break;
  case LED_EFFECT_ALPHA_MODS:
    effect_alpha_mods();
    break;
  case LED_EFFECT_GRADIENT_UP_DOWN:
    effect_gradient_up_down();
    break;
  case LED_EFFECT_GRADIENT_LEFT_RIGHT:
    effect_gradient_left_right();
    break;
  case LED_EFFECT_BREATHING:
    effect_breathing();
    break;
  case LED_EFFECT_COLORBAND_SAT:
    effect_colorband_sat();
    break;
  case LED_EFFECT_COLORBAND_VAL:
    effect_colorband_val();
    break;
  case LED_EFFECT_COLORBAND_PINWHEEL_SAT:
    effect_colorband_pinwheel_sat();
    break;
  case LED_EFFECT_COLORBAND_PINWHEEL_VAL:
    effect_colorband_pinwheel_val();
    break;
  case LED_EFFECT_COLORBAND_SPIRAL_SAT:
    effect_colorband_spiral_sat();
    break;
  case LED_EFFECT_COLORBAND_SPIRAL_VAL:
    effect_colorband_spiral_val();
    break;
  case LED_EFFECT_CYCLE_ALL:
    effect_cycle_all();
    break;
  case LED_EFFECT_CYCLE_LEFT_RIGHT:
    effect_cycle_left_right();
    break;
  case LED_EFFECT_CYCLE_UP_DOWN:
    effect_cycle_up_down();
    break;
  case LED_EFFECT_CYCLE_OUT_IN:
    effect_cycle_out_in();
    break;
  case LED_EFFECT_DUAL_BEACON:
    effect_dual_beacon();
    break;
  case LED_EFFECT_FLOWER_BLOOMING:
    effect_flower_blooming();
    break;
  case LED_EFFECT_RAINDROPS:
    effect_raindrops();
    break;
  case LED_EFFECT_JELLYBEAN_RAINDROPS:
    effect_jellybean_raindrops();
    break;
  case LED_EFFECT_PIXEL_RAIN:
    effect_pixel_rain();
    break;
  case LED_EFFECT_PIXEL_FLOW:
    effect_pixel_flow();
    break;
  case LED_EFFECT_PIXEL_FRACTAL:
    effect_pixel_fractal();
    break;
  case LED_EFFECT_TYPING_HEATMAP:
    effect_typing_heatmap();
    break;
  case LED_EFFECT_DIGITAL_RAIN:
    effect_digital_rain();
    break;
  case LED_EFFECT_SOLID_REACTIVE_SIMPLE:
    effect_solid_reactive_simple();
    break;
  case LED_EFFECT_SOLID_REACTIVE:
    effect_solid_reactive();
    break;
  case LED_EFFECT_SOLID_REACTIVE_WIDE:
    effect_solid_reactive_wide();
    break;
  case LED_EFFECT_SOLID_REACTIVE_MULTI_WIDE:
    effect_solid_reactive_multi_wide();
    break;
  case LED_EFFECT_SOLID_REACTIVE_CROSS:
    effect_solid_reactive_cross();
    break;
  case LED_EFFECT_SOLID_REACTIVE_MULTI_CROSS:
    effect_solid_reactive_multi_cross();
    break;
  case LED_EFFECT_SOLID_REACTIVE_NEXUS:
    effect_solid_reactive_nexus();
    break;
  case LED_EFFECT_SOLID_REACTIVE_MULTI_NEXUS:
    effect_solid_reactive_multi_nexus();
    break;
  case LED_EFFECT_SPLASH:
    effect_splash();
    break;
  case LED_EFFECT_MULTI_SPLASH:
    effect_multi_splash();
    break;
  case LED_EFFECT_SOLID_SPLASH:
    effect_solid_splash();
    break;
  case LED_EFFECT_SOLID_MULTI_SPLASH:
    effect_solid_multi_splash();
    break;
  case LED_EFFECT_BASS_RIPPLE:
    effect_bass_ripple();
    break;
  case LED_EFFECT_STARLIGHT_SMOOTH:
    effect_starlight_smooth();
    break;
  case LED_EFFECT_STARLIGHT:
    effect_starlight();
    break;
  case LED_EFFECT_STARLIGHT_DUAL_SAT:
    effect_starlight_dual_sat();
    break;
  case LED_EFFECT_STARLIGHT_DUAL_HUE:
    effect_starlight_dual_hue();
    break;
  default:
    break;
  }
  effect_render_context = false;

  if (initialized && display_enabled) {
    update_ws2812();
  }
}

//--------------------------------------------------------------------+
// Public Functions
//--------------------------------------------------------------------+

bool led_matrix_init(void *htim, uint32_t channel) {
  TIM_HandleTypeDef *timer = (TIM_HandleTypeDef *)htim;

  // Initialize WS2812 driver
  if (ws2812_init(&led_ws2812_handle, timer, channel, LED_MATRIX_NUM_LEDS) !=
      WS2812_Ok) {
    return false;
  }

  // Clear pixels
  memset(pixels_static, 0, sizeof(pixels_static));
  memset(pixels_runtime, 0, sizeof(pixels_runtime));
  memset(pixels_output_override, 0, sizeof(pixels_output_override));
  output_override_active = false;

  // Reset brightness
  current_brightness = LED_BRIGHTNESS_DEFAULT;
  display_enabled = true;
  idle_sleep_active = false;
  usb_suspend_active = false;
  idle_timeout_seconds = SETTINGS_DEFAULT_LED_IDLE_TIMEOUT_SECONDS;
  allow_system_indicators_when_disabled =
      SETTINGS_DEFAULT_LED_ALLOW_SYSTEM_WHEN_DISABLED != 0u;
    idle_third_party_stream_counts_as_activity =
      SETTINGS_DEFAULT_LED_IDLE_THIRD_PARTY_STREAM_ACTIVITY != 0u;
  last_activity_ms = HAL_GetTick();
  initialized = true;
  last_sim_tick = 0;
  pixel_batch_depth = 0u;
  pixel_batch_show_pending = false;

  // Clear all LEDs
  zeroLedValues(&led_ws2812_handle);

  return true;
}

void led_matrix_set_pixel(uint8_t x, uint8_t y, uint8_t r, uint8_t g,
                          uint8_t b) {
  if (x >= LED_MATRIX_WIDTH || y >= LED_MATRIX_HEIGHT)
    return;

  uint8_t idx = xy_to_index(x, y);
  led_matrix_set_pixel_idx(idx, r, g, b);
}

void led_matrix_begin_pixel_batch(void) {
  if (pixel_batch_depth == 0u) {
    led_matrix_mark_third_party_stream_activity();
  }
  pixel_batch_depth++;
}

void led_matrix_end_pixel_batch(void) {
  if (pixel_batch_depth == 0u) {
    return;
  }

  pixel_batch_depth--;
  if (pixel_batch_depth == 0u && pixel_batch_show_pending) {
    if (initialized && display_enabled) {
      ws2812_show(&led_ws2812_handle);
    }
    pixel_batch_show_pending = false;
  }
}

void led_matrix_get_pixel(uint8_t x, uint8_t y, uint8_t *r, uint8_t *g,
                          uint8_t *b) {
  if (x >= LED_MATRIX_WIDTH || y >= LED_MATRIX_HEIGHT)
    return;

  uint8_t idx = xy_to_index(x, y);
  if (r)
    *r = pixels_static[idx * 3 + 0];
  if (g)
    *g = pixels_static[idx * 3 + 1];
  if (b)
    *b = pixels_static[idx * 3 + 2];
}

void led_matrix_set_pixel_idx(uint8_t index, uint8_t r, uint8_t g, uint8_t b) {
  if (index >= LED_MATRIX_NUM_LEDS)
    return;

  if (effect_render_context) {
    pixels_runtime[index * 3 + 0] = r;
    pixels_runtime[index * 3 + 1] = g;
    pixels_runtime[index * 3 + 2] = b;
    if (initialized && display_enabled) {
      push_runtime_pixel_to_ws2812(index);
    }
    return;
  }

  if (current_effect == LED_EFFECT_STATIC_MATRIX) {
    // Editable matrix mode: update both saved pattern and displayed frame.
    pixels_static[index * 3 + 0] = r;
    pixels_static[index * 3 + 1] = g;
    pixels_static[index * 3 + 2] = b;
    pixels_runtime[index * 3 + 0] = r;
    pixels_runtime[index * 3 + 1] = g;
    pixels_runtime[index * 3 + 2] = b;
    if (initialized && display_enabled) {
      push_runtime_pixel_to_ws2812(index);
      if (pixel_batch_depth > 0u) {
        pixel_batch_show_pending = true;
      } else {
        ws2812_show(&led_ws2812_handle);
      }
    }
    return;
  }

  if (current_effect == LED_EFFECT_THIRD_PARTY) {
    // Third-party live mode: keep runtime editable externally, do not alter
    // persisted matrix pattern.
    if (pixel_batch_depth == 0u) {
      led_matrix_mark_third_party_stream_activity();
    }
    pixels_runtime[index * 3 + 0] = r;
    pixels_runtime[index * 3 + 1] = g;
    pixels_runtime[index * 3 + 2] = b;
    if (initialized && display_enabled) {
      push_runtime_pixel_to_ws2812(index);
      if (pixel_batch_depth > 0u) {
        pixel_batch_show_pending = true;
      } else {
        ws2812_show(&led_ws2812_handle);
      }
    }
    return;
  }

  // Animated effects: keep saved matrix pattern current, runtime is driven by
  // effect renderer and must not be overwritten here.
  pixels_static[index * 3 + 0] = r;
  pixels_static[index * 3 + 1] = g;
  pixels_static[index * 3 + 2] = b;
}

void led_matrix_clear(void) {
  if (effect_render_context) {
    memset(pixels_runtime, 0, sizeof(pixels_runtime));
    return;
  }

  if (current_effect == LED_EFFECT_STATIC_MATRIX) {
    memset(pixels_static, 0, sizeof(pixels_static));
    memset(pixels_runtime, 0, sizeof(pixels_runtime));
    if (initialized && display_enabled) {
      zeroLedValues(&led_ws2812_handle);
      ws2812_show(&led_ws2812_handle);
    }
    return;
  }

  if (current_effect == LED_EFFECT_THIRD_PARTY) {
    led_matrix_mark_third_party_stream_activity();
    memset(pixels_runtime, 0, sizeof(pixels_runtime));
    if (initialized && display_enabled) {
      zeroLedValues(&led_ws2812_handle);
      ws2812_show(&led_ws2812_handle);
    }
    return;
  }

  memset(pixels_static, 0, sizeof(pixels_static));
}

void led_matrix_fill(uint8_t r, uint8_t g, uint8_t b) {
  bool batch_output = !effect_render_context &&
                      (current_effect == LED_EFFECT_STATIC_MATRIX ||
                       current_effect == LED_EFFECT_THIRD_PARTY);

  if (batch_output) {
    led_matrix_begin_pixel_batch();
  }
  for (uint8_t i = 0; i < LED_MATRIX_NUM_LEDS; i++) {
    led_matrix_set_pixel_idx(i, r, g, b);
  }
  if (batch_output) {
    led_matrix_end_pixel_batch();
  }
}

void led_matrix_set_brightness(uint8_t brightness) {
  current_brightness = brightness;

  // Re-apply brightness to all pixels
  if (initialized) {
    update_ws2812();
  }
}

uint8_t led_matrix_get_brightness(void) { return current_brightness; }

void led_matrix_set_enabled(bool enabled) {
  uint32_t now_ms = HAL_GetTick();

  display_enabled = enabled;
  idle_sleep_active = false;

  if (initialized) {
    if (enabled) {
      last_activity_ms = now_ms;
      update_ws2812();
    } else {
      if (led_matrix_system_overlay_enabled(now_ms)) {
        update_ws2812();
      } else {
        zeroLedValues(&led_ws2812_handle);
        ws2812_show(&led_ws2812_handle);
      }
    }
  }
}

bool led_matrix_is_enabled(void) { return display_enabled; }

void led_matrix_set_idle_timeout_seconds(uint8_t timeout_seconds) {
  idle_timeout_seconds = timeout_seconds;

  if (idle_timeout_seconds == 0u && idle_sleep_active) {
    idle_sleep_active = false;
    if (initialized && display_enabled) {
      update_ws2812();
    }
  } else if (initialized) {
    led_matrix_apply_idle_state(HAL_GetTick());
  }
}

uint8_t led_matrix_get_idle_timeout_seconds(void) { return idle_timeout_seconds; }

void led_matrix_set_allow_system_indicators_when_disabled(bool enabled) {
  allow_system_indicators_when_disabled = enabled;

  if (!initialized) {
    return;
  }

  if (!display_enabled || idle_sleep_active) {
    if (enabled) {
      update_ws2812();
    } else {
      zeroLedValues(&led_ws2812_handle);
      ws2812_show(&led_ws2812_handle);
    }
  }
}

bool led_matrix_is_system_indicators_allowed_when_disabled(void) {
  return allow_system_indicators_when_disabled;
}

void led_matrix_set_idle_third_party_stream_counts_as_activity(bool enabled) {
  idle_third_party_stream_counts_as_activity = enabled;
}

bool led_matrix_is_idle_third_party_stream_counts_as_activity(void) {
  return idle_third_party_stream_counts_as_activity;
}

void led_matrix_set_usb_suspend_state(bool suspended) {
  if (usb_suspend_active == suspended) {
    return;
  }

  usb_suspend_active = suspended;
  if (initialized) {
    update_ws2812();
  }
}

bool led_matrix_is_usb_suspend_active(void) { return usb_suspend_active; }

void led_matrix_notify_user_activity(void) {
  led_matrix_mark_activity(HAL_GetTick());
}

void led_matrix_update(void) { update_ws2812(); }

const uint8_t *led_matrix_get_raw_data(void) { return pixels_runtime; }

void led_matrix_set_raw_data(const uint8_t *data) {
  if (data == NULL)
    return;

  memcpy(pixels_static, data, LED_MATRIX_DATA_SIZE);

  // Only drive runtime directly when matrix mode is active.
  if (current_effect == LED_EFFECT_STATIC_MATRIX) {
    sync_runtime_from_static();
  }
}

led_matrix_data_t led_matrix_get_data(void) {
  led_matrix_data_t data;
  memcpy(data.pixels, pixels_static, LED_MATRIX_DATA_SIZE);
  data.brightness = current_brightness;
  data.enabled = display_enabled ? 1 : 0;
  data.reserved[0] = 0;
  data.reserved[1] = 0;
  return data;
}

void led_matrix_load_data(const led_matrix_data_t *data) {
  if (data == NULL)
    return;

  memcpy(pixels_static, data->pixels, LED_MATRIX_DATA_SIZE);
  current_brightness = data->brightness;
  display_enabled = data->enabled ? true : false;

  if (current_effect == LED_EFFECT_STATIC_MATRIX) {
    memcpy(pixels_runtime, pixels_static, LED_MATRIX_DATA_SIZE);
  }

  if (initialized) {
    if (display_enabled) {
      update_ws2812();
    } else {
      zeroLedValues(&led_ws2812_handle);
      ws2812_show(&led_ws2812_handle);
    }
  }
}

void led_matrix_hsv_to_rgb(uint8_t h, uint8_t s, uint8_t v, uint8_t *r,
                           uint8_t *g, uint8_t *b) {
  uint8_t region, remainder, p, q, t;

  if (s == 0) {
    *r = *g = *b = v;
    return;
  }

  region = h / 43;
  remainder = (h - (region * 43)) * 6;

  p = (v * (255 - s)) >> 8;
  q = (v * (255 - ((s * remainder) >> 8))) >> 8;
  t = (v * (255 - ((s * (255 - remainder)) >> 8))) >> 8;

  switch (region) {
  case 0:
    *r = v;
    *g = t;
    *b = p;
    break;
  case 1:
    *r = q;
    *g = v;
    *b = p;
    break;
  case 2:
    *r = p;
    *g = v;
    *b = t;
    break;
  case 3:
    *r = p;
    *g = q;
    *b = v;
    break;
  case 4:
    *r = t;
    *g = p;
    *b = v;
    break;
  default:
    *r = v;
    *g = p;
    *b = q;
    break;
  }
}

static void led_matrix_rgb_to_hsv(uint8_t r, uint8_t g, uint8_t b, uint8_t *h,
                                  uint8_t *s, uint8_t *v) {
  uint8_t rgb_min = r;
  uint8_t rgb_max = r;

  if (g < rgb_min) {
    rgb_min = g;
  }
  if (b < rgb_min) {
    rgb_min = b;
  }
  if (g > rgb_max) {
    rgb_max = g;
  }
  if (b > rgb_max) {
    rgb_max = b;
  }

  *v = rgb_max;

  {
    uint8_t delta = rgb_max - rgb_min;
    if (rgb_max == 0u || delta == 0u) {
      *h = 0u;
      *s = 0u;
      return;
    }

    *s = (uint8_t)(((uint16_t)delta * 255u) / rgb_max);

    {
      int16_t hue;
      if (rgb_max == r) {
        hue = (int16_t)(((int16_t)(g - b) * 43) / delta);
      } else if (rgb_max == g) {
        hue = (int16_t)(85 + (((int16_t)(b - r) * 43) / delta));
      } else {
        hue = (int16_t)(171 + (((int16_t)(r - g) * 43) / delta));
      }

      if (hue < 0) {
        hue += 255;
      } else if (hue > 255) {
        hue -= 255;
      }

      *h = (uint8_t)hue;
    }
  }
}

void led_matrix_test_rainbow(uint8_t offset) {
  for (uint8_t i = 0; i < LED_MATRIX_NUM_LEDS; i++) {
    uint8_t hue = offset + (uint8_t)(i * 3u);
    uint8_t r, g, b;
    led_matrix_hsv_to_rgb(hue, 255, 255, &r, &g, &b);
    led_matrix_set_pixel_idx(i, r, g, b);
  }
}

//--------------------------------------------------------------------+
// LED Effect Implementation
//--------------------------------------------------------------------+

void led_matrix_set_effect(led_effect_mode_t mode) {
  if (mode == current_effect) {
    return;
  }

  led_effect_mode_t previous_effect = current_effect;
  current_effect = mode;
  effect_generation++;
  effect_offset = 0;
  last_effect_tick = 0;
  last_render_tick = 0;
  last_sim_tick = 0;
  memset(reactive_waves, 0, sizeof(reactive_waves));
  memset(reactive_heat_energy, 0, sizeof(reactive_heat_energy));
  memset(reactive_ghost_energy, 0, sizeof(reactive_ghost_energy));
  memset(mxfx_typing_heat_energy, 0, sizeof(mxfx_typing_heat_energy));
  mxfx_typing_heat_decay_timer_ms = 0u;
  memset(&mxfx_last_hit_tracker, 0, sizeof(mxfx_last_hit_tracker));
  impact_boost = 0u;

  // Restoring matrix mode must restore the exact saved pattern.
  if (mode == LED_EFFECT_STATIC_MATRIX && previous_effect != LED_EFFECT_STATIC_MATRIX) {
    sync_runtime_from_static();
    return;
  }

  if (initialized && display_enabled && mode != LED_EFFECT_THIRD_PARTY &&
      mode != LED_EFFECT_STATIC_MATRIX) {
    render_current_effect_frame();
  }
}

led_effect_mode_t led_matrix_get_effect(void) { return current_effect; }

uint32_t led_matrix_get_effect_generation(void) { return effect_generation; }

void led_matrix_set_effect_color(uint8_t r, uint8_t g, uint8_t b) {
  if (LED_EFFECT_PARAM_COUNT <= LED_EFFECT_PARAM_COLOR_B) {
    return;
  }

  effect_params[LED_EFFECT_PARAM_COLOR_R] = r;
  effect_params[LED_EFFECT_PARAM_COLOR_G] = g;
  effect_params[LED_EFFECT_PARAM_COLOR_B] = b;
}

void led_matrix_set_effect_params(const uint8_t *params) {
  if (params == NULL) {
    return;
  }

  memcpy(effect_params, params, LED_EFFECT_PARAM_COUNT);
}

void led_matrix_get_effect_params(uint8_t *params) {
  if (params == NULL) {
    return;
  }

  memcpy(params, effect_params, LED_EFFECT_PARAM_COUNT);
}

void led_matrix_set_effect_speed(uint8_t speed) {
  effect_params[LED_EFFECT_PARAM_SPEED] = speed > 0u ? speed : 1u;
}

uint8_t led_matrix_get_effect_speed(void) {
  return effect_animation_speed();
}

void led_matrix_set_fps_limit(uint8_t fps) { fps_limit = fps; }

uint8_t led_matrix_get_fps_limit(void) { return fps_limit; }

void led_matrix_set_diagnostic_mode(uint8_t mode) {
  (void)mode;
}

uint8_t led_matrix_get_diagnostic_mode(void) { return 0u; }

void led_matrix_key_event(uint8_t key_index, bool pressed) {
  if (key_index >= NUM_KEYS)
    return;
  if (!pressed) {
    return;
  }

  led_matrix_mark_activity(HAL_GetTick());

  mxfx_reactive_record_hit(key_index);

  uint8_t anchor_hue = 0u;
  uint8_t ignored_sat = 0u;
  uint8_t ignored_value = 0u;
  uint8_t x_bias = scale_coord_to_u8(led_pos_x[key_index], LED_LAYOUT_MAX_X);
  uint8_t y_bias = scale_coord_to_u8(led_pos_y[key_index], LED_LAYOUT_MAX_Y);
  uint8_t color_r = 255u;
  uint8_t color_g = 0u;
  uint8_t color_b = 0u;
  uint8_t slot = 0xFFu;
  bool random_wave_hue = false;

  effect_primary_color(255u, 0u, 0u, &color_r, &color_g, &color_b);
  led_matrix_rgb_to_hsv(color_r, color_g, color_b, &anchor_hue, &ignored_sat,
                        &ignored_value);

  switch (current_effect) {
  case LED_EFFECT_SOLID_SPLASH:
  case LED_EFFECT_SOLID_MULTI_SPLASH:
    random_wave_hue = effect_param_flag(0u, false);
    break;
  case LED_EFFECT_SPLASH:
  case LED_EFFECT_MULTI_SPLASH:
    random_wave_hue = effect_param_flag(7u, false);
    break;
  default:
    break;
  }

  for (uint8_t i = 0u; i < REACTIVE_WAVE_POOL_SIZE; i++) {
    if (!reactive_waves[i].active) {
      slot = i;
      break;
    }
  }
  if (slot == 0xFFu) {
    /* Pool is full.  Prefer evicting the oldest wave from the SAME source key
     * so that spamming one key produces overlapping rings that all stay visible,
     * rather than the latest press silently clobbering an unrelated wave. */
    uint16_t oldest_same_age = 0u;
    for (uint8_t i = 0u; i < REACTIVE_WAVE_POOL_SIZE; i++) {
      if (reactive_waves[i].source_key == key_index &&
          reactive_waves[i].age_ms >= oldest_same_age) {
        oldest_same_age = reactive_waves[i].age_ms;
        slot = i;
      }
    }
    /* No same-key wave found — fall back to evicting the globally oldest. */
    if (slot == 0xFFu) {
      uint16_t oldest_age = 0u;
      for (uint8_t i = 0u; i < REACTIVE_WAVE_POOL_SIZE; i++) {
        if (reactive_waves[i].age_ms >= oldest_age) {
          oldest_age = reactive_waves[i].age_ms;
          slot = i;
        }
      }
    }
  }

  reactive_waves[slot].active = true;
  reactive_waves[slot].source_key = key_index;
  if (random_wave_hue) {
    uint32_t hue_seed = HAL_GetTick();
    hue_seed ^= (uint32_t)(key_index + 1u) * 0x9E3779B9u;
    hue_seed ^= (uint32_t)(slot + 1u) * 0x85EBCA6Bu;
    hue_seed ^= hue_seed >> 15;
    hue_seed *= 0x2C1B3C6Du;
    hue_seed ^= hue_seed >> 12;
    reactive_waves[slot].hue = (uint8_t)hue_seed;
  } else {
    reactive_waves[slot].hue =
        (uint8_t)(anchor_hue + (x_bias / 7u) + (y_bias / 11u));
  }
  reactive_waves[slot].energy = 255u;
  reactive_waves[slot].age_ms = 0u;

  if (current_effect == LED_EFFECT_TYPING_HEATMAP) {
    uint8_t origin_x = mxfx_led_coord_x(key_index);
    uint8_t origin_y = mxfx_led_coord_y(key_index);

    // param 0 (heat_gain=224): energy per keypress. 1+(gain>>3) -> at 224 ~=29 (near original 32).
    uint8_t gain_energy = (uint8_t)(1u + (effect_param(0, 224u) >> 3u));
    // param 2 (diffusion=88): max neighbor spread amount 0..16. At 255 -> 16 (original).
    uint8_t max_spread = (uint8_t)(((uint16_t)effect_param(2, 88u) * 16u) / 255u);

    mxfx_typing_heat_energy[key_index] =
        mxfx_qadd8(mxfx_typing_heat_energy[key_index], gain_energy);

    for (uint8_t j = 0u; j < NUM_KEYS; j++) {
      if (j == key_index) {
        continue;
      }

      {
        int16_t dx = (int16_t)origin_x - (int16_t)mxfx_led_coord_x(j);
        int16_t dy = (int16_t)origin_y - (int16_t)mxfx_led_coord_y(j);
        uint8_t distance = mxfx_distance_u8(dx, dy);

        if (distance <= 40u && max_spread > 0u) {
          uint8_t amount = (uint8_t)(40u - distance);
          if (amount > max_spread) {
            amount = max_spread;
          }
          mxfx_typing_heat_energy[j] =
              mxfx_qadd8(mxfx_typing_heat_energy[j], amount);
        }
      }
    }
  }

  {
    uint16_t heat = (uint16_t)(reactive_heat_energy[key_index] + 320u);
    reactive_heat_energy[key_index] = (heat > 1024u) ? 1024u : heat;

    /* Heatmap-style keypress spread: add proportional energy to nearby keys at
     * press time rather than diffusing during rendering.  This gives the
     * sharp, localised spread seen in typing_heatmap.
     * HEATMAP_SPREAD_DIST: max spread radius in 0.1 mm units (~52 mm). */
    if (current_effect == LED_EFFECT_TYPING_HEATMAP) {
      /* Spread radius ~52 mm and max bleed energy at distance=0 */
      const uint16_t spread_dist   = 520u;
      const uint16_t spread_energy = 192u;
      for (uint8_t j = 0u; j < NUM_KEYS; j++) {
        if (j == key_index) {
          continue;
        }
        uint16_t dist = led_layout_distance(key_index, j);
        if (dist < spread_dist) {
          uint16_t falloff = (uint16_t)(((uint32_t)spread_energy *
                                         (spread_dist - dist)) /
                                        spread_dist);
          uint16_t new_heat = reactive_heat_energy[j] + falloff;
          reactive_heat_energy[j] = (new_heat > 1024u) ? 1024u : new_heat;
        }
      }
    }
  }
  {
    uint16_t ghost = (uint16_t)(reactive_ghost_energy[key_index] + 720u);
    reactive_ghost_energy[key_index] = (ghost > 2048u) ? 2048u : ghost;
  }

  impact_boost = (impact_boost > 820u) ? 1024u : (uint16_t)(impact_boost + 204u);
}

static void reactive_tick_simulation(uint16_t delta_ms) {
  uint32_t now_ms = HAL_GetTick();

  if (delta_ms == 0u) {
    return;
  }
  if (delta_ms > 180u) {
    delta_ms = 180u;
  }

  mxfx_reactive_tick_hits(delta_ms);

  if (audio_spectrum_valid &&
      (uint32_t)(now_ms - audio_spectrum_refresh_ms) > AUDIO_SPECTRUM_STALE_MS) {
    audio_spectrum_valid = false;
    memset(audio_spectrum_levels, 0, sizeof(audio_spectrum_levels));
    audio_impact_level = 0u;
  }

  if (audio_spectrum_valid) {
    uint16_t boosted = (uint16_t)audio_impact_level * 3u;
    if (boosted > impact_boost) {
      impact_boost = (uint16_t)((impact_boost + boosted) / 2u);
    }
  }

  if (impact_boost > 0u) {
    uint16_t decay = (uint16_t)(1u + (delta_ms * 3u) / 10u);
    impact_boost = (impact_boost > decay) ? (uint16_t)(impact_boost - decay) : 0u;
  }

  for (uint8_t i = 0u; i < REACTIVE_WAVE_POOL_SIZE; i++) {
    reactive_wave_t *wave = &reactive_waves[i];
    uint32_t next_age;

    if (!wave->active) {
      continue;
    }

    next_age = (uint32_t)wave->age_ms + delta_ms;
    if (next_age >= 1600u) {
      wave->active = false;
      wave->energy = 0u;
      wave->age_ms = 0u;
      continue;
    }

    wave->age_ms = (uint16_t)next_age;
    wave->energy = (uint8_t)(((1600u - next_age) * 255u) / 1600u);
  }

  for (uint8_t key = 0u; key < NUM_KEYS; key++) {
    if (reactive_heat_energy[key] > 0u) {
      uint16_t heat_decay = (uint16_t)(1u + (delta_ms * 5u) / 6u);
      reactive_heat_energy[key] =
          (reactive_heat_energy[key] > heat_decay)
              ? (uint16_t)(reactive_heat_energy[key] - heat_decay)
              : 0u;
    }

    if (reactive_ghost_energy[key] > 0u) {
      uint16_t ghost_decay;
      if (current_effect == LED_EFFECT_REACTIVE_GHOST) {
        uint8_t trail_hold = effect_param(2, 184u);
        uint8_t decay_scale =
            (uint8_t)(14u - ((uint16_t)trail_hold * 12u) / 255u);
        ghost_decay =
            (uint16_t)(1u + ((uint32_t)delta_ms * decay_scale) / 64u);
      } else {
        ghost_decay = (uint16_t)(1u + (delta_ms * 7u) / 8u);
      }
      reactive_ghost_energy[key] =
          (reactive_ghost_energy[key] > ghost_decay)
              ? (uint16_t)(reactive_ghost_energy[key] - ghost_decay)
              : 0u;
    }
  }
}

static void led_matrix_mark_activity(uint32_t now_ms) {
  last_activity_ms = now_ms;

  if (idle_sleep_active) {
    idle_sleep_active = false;
    if (initialized && display_enabled) {
      update_ws2812();
    }
  }
}

static void led_matrix_mark_third_party_stream_activity(void) {
  if (idle_third_party_stream_counts_as_activity &&
      current_effect == LED_EFFECT_THIRD_PARTY) {
    led_matrix_mark_activity(HAL_GetTick());
  }
}

static void led_matrix_apply_idle_state(uint32_t now_ms) {
  uint32_t idle_timeout_ms = 0u;

  if (!display_enabled) {
    idle_sleep_active = false;
    return;
  }

  if (idle_timeout_seconds == 0u) {
    if (idle_sleep_active) {
      idle_sleep_active = false;
      if (initialized) {
        update_ws2812();
      }
    }
    return;
  }

  idle_timeout_ms = (uint32_t)idle_timeout_seconds * 1000u;
  if (!idle_sleep_active &&
      (uint32_t)(now_ms - last_activity_ms) >= idle_timeout_ms) {
    idle_sleep_active = true;
    if (initialized) {
      if (led_matrix_system_overlay_enabled(now_ms)) {
        update_ws2812();
      } else {
        zeroLedValues(&led_ws2812_handle);
        ws2812_show(&led_ws2812_handle);
      }
    }
  }
}
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
