Fefe-Nayz/kbhe-monorepo/(commit log)

2025-12-25 feat: dma scan
2025-12-26 feat: working dma
2025-12-27 tinyusb init
    [adc_key_1_3cycle_12bits_500ns_100nF-10uF.csv, adc_key_1_3cycle_12bits_500ns_100nF-10uF_2.csv, adc_key_1_3cycle_12bits_500ns_100nF-10uF_without_usb.csv, adc_key_1_3cycle_12bits_500ns_100nF_2.csv, adc_key_1_3cycles_12bits_500ns_100nF.csv, adc_key_1_teensy.csv, adc_key_2_3cycle_12bits_500ns_0F_without_usb.csv, adc_key_2_3cycle_12bits_500ns_0F_without_usb_2.csv]
2025-12-28 feat: usb working
    [adc_key_1_3cycle_12bit_500ns.csv, adc_key_1_3cycle_12bits_500ns_100nF-10uF.csv, adc_key_1_3cycle_12bits_500ns_100nF-10uF_2.csv, adc_key_1_3cycle_12bits_500ns_100nF-10uF_without_usb.csv, adc_key_1_3cycle_12bits_500ns_100nF_2.csv, adc_key_1_3cycles_12bits_500ns_100nF.csv, adc_key_1_teensy.csv, adc_key_2_3cycle_12bits_500ns_0F_without_usb.csv]
2025-12-28 feat: usb + dma working
2025-12-29 fix: improve performance by enabling instruction caches
    [kbhe.ioc, main.c]
2025-12-29 tah la mise a jour vlah huge cok
2025-12-30 feat: add data cache & mpu for dma
2025-12-30 fix: bad led data pin & bad mpu config & bad led init
    [kbhe.ioc, main.c, main.h]
2025-12-31 Add LED FPS limit, diagnostic modes, and ADC filter control
    Introduces new HID protocol commands and settings for LED FPS limiting, diagnostic modes for LED/ADC troubleshooting, and runtime ADC EMA filter control (enable/disable and parameter adjustment). Updates firmware, settings struct, and Python host tool to support these features, including GUI controls for filter and diagnostic options.
2026-01-01 fix: make filtering in main loop
    [main.c]
2026-01-12 fix: led effect settings now saved, no more settings save failed message
    [hid_protocol.c, settings.c, settings.h]
2026-01-12 Refactor formatting and comments in header and source files
    Improved code readability by adjusting comment formatting, function signatures, and code alignment in hid_protocol.h, main.h, and led_matrix.c. No functional changes were made; modifications are limited to whitespace, comment wrapping, and header include order.
2026-01-30 Added button groups and slider to calibration page
2026-01-31 Started implementing keyboard keys selection and installed zustand to reuse baseKeyboard on any page with the current layout
2026-02-01 Just displayed the devices informations and handle multiple device showed
2026-02-01 Just displayed the devices informations and handle multiple device showed v2
2026-02-02 project init
    [75he.kicad_pcb, 75he.kicad_sch, mcu.kicad_sch, mux.kicad_sch, power_supply.kicad_sch, sensors.kicad_sch, switch.kicad_sch]
2026-02-02 start keyboard switch layout
    [75he.kicad_pcb, mux.kicad_sch, switch.kicad_sch]
2026-02-02 final switch layout
    [75he.kicad_pcb, mux.kicad_sch]
2026-02-02 pcb mux placement
    [75he.kicad_pcb]
2026-02-04 add capacitor to mux vcc
    [75he.kicad_pcb, mcu.kicad_sch, mux.kicad_sch]
2026-02-04 start placing mcu capacitor
    [75he.kicad_pcb, 75he.kicad_sch, mcu.kicad_sch, mux.kicad_sch, sensors.kicad_sch]
2026-02-04 start usb
    [75he.kicad_pcb, mcu.kicad_sch]
2026-02-04 start analog ldo layout
    [75he.kicad_pcb, mcu.kicad_sch, power_supply.kicad_sch]
2026-02-04 start placing sensors
    [75he.kicad_pcb]
2026-02-05 place sensors
    [75he.kicad_pcb]
2026-02-05 fix usb data line and add dfu and mux usb
    [75he.kicad_pcb, mcu.kicad_sch]
2026-02-05 add fuse & continue usb
    [75he.kicad_pcb, mcu.kicad_sch, mux.kicad_sch]
2026-02-06 compute diff pair spacing
    [75he.kicad_sch]
2026-02-07 vdda power supply & sensor decoupling capacitor
    [75he.kicad_pcb, 75he.kicad_sch, mcu.kicad_sch, power_supply.kicad_sch]
2026-02-07 place sensors capacitor
    [75he.kicad_pcb]
2026-02-07 finish sensor out capacitor
    [75he.kicad_pcb, sensors.kicad_sch]
2026-02-07 start sensor out routing
    [75he.kicad_pcb]
2026-02-07 start sensor power rail
    [75he.kicad_pcb]
2026-02-07 continue sensor out
    [75he.kicad_pcb]
2026-02-08 start sensors power rail
    [75he.kicad_pcb]
2026-02-24 continue sensor power supply
    [75he.kicad_pcb]
2026-03-18 added power led, some cleanup/fixes, added doc
    [power_supply.kicad_sch]
2026-03-19 fixes & doc
    [75he.kicad_sch, led.kicad_sch, mcu.kicad_sch, power_supply.kicad_sch]
2026-03-19 Add rotary encoder symbol;
    [75he.kicad_sch, mcu.kicad_sch]
2026-03-19 adjust schematic text
    [mcu.kicad_sch]
2026-03-19 encodeur ajouté
    [mcu.kicad_sch, sensors.kicad_sch]
2026-03-19 Add WS2812 footprints, resistors and net names
    Replace generic switch footprints with proper SMD components and metadata: add WS2812B RGB LED footprints (with pads, nets, 3D models and part/Datasheet/LCSC info), add many resistor footprints and detailed properties, and update net names for LED data lines (e.g. Net-(D201-DIN/DOUT) etc.). Also adjust footprint positions, pad assignments, sheet references (LED/HE Sensors), and footprint drawing/printer layers to match correct component geometry for assembly and BOM generation.
    [led.kicad_sch, mcu.kicad_sch, power_supply.kicad_sch]
2026-03-19 Update 0402 resistors to 680Ω and add libs
    [led.kicad_sch, mcu.kicad_sch, mux.kicad_sch, power_supply.kicad_sch, sensors.kicad_sch, switch.kicad_sch]
2026-03-19 clean schematics
    [mcu.kicad_sch, power_supply.kicad_sch, sensors.kicad_sch, switch.kicad_sch]
2026-03-19 clean PCB
    [mcu.kicad_sch]
2026-03-19 mux placement
    [75he.kicad_pcb, 75he.kicad_sch, mcu.kicad_sch, screws.kicad_sch]
2026-03-19 mux placement & mcu placement
    [75he.kicad_pcb]
2026-03-20 fix: add missing 3d models
    [75he.kicad_pcb, mcu.kicad_sch, mux.kicad_sch]
2026-03-20 sensors placements
    [75he.kicad_pcb]
2026-03-20 mcu capacitor, usb port, ldo
    [75he.kicad_pcb, mcu.kicad_sch, power_supply.kicad_sch]
2026-03-20 mounting hole
    [screws.kicad_sch]
2026-03-20 usb diff pair
    [75he.kicad_sch]
2026-03-21 Placed led
    [75he.kicad_sch, led.kicad_sch, mcu.kicad_sch, mux.kicad_sch, power_supply.kicad_sch, screws.kicad_sch, sensors.kicad_sch, switch.kicad_sch]
2026-03-21 Adjust PCB component positions and add backup
    Modify 75he.kicad_pcb: update (at ...) coordinates for many footprints (primarily PCM_JLCPCB:C_0402 capacitors and several Connector_Wire pads), and refresh a few footprint UUIDs used for silkscreen/fab items. Also add a new backup archive 75he-backups/75he-2026-03-21_162302.zip. These changes reflect component placement/origin adjustments and UUID updates.
2026-03-21 Update switch footprints: version & 3D models
    Bump footprint metadata and standardize footprints for various switch sizes. Updated (version) and (generator_version) to 20260206 / 10.0, refreshed UUIDs, and set duplicate_pad_numbers_are_jumpers to no where applicable. Adjusted Edge.Cuts circle endpoints (small radius adjustments) and added a 3D model reference to Gateron Magnetic Jade Switch.stp (with offset/scale/rotation) for the 1U, 1.25U, 1.75U, 2U, 6.25U and ENTER_ISO footprints. Removed the Switch_1.5U.kicad_mod file.
2026-03-21 fixed led placemeent
2026-03-21 fix: led align
2026-03-21 start led capacitor + sensors out resistor
2026-03-21 fix: sensors bad orders
2026-03-21 fix: sensors bad out label
    [sensors.kicad_sch]
2026-03-21 finish placing sensors out resistors
2026-03-21 finish led capacitor
2026-03-22 revert: revert to finish led capacitor after crash
2026-03-22 led capacitor & sensor capacitor & fixes
    [mcu.kicad_sch, mux.kicad_sch, power_supply.kicad_sch]
2026-03-22 lcsc part
    [mcu.kicad_sch, mux.kicad_sch, power_supply.kicad_sch, sensors.kicad_sch]
2026-03-22 route sensors to mux & data led
    [led.kicad_sch, mux.kicad_sch]
2026-03-22 add jlc drc & route mux select
    [75he.kicad_sch, mux.kicad_sch]
2026-03-24 fix mux
    [mux.kicad_sch]
2026-03-24 replace mux
    [mux.kicad_sch]
2026-03-24 wired new muxes
2026-03-24 gnd & power
2026-03-25 finish power led
2026-03-28 add cahier des charges
2026-03-28 Add KBHE host tools and updater improvements
    Introduce a new kbhe_tool Python package (CLI, device API, firmware helper, GUI and UI pages) to provide interactive and scripted host-side tooling for KBHE devices. Improve the firmware_updater: add pluggable logger callbacks, better progress/retry logging, increased wait timeout for the application, and wire the logger through transact/retry/flash paths. Add documentation to RAW_HID.md showing CLI GUI usage and flashing examples. Harden boot/flash transitions on the device side by clearing interrupt state and restoring core registers before jumping between bootloader and application (new restore_core_state_for_application/restore_core_state_for_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
2026-03-28 Add PySide6 Qt GUI and protocol/device fixes
    Introduce a new PySide6-based GUI (kbhe_tool/qtgui) with app, pages, common widgets, theme and session management, plus keyboard-layout.json. Update cli to launch the new Qt GUI and re-export KBHEConfiguratorApp/LEDMatrixEditor. Extend protocol enums and helpers (many new LED effects, LED_EFFECT_NAMES, GAMEPAD_* maps and name lookups) to support richer effects and user-friendly gamepad mappings. Update device API to accept string names for gamepad axis/direction/button and map them to numeric codes. Fix HID protocol C handlers to initialize option structs from current settings, preserve existing state, and validate/clone current key entries before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
    [calibration_page.py, common.py, debug_page.py, device_page.py]
2026-03-29 Add Travel page and UI improvements
    Introduce a new TravelPage with KeyTravelBar widgets for live key travel visualization, polling, and threshold displays; add MatrixCanvas (8×8) for lighting matrix rendering and replace per-LED QPushButton grid; enhance CalibrationPage with curve presets, live position tracking (QTimer + scatter series), preset sync, and UI/layout refinements; update OverviewPage tiles to use framed status tiles with StatusChip and auto-refreshing snapshot; make StatusChip custom-painted for reliable pill styling and theme handling; add EffectsPage button group and adjust swatch sizing; improve GamepadPage distance bar layout and theme application; tweak DevicePage handle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
    [calibration_page.py, device_page.py, effects_page.py, gamepad_page.py, lighting_page.py]
2026-03-29 Improve device reconnection and session refresh
    Ensure HID handles are fully released and add robust reconnect behavior: connect() now calls disconnect() first, a reconnect() helper was added, and disconnect() ignores close() errors (device.py). GUI refresh routines skip page reloads when the session is not connected to avoid spurious updates (qtgui/app.py). Session snapshot logic was centralized into _collect_snapshot(), which treats a full set of empty responses as a transport failure; refresh_snapshot() now attempts one reconnect before reporting failure and uses _set_connection() to update/emit connection state (qtgui/session.py). These changes improve recovery from unplug/replug scenari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
2026-03-29 Split LED matrix static/runtime + live UI
    Refactor LED matrix internals to separate a persisted, software-editable matrix (pixels_static) from the runtime frame (pixels_runtime) used for effects and third-party/live control. Add LED_EFFECT_THIRD_PARTY and a LED_EFFECT_STATIC_MATRIX alias, introduce effect_render_context, diagnostic flags and reactive state, and ensure effect renderers write to the runtime buffer while preserving the saved static pattern. led_matrix_get_raw_data now returns the runtime frame; led_matrix_set_raw_data and load/save operate on the persisted static pattern. Update hid_protocol to fetch LED data via led_matrix_get_raw_data and adjust pixel set/clear/update behavio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
2026-03-29 Wave reactive LEDs; add SignalRGB plugin
    Replace per-key brightness with a wave-based reactive model in led_matrix.c: introduce key_wave_energy and key_wave_radius, a key->LED mapping table, an abs_u8_diff helper, and rewrite effect_reactive to render expanding core+ring waves and decay/advance energy and radius. Update led_matrix_key_event to trigger waves. Add a SignalRGB plugin and README (signalrgb/kbhe_6key_rawhid.js, signalrgb/README.md) for the KBHE 6-key prototype that enables third-party mode, streams 64-LED frames in chunks, and maps the six logical keys to firmware LED indices.
    [led_matrix.c]
2026-03-29 Add distance-sensor LED effect
    Introduce a new per-key LED effect driven by sensor travel distance (LED_EFFECT_DISTANCE_SENSOR = 15). Implement effect_distance_sensor() in led_matrix.c (adds KEY_TRAVEL_MAX_01MM, includes trigger.h, maps triggerGetDistance01mm() 0–4.00mm to hue/value and sets per-key RGB). Register the effect in led_matrix_effect_tick and expose the new enum/name in kbhe_tool protocol and GUI (effects_page and UI metadata) so the app can select and describe the Sensor Distance effect.
2026-03-30 feat: add adc capture tool
    [key2_20s.csv]
2026-04-04 refactor: calibration
2026-04-05 refactor: filter
2026-04-06 refactor: analog filter offset
2026-04-08 fix: set min calibration
    [board_config.h, calibration.c, main.c]
2026-04-08 fix: pin config
2026-04-08 Add app-only build and raw ADC inspection
2026-04-08 Clean up LED bring-up and defaults
2026-04-08 Full-key LED mapping and effects
2026-04-08 Add chunked HID and variable key support
    Introduce chunked HID packets and generalize firmware for a variable number of keys (NUM_KEYS). Key settings, calibration values, key states and LED data now use chunked transfer structs and sizes; hid_keycode widened to uint16_t to support custom codes. Settings were expanded to store per-key data for NUM_KEYS and defaults are derived from the layout at runtime. Trigger subsystem gained APIs to apply/reload per-key settings and to report distances in 0.01mm units. HID handlers, ADC capture, layout, and settings were updated to use NUM_KEYS and chunked semantics. Tooling (kbhe_tool) and README were updated to support the new protocols and LED chunking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
2026-04-08 Checkpoint 82-key fixes before DMA rework
    [analog.c, analog.h, debug_page.py, effects_page.py, filter.c, filter.h, firmware_updater.py]
2026-04-08 feat: new lut
    [20260408_231954_mesurepcbninokey1piedacoulissealamano.csv, 20260409_001242_validation_report_errors.csv]
2026-04-09 Add consumer HID, rotary encoder and calibration
    Introduce consumer control HID support and a rotary encoder driver, plus guided/max calibration and normalized distance handling. Adds consumer_hid interface and implementation, exposes new HID protocol commands for per-key max calibration and guided calibration flow, and integrates guided calibration state into the analog calibration subsystem. Computes normalized per-key travel (0-255) and uses it in LED effects; adds host-driven volume overlay and host volume caching to the LED matrix. Updates CMake, USB/TUSB descriptors and settings to include new features, wires rotary encoder into main loop and GPIO init, and updates tooling/GUI with rel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
2026-04-09 Fix WS2812 TIM2 DMA backend
    [color_values.c, color_values.h, main.c, ws2812.c, ws2812.h]
2026-04-09 Add rotary encoder settings, UI, and effects
    Introduce full rotary encoder configuration and tooling: add settings structures and APIs, protocol commands (GET/SET_ROTARY_ENCODER_SETTINGS), and HID consumer mute. Implement runtime handling in firmware (rotary actions, button actions, RGB customizer, sensitivity/inversion) and persist sanitized settings. Refactor LED matrix reactive effect with improved color math, wave lifetime, mixing and performance helpers. Update host tools: protocol enums, kbhe_tool device methods, and a new Rotary Encoder page in the Qt GUI. Also bump firmware version to 1.4.0 and switch compile_commands to Debug for clangd/VSCode.
2026-04-09 Add SOCD resolution, rotary progress & HID queue
    Introduce SOCD resolution support and rotary encoder progress styling, plus a consumer HID report queue and settings migration.
    Key changes:
    - Bump settings/firmware versions and extend settings_t with a rotary encoder block (step_size, progress style/effect/color) and SOCD resolution enum/accessors.
    - Extend HID protocol structs to include socd_resolution and rotary progress fields; validate and expose these via HID commands.
    - Implement migration from previous settings layout (v11) into the new v12 format when loading from flash.
    - Add sanitization for per-key SOCD pairing/resolution and call socd_load_settings on key updates.
    - Implement a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
2026-04-09 Add restore LED-effect command and demo device
    Introduce CMD_RESTORE_LED_EFFECT_BEFORE_THIRD_PARTY (0x7B) to allow firmware to restore the LED effect that was active before a third-party live override. Wire the new command into hid_protocol (handler and dispatch). Add settings API and implementation to remember the pre-third-party effect and restore it (settings_restore_led_effect_before_third_party), with logic to track validity when entering/exiting third-party mode. Update SignalRGB plugin and JS glue to call the new command on shutdown instead of forcing matrix mode. Add a full DemoDevice implementation for kbhe_tool to enable a --demo CLI option and to drive the GUI/screenshot harness w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
2026-04-09 Add LED output override and 82-key SignalRGB
    Introduce a high-priority LED output override and runtime state reset hooks, and expand the SignalRGB plugin to the full 82-key layout.
    Changes include:
    - led_matrix: add an output-override pixel buffer and API (set/clear) and prefer the override frame when active; initialize/clear override on init and update display immediately when changed.
    - analog/calibration: use the new output-override for guided calibration frames, restore runtime LED state via clearing the override, and expose calibration_guided_is_active().
    - hid/layout: add keyboard_hid_reset_state() and layout_reset_state() to clear internal bookkeeping without sending reports.
    - trigg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
    [calibration.c, calibration.h, led_matrix.c]
2026-04-10 Add mouse, diagnostics, and advanced gamepad features
    Introduce mouse HID and diagnostics subsystems and extend gamepad/trigger/settings functionality. Added new headers and implementations for mouse_hid and diagnostics, integrated diagnostics-driven profiling into analog sampling, and added syscalls.c -fno-lto compile option to avoid LTO linker issues. Expanded settings and HID protocol to support per-key advanced behaviors (tap/hold/toggle/dynamic zones), gamepad curve points, keyboard-routing options, and updated default gamepad curve. Reworked gamepad HID report format and logic (axis/button composition, deadzone/shape handling, reactive stick), updated USB descriptors and TinyUSB config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
    [analog.c, calibration.c, calibration_page.py, debug_page.py, diagnostics.c]
2026-04-10 Add XInput USB backend and gamepad API
    Introduce an XInput-compatible USB driver and selectable gamepad API. Adds new hid/xinput_usb.{h,c} and registers the driver in CMake and TinyUSB descriptors; updates main loop to initialize and poll the XInput task. Extend settings to include gamepad API mode and an advanced tick rate with migration and validation (settings version bump and migration logic). Refactor gamepad HID code to build normalized HID and XInput reports from the canonical gamepad_report_t, add endpoint/descriptor constants, and add HID protocol commands for USB re-enumeration and tick-rate get/set. Also updates USB descriptor indices, tinyusb config comments, and tooling/GUI adju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
2026-04-10 Add layered keymaps and custom gamepad support
    Introduce persistent overlay layers and runtime gamepad controls: bump settings version and add SETTINGS_LAYER_COUNT, store per-layer keymaps in settings, provide getters/setters and migration/default logic. Add new custom keycodes for layer control, LED and gamepad actions. Extend layout to support multiple active layers, layer hold/toggle/set semantics, internal key handling (LED, layer, gamepad), and host/gamepad dispatching with pressed-key tracking. Add HID protocol commands/packet (CMD_GET_LAYER_KEYCODE / CMD_SET_LAYER_KEYCODE) to read/write layer keycodes over the protocol. Implement custom gamepad button/axis press/release and integratio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
2026-04-10 Expose MCU metrics and LED effect color
    Add runtime MCU telemetry and LED-effect color support across firmware and tooling.
    Firmware:
    - HID protocol: add CMD_GET_LED_EFFECT_COLOR and CMD_GET_MCU_METRICS and a packed hid_resp_mcu_metrics_t response struct; implement handlers to return persisted LED effect color and live MCU metrics.
    - Runtime metrics: sample internal VREF/temperature via injected ADC, compute smoothed scan/work timings and load (permille), store live values (mcu_*_live), and sample at ~1s when diagnostics perf is active.
    - LED: switch pixel source for get_pixel to led_matrix_get_raw_data(), add led_matrix_nudge_host_volume_overlay() and constant HOST_VOLUME_STEP_ESTIMATE to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
2026-04-11 Append-only flash storage and autosave settings
    Introduce an append-only flash storage format with record headers, CRC32, sequence numbers and legacy raw layout detection; implement scanning, aligned writes, and consolidation via sector erase. Replace immediate erase-on-save with flash_storage_write that appends snapshots.
    Add a deferred autosave system in settings: mark-dirty on live changes, a change counter, settings_task(now_ms) to service delayed saves after a short idle (SETTINGS_AUTOSAVE_DELAY_MS), and settings_has_unsaved_changes(). Call settings_task from main loop. Update settings_save to write snapshots via the new storage API and to clear dirty state.
    Update many settings sette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
    [calibration_page.py, device_page.py, effects_page.py, flash_storage.c, flash_storage.h, gamepad_page.py]
2026-04-11 Add KBHE HID transport and keyboard preview
    Implement KBHE HID support in the Tauri backend and add a modern keyboard preview system in the frontend.
    - Add comprehensive HID management commands (list/connect/disconnect/read/write/flush/wait) with connection state and transport mutex in src-tauri (commands.rs) and register them in lib.rs.
    - Introduce kbhe client library (commander, transport, protocol, device, firmware, index) under src/lib/kbhe to handle packetized commands and queued exchanges.
    - Add KLE-based keyboard layout assets and vendor react-kle-modern components for rendering the keyboard (src/assets/layouts, src/lib/vendor/react-kle-modern).
    - Refactor defaultLayout to a modern b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
2026-04-11 Add AppShell, new pages, query client & deps
    Introduce a new app shell and many UI components/pages as part of a large refactor. Added AppShell, shared UI components (KeyboardPreviewCard, LayerSelector, LiveStatusChip, PageLayout, SectionCard), autosave/device banners, a UI store, kbhe session lib, and React Query helpers (keys, queryClient). Several new pages were added (Dashboard, Device, Keymap, Lighting, Performance, Profiles, Calibration, AdvancedKeys, Diagnostics, Gamepad, Rotary) and legacy/renamed page files removed. Updated App.tsx, app-sidebar and utils to integrate the new layout. package.json was modified and a package-lock.json was added; src-tauri/tauri.conf.json was also updat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
2026-04-11 Add UI color picker and live update handlers
    Introduce a new color picker UI (src/components/ui/color-picker.tsx) and migrate the existing ColorPicker to use it. Add live-preview support via onLiveChange to AnalogCurveEditor, DistanceSlider and the CommitSlider implementation so adjustments can be previewed in real time while commits are throttled/committed with a short timeout to avoid UI flashing. Add a use-throttled-call hook and tighten types for use-optimistic-mutation. Update pages and components to wire up the new behavior and add required dependencies/types (color, lucide-react, @types/color). These changes improve UX for live device previews and stabilize optimistic/committed value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
2026-04-12 Support OS keycap legends and keycode icons
    Add OS-specific key legend extraction and UI support for per-key legend slots and icon overrides. On Windows, implement kbhe_get_os_key_variants using ToUnicodeEx and expose it as a Tauri command (with required Win32 features added to Cargo.toml); non-Windows builds return an empty map. Introduce useOSKeycapLegend and use-keyboard-preview-legends hooks to resolve printable key legends (including shift/alt-gr variants) and fetch device keycodes for preview tiles. Add KeycapButton and keycode-icons for icon overrides, extend react-kle vendor types/components to accept legendSlots, and wire these into KeycodeAccordion, BaseKeyboard, Keymap and Advance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
2026-04-12 Add firmware drag-and-drop & tweak curves
    Add drag-and-drop firmware import (desktop/browser) and improve firmware file UX. Firmware.tsx: integrate Tauri window drag events, implement drag/drop handlers and drop zone ref, parse text/URI drops, accept .bin files, use readFile for local paths, provide visual isDragOver state and error handling, and centralize firmware processing via processSelectedFirmware. Also expose UI changes to show drag hints and replace file via drop. Adjust timeout/retry sliders layout slightly. Analog-curve: flip preset Y coordinates to match the component coordinate system. Several files contain formatting/indentation cleanups (keycap button, keycode icons, hooks, Ad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
2026-04-13 Clear keyboard HID state when disabled
    Prioritize the keyboard master switch and ensure keyboard HID state is cleared when keyboard output is turned off.
    - layout.c: Add an early check so the keyboard master switch always inhibits keyboard emission (returns false if keyboard is disabled) before considering gamepad routing.
    - settings.c: Include keyboard HID headers and, when disabling the keyboard (either via settings_set_keyboard_enabled or by changing options), release all keys and reset keyboard/NKRO state to avoid stale active reports.
    This prevents stuck or stale keyboard reports after toggling keyboard output and makes routing logic deterministic by giving the master switch priority.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
    [settings.c]
2026-04-13 Add loading indicator and OS legend cache
    Show a loading overlay for keyboard preview and centralize OS legend fetching/caching. BaseKeyboard now accepts a loading prop and displays a spinner overlay when ready+loading. use-keyboard-preview-legends returns both keyLegendSlotsMap and isLoading so pages can show the spinner. Updated AdvancedKeys, Keymap, Gamepad and Performance to consume the new isLoading and pass it into BaseKeyboard. Introduced a shared os legend cache with listeners and refresh logic in use-os-layout to reduce redundant system calls, keep last-known-good values during transient failures, and expose a resolver with an isReady flag for keycap resolution.
2026-04-13 Add atomic sendCommand with fallback
    Introduce an atomic sendCommand path via a new Tauri command (kbhe_send_command) and a transport.sendCommand wrapper that uses invoke. KbheCommander now tries the atomic path first, caches availability, and falls back to the legacy write/read loop if the backend doesn't support it; also adds a short retry and small delay between attempts. In the Rust side, register the new command and make the input flush loop drain until empty. UI tweaks to DeviceBanner: improved layout, truncation, firmware version display, and disable/hide the Retry button while connecting.
2026-04-13 Refactor Lighting UI: KeyboardEditor + matrix preview
    Replace the old tabbed Effects/Matrix UI with a unified KeyboardEditor layout and live keyboard preview. Key changes:
    - Introduce KeyboardEditor wrapper and menubar, consolidate left/right columns into a single responsive layout.
    - Add keyboard preview that shows either a MatrixKeyboard (editable in matrix mode) or a read-only BaseKeyboard with per-key colors.
    - Remove tab state (activeTab) and related Tabs/ScrollArea code.
    - Add local cache helper (updateMatrixPixelsLocal) and update LED-related mutations (fill, clear, rainbow, upload) to update local matrix pixels and set React Query data instead of relying solely on refetches.
    - Adjus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
2026-04-13 refactor: calibration page, select outline, detect keybooard in updater mode
2026-04-13 feat: reset key trigger settings command
    [hid_protocol.c, hid_protocol.h, settings.c, settings.h]
2026-04-16 Add profiles, LED schema, rotary & HID APIs
    Introduce profile management, LED effect schema, rotary encoder state, and multiple HID/setting extensions across the firmware and tools.
    - Add persistent profile support: settings version bump, profile count/name/storage (settings_profile_t), active/profile mask and profile CRUD APIs.
    - Extend HID protocol: new command IDs for profile ops, rotary state, and related packet structs; expand key-settings packet with DKS (dynamic keystroke) fields, tap-hold options, SOCD fully-pressed fields, and rotary encoder bindings.
    - LED matrix overhaul: increase per-effect param count, add param schema types/descriptors and schema query API, add au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
    [debug_page.py, effects_page.py, firmware_updater.py, flash_storage.c, flash_storage.h]
2026-04-16 Add audio spectrum, flasher, and Windows Mica
    Introduce platform audio spectrum capture and firmware flashing, plus Windows Mica UI styling.
    - Backend: add a new src-tauri/src/audio.rs implementing WASAPI loopback capture, FFT (rustfft) based band extraction, AGC and per-band smoothing; expose tauri command kbhe_get_audio_bands. Add rustfft to Cargo.toml and register the command in lib.rs.
    - Backend: implement firmware updater flow in commands.rs (updater protocol, CRC32, transactions, data chunking, BEGIN/DATA/FINISH/BOOT/ABORT) and expose kbhe_flash_firmware; emits kbhe_flash_progress events for progress reporting. Handles switching device into bootloader, flashing, and recovery.
    - Fronte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
2026-04-16 ColorPicker pointer handling and KBHE commands
    Add proper pointer interaction handling to ColorPicker: track pointerInteractionRef, capture pointer down/up/cancel/lost events and only commit draft color when the pointer interaction finishes (also reset on popover close). Extend KBHE protocol and device API: add command enums for default profile and RAM-only operations and implement corresponding KBHEDevice methods (getDefaultProfile, setDefaultProfile, getRamOnlyMode, enterRamOnlyMode, exitRamOnlyMode) that use sendCommand and handle responses/timeouts.
2026-04-16 Async flash saves & third-party LED live mode
    Introduce non-blocking flash writes and deferred settings persistence, plus runtime-only LED streaming and WS2812 batching.
    - Add flash_storage asynchronous API: flash_storage_write_async_begin/step/is_busy and flash_storage_async_result_t to program flash in incremental steps.
    - Implement settings_request_save() and snapshot-based async save: settings_task() now schedules and drives async flash writes (configurable words/step), preserves a snapshot to avoid races, and handles save-in-progress state. settings_save() will wait for in-progress async completion when called synchronously.
    - Keep settings non-blocking in HID handlers by switching CMD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
    [flash_storage.c, flash_storage.h, hid_protocol.c, led_matrix.c, led_matrix.h, settings.c, settings.h]
2026-04-16 Add runtime profile management
    Introduce runtime profile management and synchronization between app and device. Adds new modules profile-runtime and profile-sync to capture/apply firmware profile snapshots and to activate temporary app (RAM-only) profiles or device slots. Extend device session state to track profile names, used mask, active/default indexes and ram-only mode, add KBHEDevice.ping(), and improve presence polling logic to use ping with failure tolerance and adaptive intervals. Update query keys to include profile/context parameters and wire runtime/profile context through ProfileSelect, Profiles, Keymap, AdvancedKeys, Performance, and related hooks so queries and mutations targe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
2026-04-16 Alpha mask, audio, protocol & UI improvements
    Introduce alpha-key masking and audio/LED enhancements and various UI fixes.
    Details:
    - Add useAlphaMaskService: computes per-key alpha bitmask from OS layout and base layer keycodes and sends SET_LED_ALPHA_MASK to device when ALPHA_MODS is active.
    - Protocol & device API: add SET_LED_ALPHA_MASK command, BASS_RIPPLE effect, ENUM param type; extend KBHEDevice with DeviceOptions, getOptions, setOptions, setLedThermalProtectionEnabled and setAlphaMask.
    - Profile sync: applyFirmwareProfileSnapshot now uses setOptions and supports led_thermal_protection_enabled.
    - Audio spectrum service: smoother, timed loop with envelope tracking; supports IMPACT_RA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
2026-04-16 Add bass ripple, alpha-mask & audio updates
    Introduce a new bass-triggered LED effect and multiple LED/audio protocol/features updates.
    - Add new Bass Ripple effect (Core/Src/led_effects/effect_bass_ripple.inc) for audio-triggered expanding rings.
    - Add RAW HID command CMD_SET_LED_ALPHA_MASK and handler to push per-key alpha masks; expose led_matrix_set_alpha_mask API.
    - Enhance alpha-mods effect to use host-provided alpha mask (falling back to A-Z HID usages) and add parameter/scale tweaks.
    - Extend audio spectrum effect: new ripple/kick handling, visualizer mode 4, added params (ripple width, kick color), envelope/kick detection and rendering improvements.
    - Add LED thermal protection opt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
2026-04-16 Add effect param names and group effects UI
    Add missing effect parameter names and enum options for multiple colorband, pinwheel, spiral, starlight and reactive effects in effectParamNames. Simplify several LED effect display names in the protocol mapping. Revamp the Lighting UI to canonicalize equivalent effect IDs, hide duplicate variants, and group effects into defined categories (with an "Other" fallback). Update the effect selection to use canonical IDs, adjust the RadioGroup layout to render categories and effects, and add utility helpers for grouping and canonicalization.
2026-04-16 Add LED alpha mask and thermal protection option
    Expose LED thermal protection in the HID options and add support for a host-controlled LED alpha mask. Changes include: new CMD_SET_LED_ALPHA_MASK (0x7A) in the protocol header, added led_thermal_protection_enabled to hid_packet_options_t and GET/SET handlers, implementation of cmd_set_led_alpha_mask with compatibility for a reserved byte, input validation and call to led_matrix_set_alpha_mask, and dispatcher integration. Documentation (RAW_HID_PROTOCOL.MD) updated to document the new option and command (including thermal protection behavior and mask semantics). The host tool (kbhe_tool/device.py) is updated to parse the new option from GET_OP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
2026-04-19 Add trigger chatter guard, LED idle & layer map
    Introduce anti-chatter guard, LED idle timeout/policies, and per-layer gamepad mapping. Adds new HID protocol commands/packet types for trigger chatter guard and LED idle options and extends key-gamepad packet to include a layer mask. Settings gained storage/API for chatter guard, LED idle timeout, system-indicator policy, and third-party-stream activity; sanitization and persistence logic updated. Trigger logic now enforces a per-key transition guard to suppress chatter; layout and gamepad code respect mapping layer masks. LED engine updated to support idle auto-off, allow system overlays while idle, treat third-party streams as activity, and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
2026-04-19 Add close-lighting, LED idle, gamepad layers, chatter guard
    Introduce a close-lighting feature and several device/UI improvements:
    - Add useCloseLightingService to apply a user-selected LED effect on window close and optionally restore the previous effect on next startup; register it in AppShell.
    - Persist close-lighting preferences and restore snapshots in app-startup utilities.
    - Extend protocol with new constants and commands (LED idle options, trigger chatter guard, gamepad layer mask helpers).
    - KBHEDevice: add get/setTriggerChatterGuard, get/setLedIdleOptions, gamepad layer mask handling, sanitize helpers, and related types.
    - Update query keys for new device queries (triggerChatterGu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
2026-04-19 Clear WS2812 LEDs when output disabled
    WS2812 LEDs retain the last frame until a new one is transmitted. When output is fully disabled (for example when a Caps Lock overlay turns off), explicitly zero the LED buffer and call ws2812_show to push a black frame and clear stale indicator pixels. This adds zeroLedValues(&led_ws2812_handle) and ws2812_show(&led_ws2812_handle) to the early return path in update_ws2812.
2026-04-24 Optimize gamepad mapping caching and curve LUT
    Add caching and lookup structures to speed up gamepad HID processing. Introduces cached_mapped_layers_mask, per-layer lists/counts of mapped button/axis keys, and a cached_curve_lut with helpers to rebuild/apply it. Adds helpers: gamepad_has_custom_axis_activity, gamepad_clear_cached_mapping_indices, gamepad_rebuild_curve_lut, and gamepad_apply_curve_cached. Initialize/rebuild caches on init and settings reload; populate per-layer key indices during reload. Refresh logic now early-exits if no mappings or custom inputs are active and iterates only relevant per-layer keys instead of scanning all keys; analog curve application uses the LUT. Also in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
2026-04-24 Add gamepad legend overlay to keyboard preview
    Introduce a keyLegendOverlayMap to render gamepad/keyboard combined overlays on key previews. Prop is threaded through BaseKeyboard → KeyboardLayout → KeyboardKey, with CSS for overlay styling. useKeyboardPreviewLegends now fetches per-key gamepad maps (batched), device options and gamepad settings, and builds slot maps plus overlay nodes that show split keyboard/gamepad legends when appropriate. KeycodeAccordion now supports multiple selected codes and KeycapButton selection visuals. Keymap, AdvancedKeys, Gamepad and Performance pages updated to pass overlays and display focused gamepad info; added query key for fetching all gamepad key map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
2026-04-25 Add tinyusb submodule and fix firmware path
    Add tinyusb as a git submodule at firmware/lib/tinyusb (subproject commit b209b177ecc41ca733a4420c60fb7c1170be2342). Fix firmware binary lookup in host/kbhe_tool/ui/firmware_page.py by changing pathlib parents from [2] to [3] so default_bin correctly points to build/Release/kbhe.bin.
    [firmware_page.py]
2026-04-25 Add gitattributes, update ignores, tidy PCB/libs
    Normalize project files and clean up repository: add .gitattributes for KiCad text files and update .gitignore to exclude backups, generated outputs and production artifacts. Remove many large binary backups and unused images/zips to reduce repo clutter. Add Assets images, multiple 3D models and KiCad library footprints/symbols (new Library and PCM_JLCPCB entries), and legacy project exports. Update 75he.kicad_pcb to use ${KIPRJMOD} model paths, remove redundant units/zone_defaults blocks, simplify switch attributes, hide heavy 3D models, and make small footprint fixes (fp_poly -> fp_rect, pad coordinate precision and UUID updates). Also add R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
    [mcu.kicad_pcb, mcu.kicad_sch, proto_pcb.kicad_pcb, proto_pcb.kicad_sch, proto_pcb_avant_led.kicad_pcb, switch.kicad_sch]
2026-04-26 Reorganize KiCad libraries; add Legacy Docs
    Large repository reorganization of KiCad assets: added Docs and Legacy/ proto directories with many component datasheets and legacy project files, moved and renamed numerous footprints, 3D models and symbol files into consolidated Library/ and Legacy/ paths, and removed outdated/duplicate files. Purpose is to centralize libraries, preserve legacy designs, and clean up footprint/3D model locations for easier maintenance.
    [mcu.kicad_pcb, mcu.kicad_sch, mux.kicad_sch, proto_pcb.kicad_pcb, proto_pcb_avant_led.kicad_pcb]
2026-04-26 Add USB-suspend RGB-off LED option
    Introduce an option to force the LED matrix off during USB suspend and restore it on resume. Changes include:
    - Protocol: Add HID commands GET_LED_USB_SUSPEND_RGB_OFF (0x7D) and SET_LED_USB_SUSPEND_RGB_OFF (0x7E) and document them in RAW_HID_PROTOCOL.MD.
    - Firmware: bump settings version (0x001D -> 0x001E) and firmware version (v1.8.0 -> v1.9.0). Add settings getters/setters and persistence for a USB-suspend RGB-off flag stored in LED metadata; include migration and sanitization logic. Expose settings API functions settings_is_led_usb_suspend_rgb_off_enabled() and settings_set_led_usb_suspend_rgb_off_enabled().
    - LED engine: add usb_suspend_active state, r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
2026-04-26 Update assets, ESLint, and pages
    Add PNG app icon and switch index.html to use it; remove unused SVG assets and ignore the .cursor folder (remove .cursor/mcp.json). Expand ESLint global ignores and disable several strict rules to reduce noisy errors (@typescript-eslint/no-explicit-any and multiple react-hooks/react-refresh rules). Rename page files to PascalCase (Gamepad, Profiles) and apply small updates across components, hooks and lib code (AutosaveStatus, key-tester, color-picker, hooks, kbhe protocol/device, parser, and various pages) plus a package.json update.
2026-04-26 Code formatting: whitespace and indentation fixes
    Minor formatting changes in KBHEDevice and Lighting components to match project style/linter. device.ts: adjust constructor brace spacing. Lighting.tsx: fix indentation for enum fallback expression and normalize spacing in an empty onLiveChange arrow handler. No functional changes.
2026-04-26 Import and organize KBHE projects
    [20260408_231954_mesurepcbninokey1piedacoulissealamano.csv, 20260409_001242_validation_report_errors.csv, 75he.kicad_sch, adc_key_1_3cycle_12bit_500ns.csv, adc_key_1_3cycle_12bits_500ns_100nF-10uF.csv, adc_key_1_3cycle_12bits_500ns_100nF-10uF_2.csv, adc_key_1_3cycle_12bits_500ns_100nF-10uF_without_usb.csv, adc_key_1_3cycle_12bits_500ns_100nF_2.csv]
2026-04-26 Add mechanical 3D assets
    [75HE Assemblage.f3z, 75HE Assemblage.step, 75HE Assemblage.stl, 75HE Bottom Case.f3d, 75HE Bottom Case.step, 75HE Bottom Case.stl, 75HE Knob.f3d, 75HE Knob.step]
2026-04-26 Track binary assets with Git LFS
2026-04-26 Display app version and restrict dev firmware UI
    Bump configurator version to 0.1.1 (package.json, Cargo.toml, tauri.conf.json). Add Tauri app version query in AppSettings and show an "About" card with the app version. Gate firmware file picker and flash button behind developerMode and only render the flash panel when developerMode is enabled or a flash is in progress / has logs. Add IDE/bundle settings files (.settings/* and firmware/.settings/*) to the repo.
2026-04-26 Bump firmware to v2.0.0 and update README TODOs
    Increase FIRMWARE_VERSION from 0x0109 (v1.9.0) to 0x0200 (v2.0.0) in firmware/Core/Src/settings.c. Add a "Current limitations - TODOs" section to README.md listing known hardware/firmware tasks (transparent keycap side LEDs, enter key stabilizer collision, hide DFU switch, wireless build, underglow, reversed-mounted LEDs, mounting hole adjustments, reduce PCB layer count, add libhmk support, and final 3D model tolerance/top-case tweaks).
    [settings.c]
2026-04-26 Use semver (major.minor.patch) for firmware
    Switch firmware versioning from a 16-bit value to semantic version components (major.minor.patch) across firmware, bootloader, updater protocol and the configurator. Bump updater protocol to v2 and adapt begin/hello/trailer payloads and structs to carry three version bytes; update firmware trailer/metadata parsing and validation to use packed 24-bit version. Update firmware source to expose FIRMWARE_VERSION_MAJOR/MINOR/PATCH and record packed metadata; update settings, updater_shared, hid_protocol, updater_bootloader and related C code accordingly. Update frontend types and logic (FirmwareVersion type, formatFirmwareVersion, parsing of device info/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
2026-04-26 Enhance README with assets and flash guide
    Add assembly renders, product photos and exploded CAD views to the top-level README, and document the top-level assets/ folder. Clarify PCB/CAD section and add image tables for renders and legacy prototypes. Include first-time board programming guidance (DFU + STM32CubeProgrammer) and link to firmware docs; also update docs/README.md with direct links to firmware overview and raw HID flashing instructions.
2026-04-26 Reorganize assets and update README images
    Move and rename many image assets into a clearer folder structure (assets/photos/* and assets/cad/75he-exploded/) and add several new photos (PCB top/bottom, MCU test boards, TIPE multiplexer, configurator screenshot, workshop images). Update README.md to point to the new paths, add a 75HE v1.0 PCB photo section and TIPE board callout, expand build/lab photo tables, and clarify the assets folder description. These changes keep documentation images organized and surface new hardware photos for the project.
2026-04-26 Revise current limitations and TODOs in README
    Updated limitations and TODOs for hardware improvements.
2026-04-26 Relocate PCB render images and update README
    Move PCB render PNGs out of assets/exports/renders into their parent assets/ directories for proto-6-key-hall-sensors, proto-mcu-v1, and proto-mcu-v2 (file content unchanged). Update README image links to point to the new paths so the rendered previews resolve correctly.
2026-04-26 Bump to v0.1.4 and add update banner
    Bump app version to 0.1.4 (package.json, Cargo.toml, tauri.conf.json). Add an UpdateBanner component that checks for app and firmware releases (react-query), shows a notice with actions to open updates, and provides a refresh button. Wire the banner into AppShell. Add Tauri permission core:window:allow-set-theme and enhance ThemeProvider to sync the app theme to the native window via getCurrentWindow().setTheme (guarded by isTauri()).
2026-05-23 Add 75he legacy PCB KiCad projects
    Introduce hardware/pcb/75he/Legacy containing source-only KiCad project archives for proto-6-key-hall-sensors, proto-mcu-v1, and proto-mcu-v2. Each project includes reduced local libraries (Library/Footprints, Library/Symbols, Library/3D), fp-lib-table/sym-lib-table, KiCad project files (.kicad_pcb, .kicad_sch, .kicad_pro, .kicad_dru) and selected footprints/3D models. Add a README that documents the folder purpose and local project structure and notes that generated outputs and caches were removed to keep these as lightweight, openable archives.
    [mcu.kicad_pcb, mcu.kicad_sch, proto_pcb.kicad_pcb, proto_pcb.kicad_sch, proto_pcb_avant_led.kicad_pcb]
2026-06-11 chore: lut improvement & script update
    [20260408_231954_mesurepcbninokey1piedacoulissealamano.csv, 20260409_001242_validation_report_errors.csv, key0_angle_corrected_v1.csv, key0_angle_corrected_v1_offset_0.csv]
2026-06-11 fix: missing LUT zero reference value
    [calibration.h, settings.c]
2026-08-21 fix(firmware): fix wrong SOCD resolution to neutral, when simultaneous key press & bump version to 2.0.5
    [settings.c, trigger.h]
2026-08-22 fix(firmware): include stddef in standalone C units
    [rotary_encoder.c]
2026-08-22 fix(ci): validate PowerShell code-signing EKU
2026-08-22 fix(ci): pin Windows release runners
2026-08-22 refactor(ci): isolate Authenticode preflight stages
2026-08-23 fix(firmware): stop dropping keystrokes in the input path
    Three regressions introduced with the v2.0.6 overhaul could each swallow a
    keystroke between the sensor and the host.
    Calibration normalization saturated the logical travel on the peak captured
    during guided calibration, which is not the mechanical end of travel. Every
    position deeper than that peak reported the same value, and rapid trigger is
    purely differential, so no press and no release could be detected inside that
    flat zone: bottoming out hard swallowed the keystroke. Extrapolate past the
    calibrated reference instead. The relation is unchanged below the peak; only
    the previously flat region differs. trigger_get_distance_01mm()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
    [analog.c, main.c]
2026-08-23 feat(firmware): bound concurrent macro instances with a trigger FIFO
    Every macro slot previously owned a dedicated runtime instance, so all 16
    programs could execute at once and layout had to track one output owner per
    slot. Cap concurrency at 4 instances and absorb the surplus in a fixed,
    allocation-free FIFO instead, so a burst of triggers is queued rather than
    refused by an allocation failure that the old comment called unreachable.
    Ordering and lifetime semantics are preserved. A new physical edge is queued
    behind triggers already accepted while the pool was full, so it cannot
    overtake them. A momentary program whose trigger is released while it waits is
    dropped at drain time rather tha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
    [action_engine.c, action_engine.h, action_engine_test.c, action_protocol_test.c, profile_document_store_test.c]
2026-08-24 fix(firmware): queue keyboard snapshots and overlap ADC scans
    [keyboard_hid_queue_test.c, keyboard_nkro_hid.c, led_matrix.h, main.c]
2026-08-24 fix(firmware): defer persistence outside live input
    [action_engine.c, action_engine.h, action_engine_test.c, keyboard_nkro_hid.c, main.c]
2026-08-25 test(host): cover device identity wire layout
2026-08-25 fix(host): identify shipped 2.0.0 firmware safely
    [test_device_protocol.py]
2026-08-25 fix(protocol): align host filter defaults
    [settings.h, test_device_protocol.py]
2026-08-25 fix(rgb): make overlay transitions continuous
    [led_matrix.c, led_overlay_math.h, led_overlay_math_test.c]
2026-08-25 fix(input): keep filter smoothing parameters canonical
    [board_config.h, debug_page.py, filter.c, filter.h, filter_test.c, test_device_protocol.py]
2026-08-25 feat(updater): migrate legacy v2 devices safely
2026-08-25 fix(actions): isolate runtime macros across profiles
    [action_engine.c, action_engine.h, action_engine_test.c, action_protocol.c, action_protocol.h, action_protocol_test.c]
2026-08-25 fix(settings): sanitize persisted filter parameters
    [settings.c]
2026-08-25 fix(firmware): recover failed USB reports
    [consumer_hid_test.c, gamepad_hid_transport_test.c, keyboard_hid_queue_test.c]
2026-08-25 fix(scan): prioritize ADC snapshots around USB service
    [main.c, realtime_scan_policy.h, realtime_scan_policy_test.c, tusb_config.h]
2026-08-25 test(input): run filter regression in host suite
2026-08-25 fix(configurator): gate incompatible device sessions
2026-08-25 fix(release): pin current firmware key fingerprint
2026-08-25 fix(firmware): preserve key events across HID route changes
    [keyboard_hid_queue_test.c, keyboard_nkro_hid.c]
2026-08-25 fix(input): make sensor auto-zero stable
    [analog.c, analog.h, analog_rest_estimator_test.c, hid_protocol.c, hid_protocol.h, rest_estimator.c, rest_estimator.h]
2026-08-25 fix(firmware): accelerate boot image validation
    [main.c]
2026-08-25 fix(firmware): enumerate XInput as one wired controller
2026-08-25 fix(tools): avoid rounded threshold loss false positives
    [test_hil_input_logger.py]
2026-08-25 fix(input): allow equal actuation and release points
    [settings.c, settings.h, trigger.h, trigger_threshold_test.c]
2026-08-25 fix(input): keep thermal ADC sampling from stalling keys
    [internal_sensor_sampler.c, internal_sensor_sampler.h, internal_sensor_sampler_test.c, main.c, scan_watchdog.h]
2026-08-25 feat(diagnostics): expose ADC scan recoveries
2026-08-25 fix(diagnostics): amortize analog timing profile
    [analog.c, analog_diagnostic_profile_policy_test.c, diagnostic_profile_policy.h]
2026-08-25 feat(firmware): add autonomous all-key input trace
2026-08-25 revert(firmware): remove production all-key input trace
    [adc_capture.c, adc_capture.h, adc_capture_test.c, analog.c, hid_protocol.c, hid_protocol.h]
