Fefe-Nayz/kbhe-monorepo/assets/photos/tipe-lab/research-lab-ambient-panorama.jpg

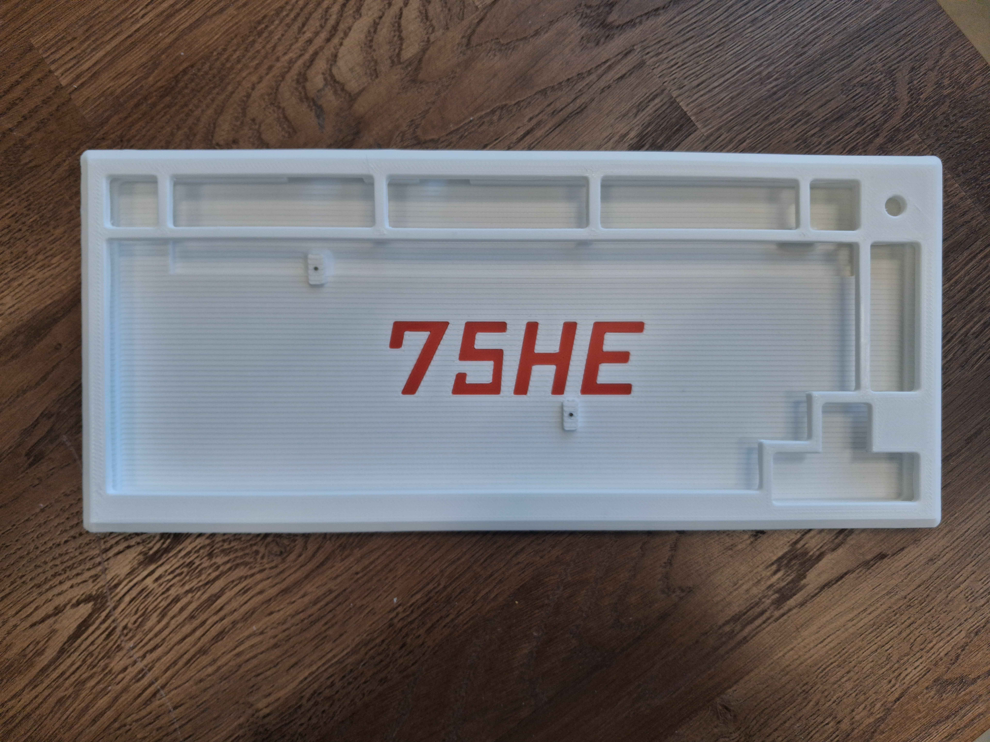
assets/photos/tipe-lab/research-lab-ambient-panorama.jpg
