Fefe-Nayz/kbhe-monorepo/assets/PXL_20260414_183230103.RAW-01.COVER.jpg

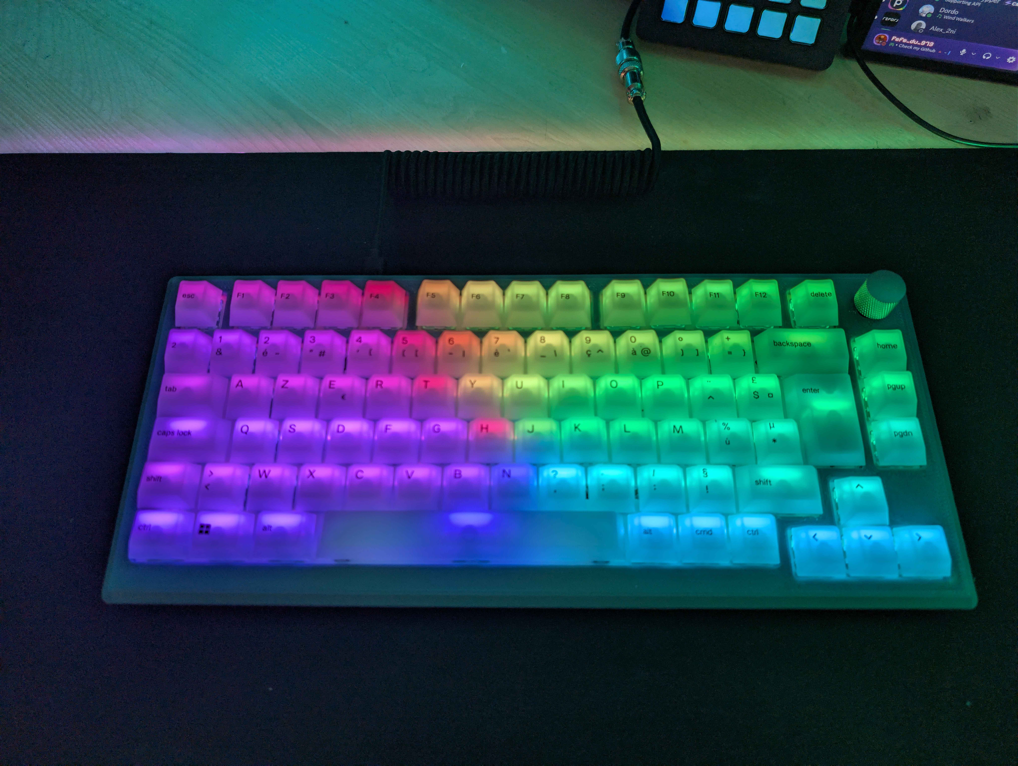
[picture p14: assets/photos/tipe-lab/bench-session-wide-1.jpg]
assets/PXL_20260414_183230103.RAW-01.COVER.jpg
