Fefe-Nayz/kbhe-monorepo/assets/PXL_20260414_183249586.RAW-01.COVER.jpg

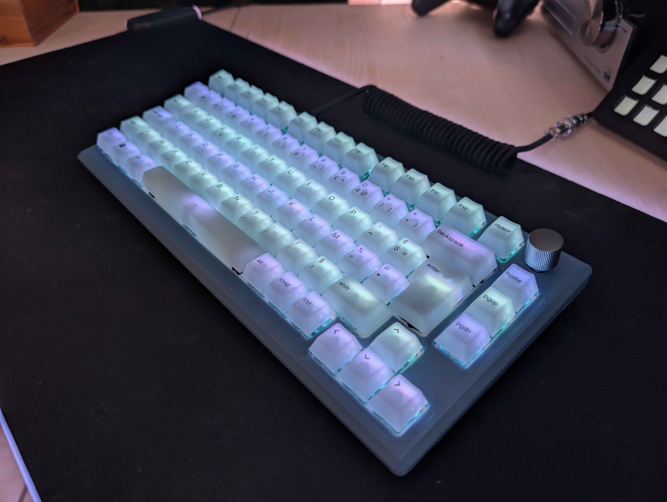
[picture p15: assets/photos/tipe-lab/bench-session-wide-2.jpg]
assets/PXL_20260414_183249586.RAW-01.COVER.jpg
