Fefe-Nayz/kbhe-monorepo/assets/PXL_20260414_183329722.RAW-01.COVER.jpg

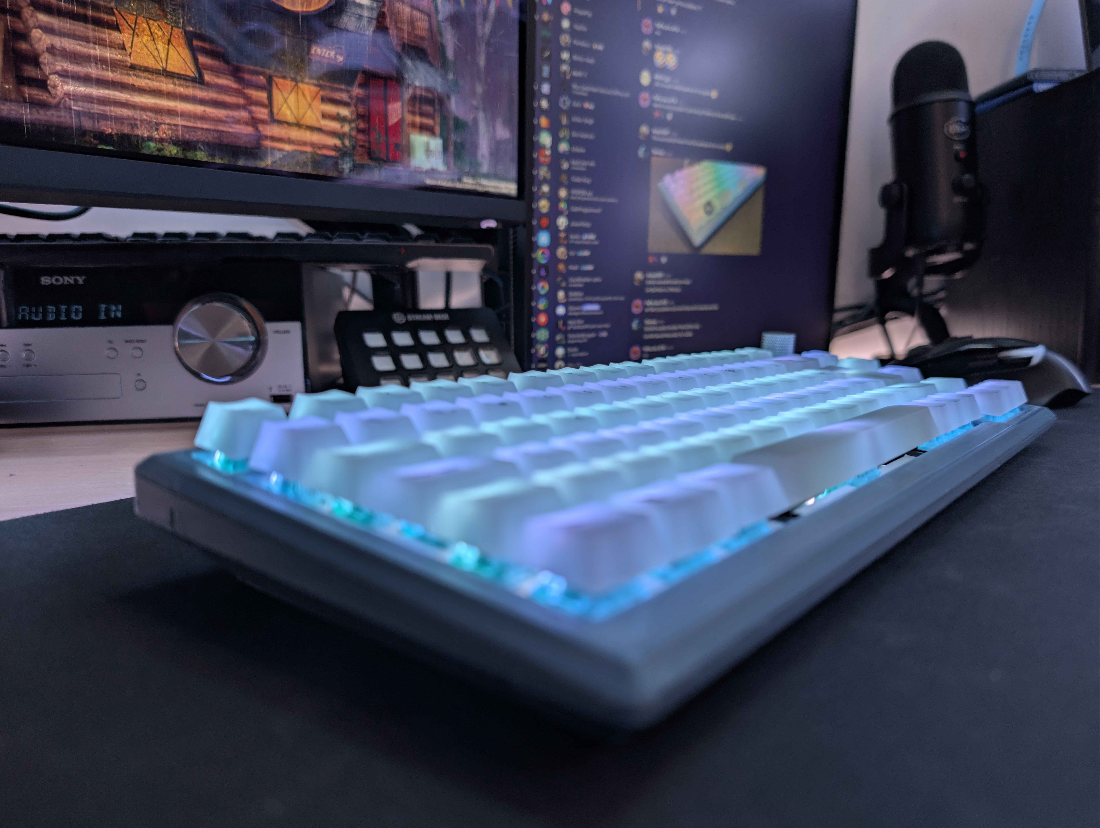
[picture p16: assets/photos/tipe-lab/bench-session-wide-3.jpg]
assets/PXL_20260414_183329722.RAW-01.COVER.jpg
